tinymachines/nes-bench/docs/b0-report.md

# B0 report: the sniff, machine side closed, the part's side waiting on the build

Written 2026-09-06. Plan: `docs/bench-plan.md`, first. Nothing here has
touched the part yet: the bridge is not built. What closed is
everything B0 could close on the machine, and one thing B0 was going
to measure on the part turned out to be measurable on the die first,
which changed the model.

## What exists

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

## Added 2026-09-07: the head, and the script on both sides

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

## Added 2026-09-07: the B1 tool, green on the synthesis before any capture

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

Its own green run (`SYNTH_TRIGGER=1`): six frames synthesised through
the card model, the fourth scored, the synthesis sliced from inside the
third as a trigger placed there would be, 13 of 13 regions on the bars
cartridge at every frame count tried across its luma-row step.
`MUTATE_TRIGGER=1` slices one frame late and is 1 of 13 at the step
(frames 122), which is what shows the frame selection is checked and
not only the colours; the public site's boarding runs both and refuses
to board if the mutation is not red. `nes` @ 59d42c8.

## Added 2026-09-07: the B2 classifier, green on its own synthesis

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

Its gate (`selftest`): the three channels synthesised for 72
alignments at the head's three-channel rate with the measured pin
offsets, every one read back as its class; the synthesised ALE shifted
one half-step (MUTATE) moves the class on all 24. Then the whole path
through the head: `tools/fake-scope.py` answers the head's SCPI with
those synthesised records, a B2 script (power off, arm three channels
on ALE's first rise, power on, capture) played three times by `sweep`,
each run fetched and classified as the alignment the fake was given.
The head's ARM took a channel list, a trigger source, a timebase and a
depth for it (the DS1054Z holds 6 M points at most with three channels,
so B2's window is 6 ms at 1.2 M; B1's stays 60 ms at 12 M on one).

What only the bench can say: whether the part's histogram over a
hundred power-ons is flat over its classes or prefers some, which is
B2's first gate, and whether the model's (4, 3) is among them.

## Added 2026-09-07: the B3 tools, a planted divergence found

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

## What the die said before the part could

The gate asked for clocks per latch on the part, expecting nine where
a DMC fetch lands on a poll's read. That is a question the switch-level
2A03 can answer, so it was asked first (`2a03`'s
`joy-clock-probe`, `docs/n3-report.md` there):

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

Three changes followed, each with a test that fails without it:

- Rung 3 of the 6502 (`tinymachines/6502` @ 89ae24f) re-asks its bus
  at every phi2 of a read held by RDY and keeps the last byte, which is
  what DL does; `MUTATE_HELD=1` keeps the first and is red.
- The 2A03's rung (`tinymachines/2a03` @ dbf116b) answers those re-asks
  from a memo while the core is held and lets one through on the
  re-run, unless the alias rule holds; `tests/joypad.rs` holds the
  rung's asks per instruction to the die's /OE1 pulses over two
  cadences, {1: 2820, 2: 6} and {1: 2245, 2: 4}, instruction for
  instruction; `MUTATE_QUIET=1` (five asks per collision) is red.
- The console (`tinymachines/nes` @ 2ec0fc3) logs polls; on the
  polling cartridge with the DMC loop the model predicts nine-read
  polls at 21 of 596 latches over 600 frames, recorded in
  `tests/pad_log.rs`.

So the B0 gate's third bullet, the model's DMC fetch schedule beside
the part's nine-clock polls, now has a prediction with an exception the
documentation does not mention. The part decides.

## What B0 still needs from the bench

In the plan's order, once the bridge is built per `docs/wiring.md` and
its "measure first" list is done:

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

None of it can be faked here, and the report says so.
