tinymachines/nes-bench/docs/IMG_5660.jpeg

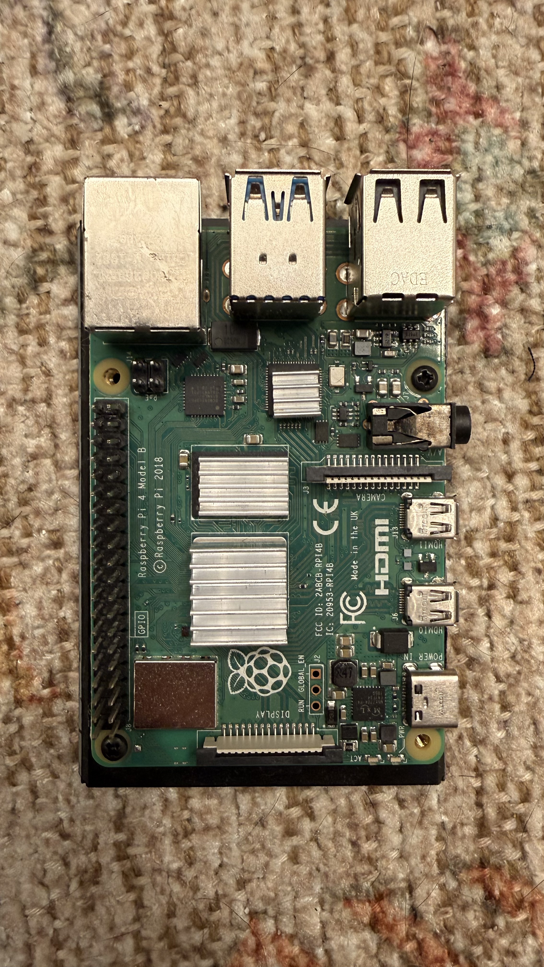
docs/IMG_5660.jpeg
