tinymachines/nes-bench/docs/IMG_5661.jpeg

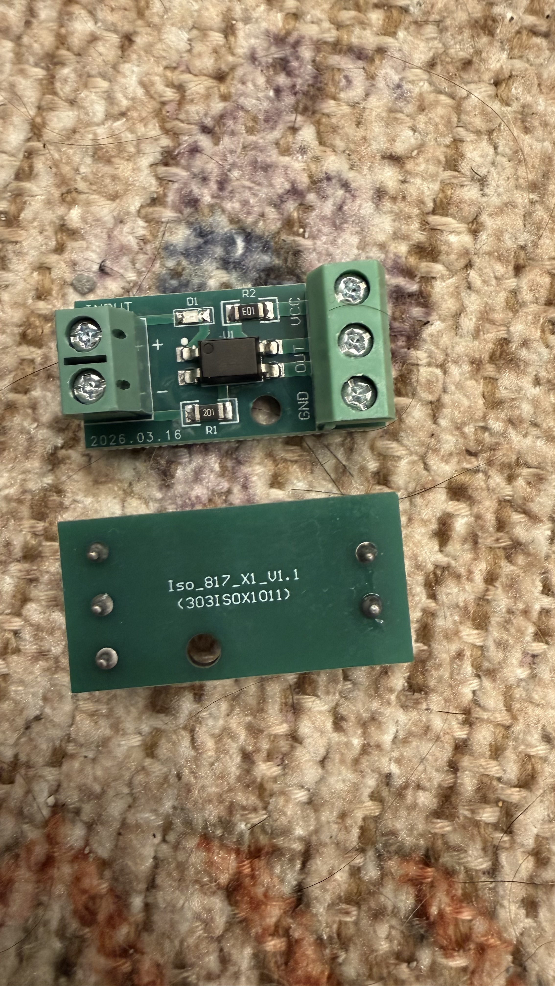
docs/IMG_5661.jpeg
