tinymachines/nes-bench/docs/IMG_5662.jpeg

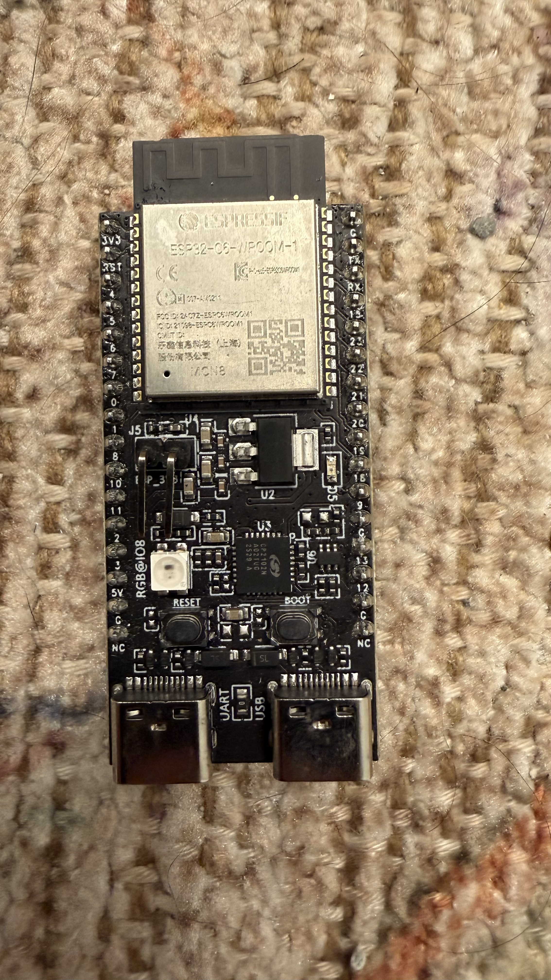
docs/IMG_5662.jpeg
