tinymachines/nes-bench/docs/IMG_5664.jpeg

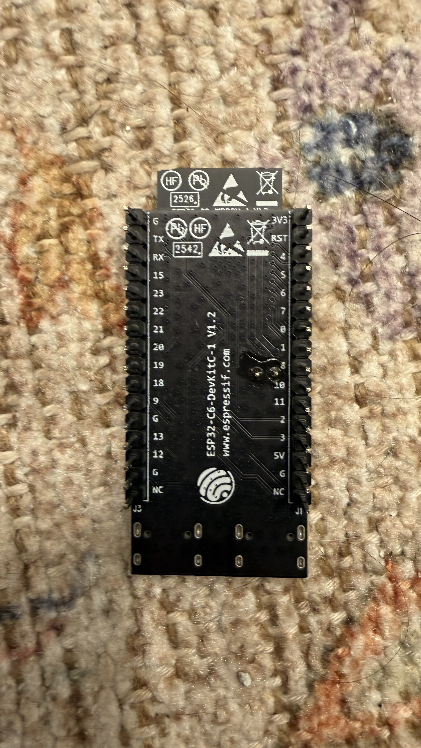
docs/IMG_5664.jpeg
