tinymachines/nes-bench/docs/IMG_5665.jpeg

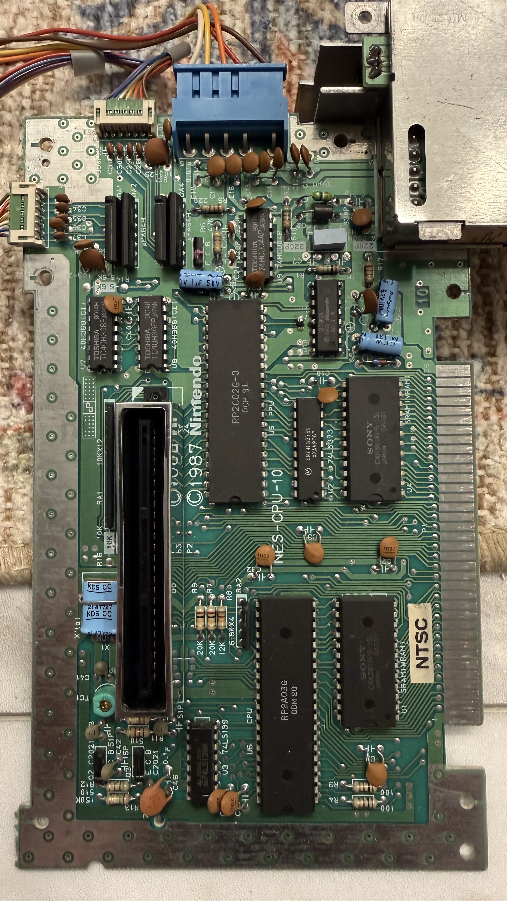
docs/IMG_5665.jpeg
