tinymachines/nes-bench/docs/IMG_5666.jpeg

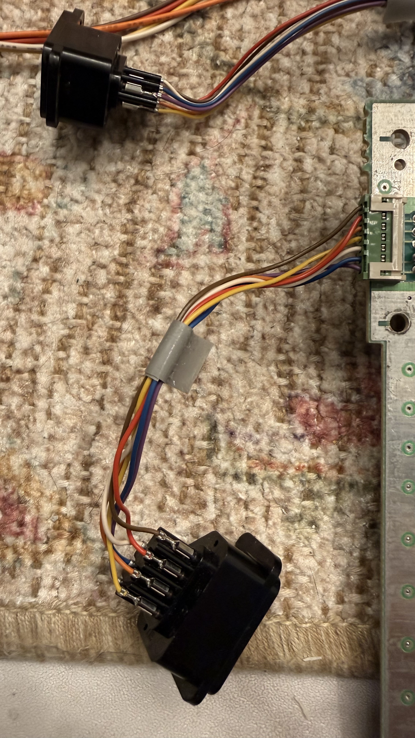
docs/IMG_5666.jpeg
