tinymachines/nes-bench/docs/IMG_5667.jpeg

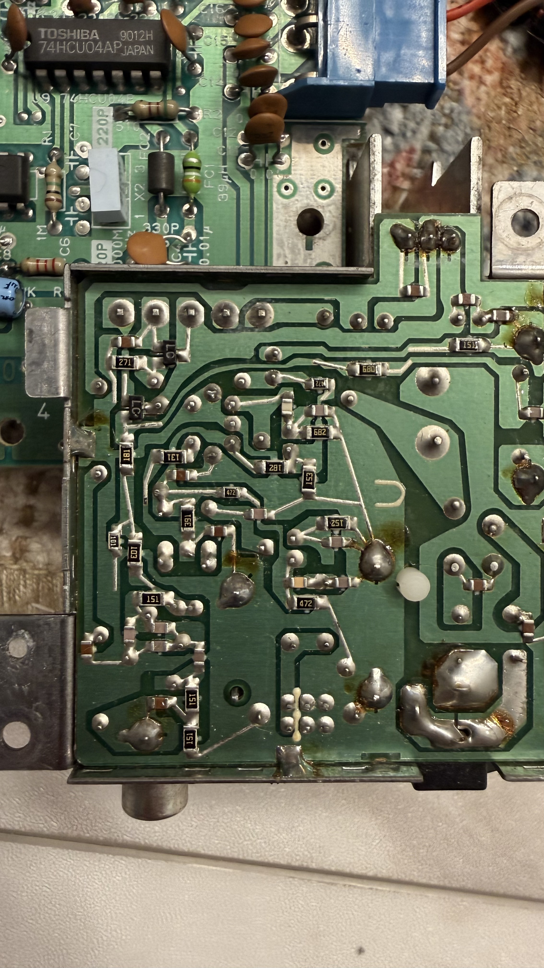
docs/IMG_5667.jpeg
