tinymachines/nes-bench/docs/IMG_5668.jpeg

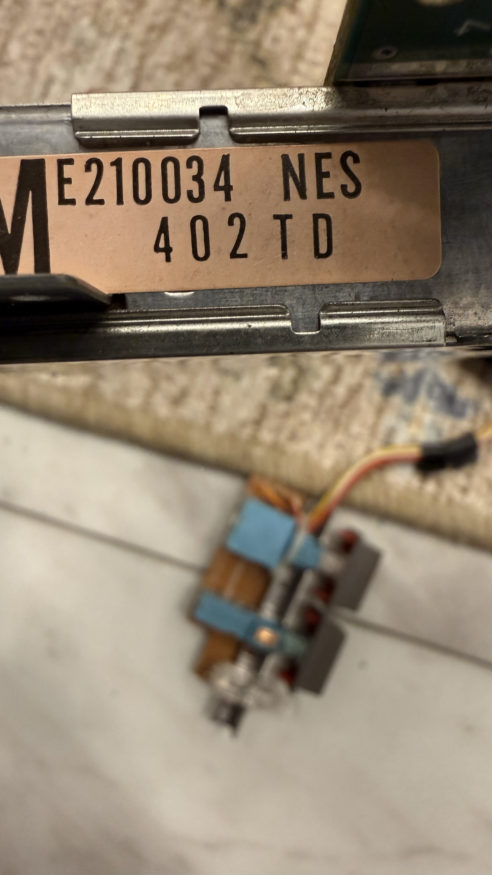
docs/IMG_5668.jpeg
