tinymachines/nes-bench/docs/IMG_5669.jpeg

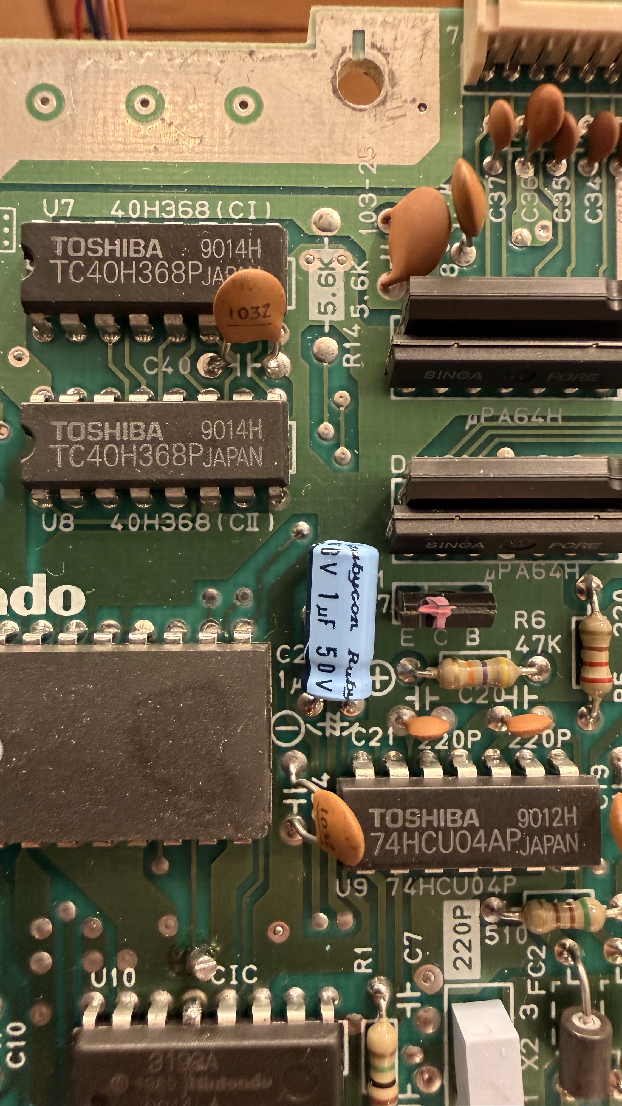
docs/IMG_5669.jpeg
