tinymachines/nes-bench/docs/IMG_5670.jpeg

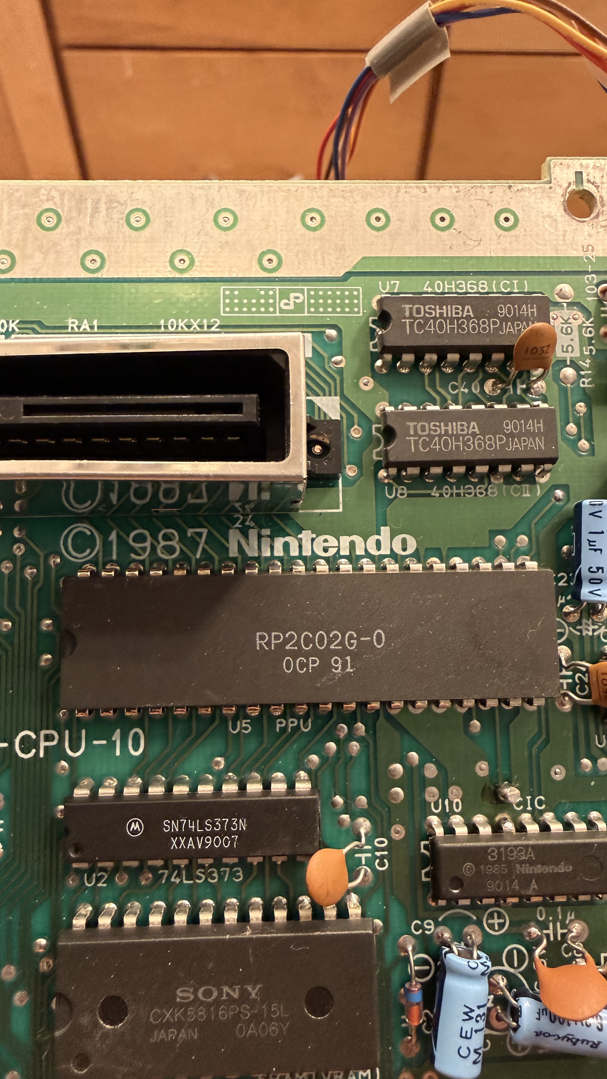
docs/IMG_5670.jpeg
