tinymachines/nes-bench/docs/IMG_5671.jpeg

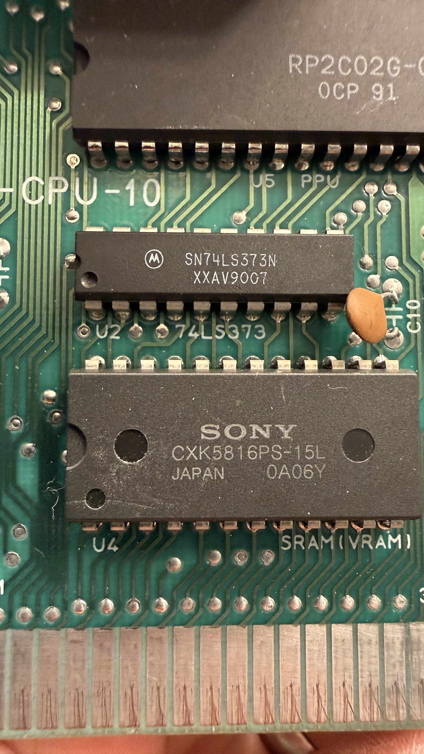
docs/IMG_5671.jpeg
