tinymachines/nes-bench/docs/IMG_5672.jpeg

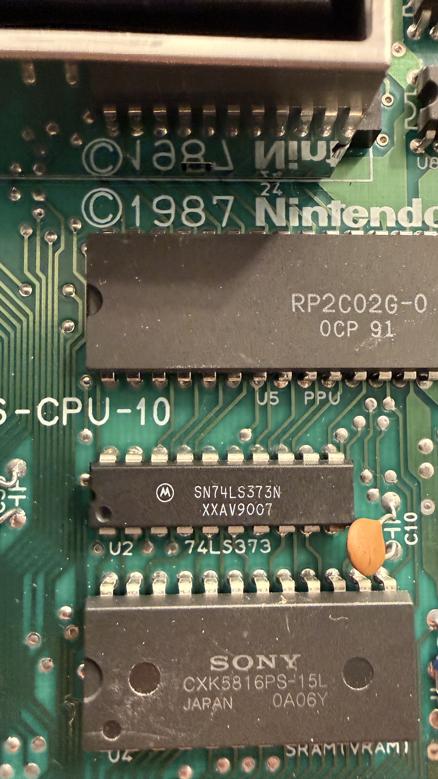
docs/IMG_5672.jpeg
