tinymachines/nes-bench/docs/IMG_5673.jpeg

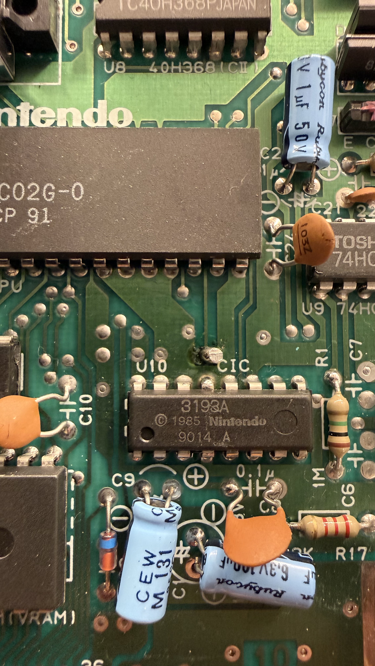
docs/IMG_5673.jpeg
