tinymachines/nes-bench/docs/IMG_5674.jpeg

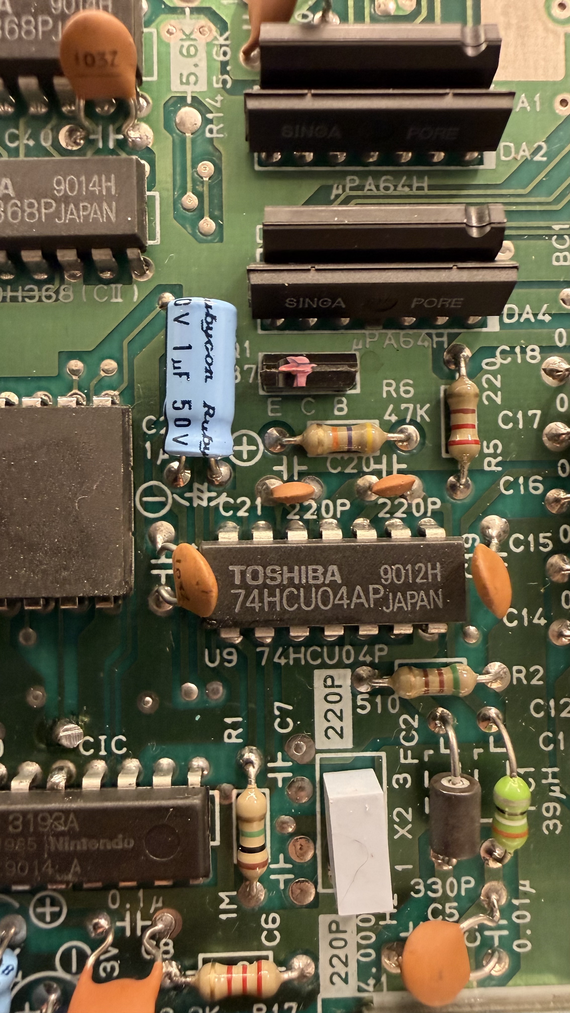
docs/IMG_5674.jpeg
