tinymachines/nes-bench/docs/IMG_5675.jpeg

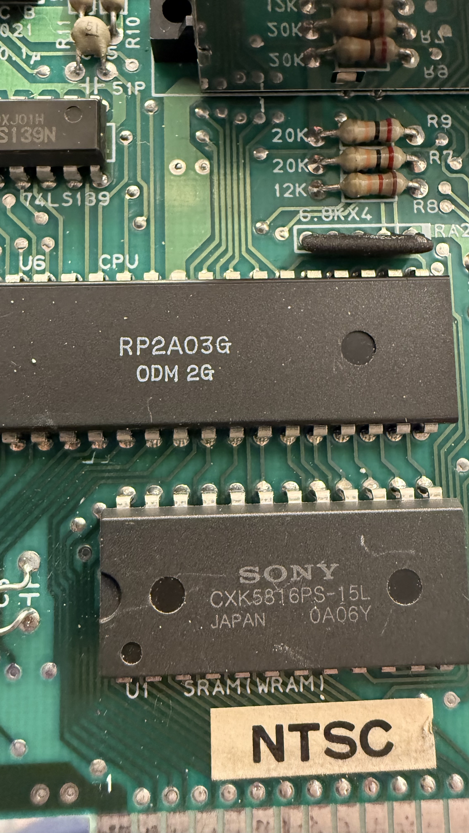
docs/IMG_5675.jpeg
