tinymachines/nes-bench/docs/lab/06-modules-laid-out.jpg

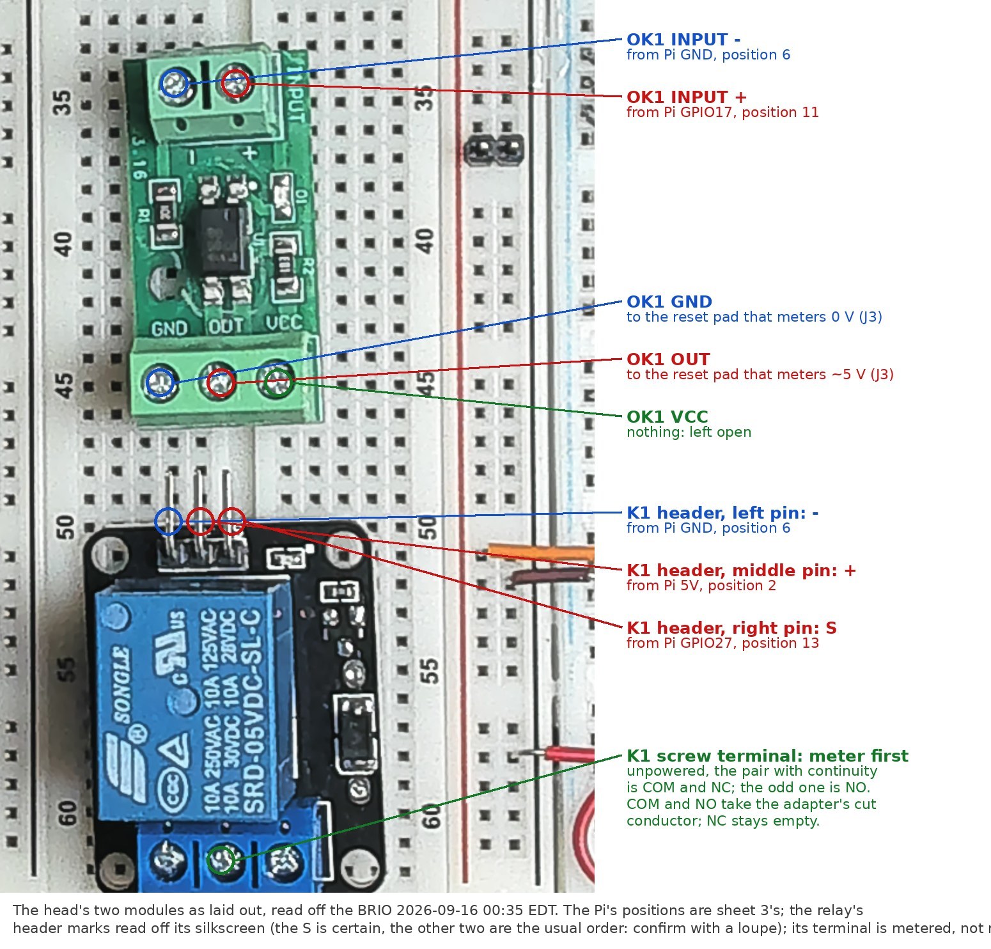
docs/lab/06-modules-laid-out.jpg
