tinymachines/nes-bench/docs/lab/rig-side-eye-9000.jpg

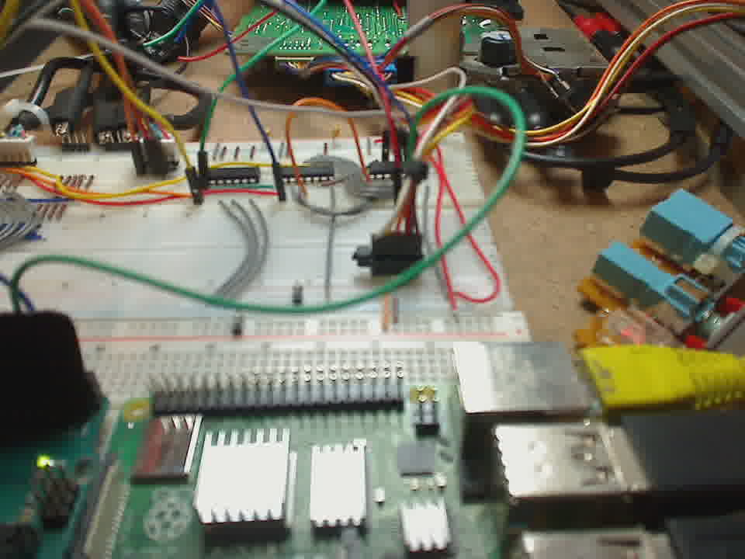
docs/lab/rig-side-eye-9000.jpg
