tinymachines/nes-bench/docs/lab/rig-side-eye-communicate.jpg

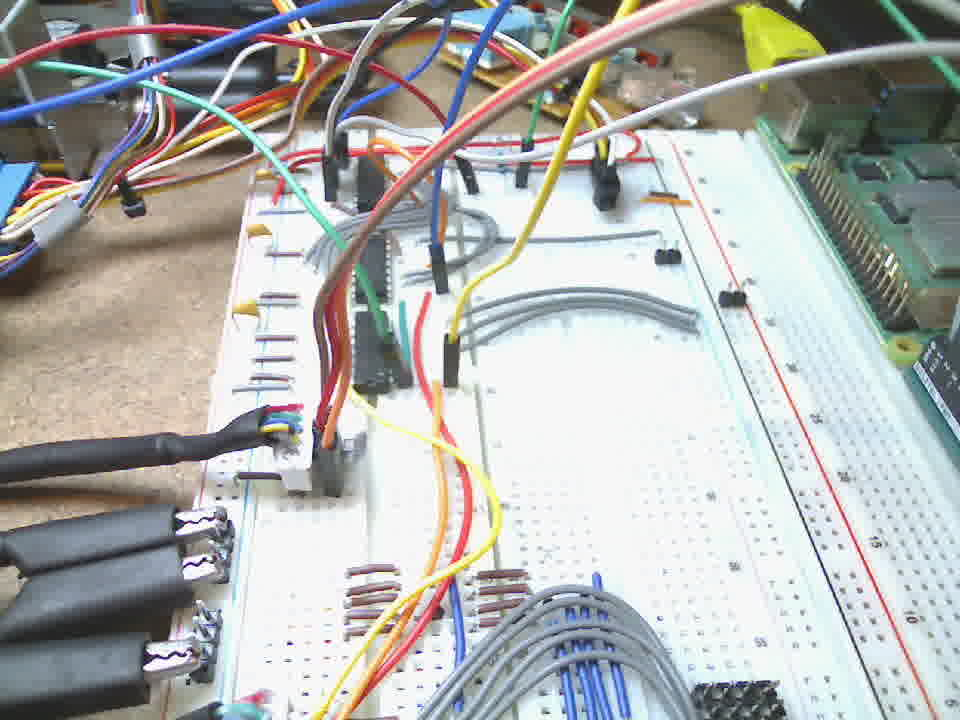
docs/lab/rig-side-eye-communicate.jpg
