tinymachines/nes-bench/firmware/bridge-uno/bridge-uno.ino

// The bridge, v1b: an Arduino UNO between the console's controller port
// and an original pad (docs/bench-v1b-uno.md, docs/bench-v1b.svg). The
// ATmega328P is a 5 V part, so the console, the register and the pad
// all sit in one voltage domain and no level shifter exists on the
// board. That is the whole reason this version is built before the
// ESP32-C6 one in firmware/bridge/: the 74HC parts that arrived need a
// 3.5 V high at 5 V, which a 3.3 V GPIO does not give.
//
// The line protocol is byte-for-byte the C6's (docs/script.md), so
// head/headd.py and every tool need nothing but the serial speed:
//
//   L <latch index> <byte the register held> <clocks the poll took>
//
//   MODE PASS        the original pad's state goes to the register (default)
//   MODE INJECT      the register holds SET's byte, or the AT schedule's
//   SET hh           the byte to hold now (bit 0 = A, set = pressed)
//   AT n hh          from latch n on, hold hh (in increasing n; see below).
//                    The schedule is a ring: an applied entry frees its
//                    slot, so the head can stream a run longer than it
//                    (schedule.h). An AT for a latch already gone is
//                    refused with "# late AT n at latch L"
//   TRIG n           raise the trigger pin at latch n for a millisecond
//   RESET            zero the latch index, clear the schedule and the trigger
//   STATUS           one line: mode, latch index, byte, pad byte, schedule size
//   MUTATE ON|OFF    the clock counter is fed the LATCH line: the
//                    clocks-per-latch check must go red (B0's mutation)
//
// Nothing here is measured yet: B0 of docs/bench-plan.md is where this
// meets the part. Build:
//
//   arduino-cli compile --fqbn arduino:avr:uno firmware/bridge-uno
//   arduino-cli upload  --fqbn arduino:avr:uno -p /dev/ttyACM0 firmware/bridge-uno
//
// THREE THINGS THE ATmega328P FORCES THAT THE C6 DID NOT, each of which
// would have been a silent wrong answer rather than a build error:
//
//  1. There is no Serial.printf on the AVR core, and avr-libc's printf
//     carries no 64-bit conversion. The C6 sketch's uint64_t counters
//     and %llu would compile to nothing useful. Everything here is
//     uint32_t and %lu: the latch index wraps after 2.2 years at 60
//     polls a second, the clock count after 103 days at 480 a second.
//  2. The C6's 2048-entry schedule is 32 KB. This part has 2 KB of SRAM
//     in total. With five-byte entries (a uint32_t latch and a byte)
//     SCHEDULE_MAX was 128: at 256 the compiler reported 2161 bytes of
//     globals, 105 percent, and refused to link; at 128, 1521 bytes and
//     527 for the stack. A hand's minute of Super Mario Bros. is 289
//     changes of byte (run 20260919-012524), so since 2026-09-19 the
//     schedule is packed (schedule.h): each entry is the gap from the
//     previous one in a byte and the byte to hold, two bytes, with a
//     filler entry per 255 latches of a longer gap, and every string
//     literal lives in flash (on the AVR a plain literal is copied into
//     RAM at boot): 600 entries, with the stack's room what it was at
//     128, and the protocol still carries absolute latches. A record that still does
//     not fit gets "# schedule full" and is refused by tools/b3.py before
//     the run rather than replayed with its tail missing. STATUS reports
//     the stack bytes the run has never touched (painted at boot), so the
//     margin is a measurement, not the compiler's estimate.
//  3. Timer1's external clock input is the T1 pin and nothing else, so
//     the latch line has to be D5. That is not a preference.

#include <SPI.h>
#include "schedule.h"

// ------------------------------------------------------------- pins
// Per docs/bench-v1b-uno.md's table and the A1 chip on the v1b sheet,
// which tools/check-sheets.py holds equal to each other.
static const uint8_t PIN_RCLK      = 10;  // 74HC595 RCLK: one rise moves the byte
static const uint8_t PIN_CON_LATCH = 5;   // console OUT0. Timer1's T1 input; also readable as a level
static const uint8_t PIN_CON_CLOCK = 2;   // console CLK (/OE1). INT0
static const uint8_t PIN_TRIG      = 3;   // to the scope's EXT TRIG through R1
static const uint8_t PIN_PAD_LATCH = 6;
static const uint8_t PIN_PAD_CLOCK = 7;
static const uint8_t PIN_PAD_DATA  = 8;
// D11 MOSI and D13 SCK belong to the SPI peripheral; D0 and D1 to the
// serial port. The console's D0 line is the 165's output and is not
// monitored on this build, as on the C6.
static const int CON_DATA = -1;

// 600 * 2 bytes = 1200 of the 2048. What paid for it: the entries went
// from five bytes to two (320 in the 640 bytes 128 had), and every
// string literal moved to flash, which took the globals from 1615 bytes
// to 967 with 320 entries. 600 leaves the stack what the 128-entry
// build ran on for months (about 515 bytes by the compiler); STATUS's
// untouched stack is the measurement. tools/b3.py reads this number.
static const int SCHEDULE_MAX = 600;

static Schedule<SCHEDULE_MAX> schedule;   // a cursor, not a scan: AT arrives in order

enum Mode { PASS, INJECT };
static Mode mode = PASS;
static bool mutated = false;
static uint8_t held = 0;          // what the register's inputs show now
static uint8_t set_byte = 0;      // SET's byte for INJECT
static uint8_t pad_byte = 0;      // the original pad's last poll
static uint32_t latches = 0;      // the latch index (rises seen since RESET)
static uint32_t clocks = 0;       // clocks seen since RESET
static uint32_t clocks_at_latch = 0;
static uint8_t byte_at_latch = 0;
static bool have_latch = false;
static uint16_t last_tcnt = 0;
static uint32_t last_rises = 0;
static long trig_at = -1;
static unsigned long trig_until = 0;
static uint16_t deferred_writes = 0;
static uint16_t torn_writes = 0;  // the load window opened across the RCLK edge
static bool torn_pending = false;

// The clock counter. INT0 feeds it normally; under MUTATE the LATCH
// line's pin-change interrupt feeds it instead, which is B0's stated
// sabotage ("the bridge's clock counter fed the latch line") done in
// software, with no jumper to forget to move back.
static volatile uint32_t clock_edges = 0;

static void clock_isr() { if (!mutated) clock_edges++; }

// D5 is PD5, which is PCINT21. Rises only, so a mutated run reports one
// "clock" per latch instead of eight and the 8-per-latch gate is red.
//
// The same rise is where the clock count has to be read. MEASURED
// 2026-09-15 on the bench: the loop used to read Timer1 (the latch) and
// clock_edges (the clocks) a few instructions apart, and with the
// console's clocks 13 us apart and the loop busy printing, the count it
// booked to a poll included clocks of the next one. The L lines came
// out scattered from 0 to 16 in neighbours that summed to 16 while the
// running totals were exactly eight a latch. So the clock count is
// captured here, at the latch's own edge, and the loop reads the
// snapshot: clocks_at_rise is the clock count when the latest latch
// rose, rises the number of rises the interrupt has seen.
//
// A rise is told from a fall by Timer1, not by reading the pin: the
// pulse is 3.6 us wide (MEASURED 2026-09-15) and a pin-change interrupt
// held off by the serial port's own can arrive after it has ended,
// when the pin reads low again. The first build of this read the pin
// and missed 7 latches in 1,202 that way (a 0 followed by a 16).
// Timer1 counts the rises in hardware whatever the latency, so the
// interrupt asks it whether the count moved.
static volatile uint32_t clocks_at_rise = 0;
static volatile uint32_t rises = 0;
static volatile uint16_t tcnt_in_isr = 0;
ISR(PCINT2_vect) {
  uint16_t c = TCNT1;
  if (c == tcnt_in_isr) return;          // a fall, or a rise already booked
  if (mutated) clock_edges += (uint16_t)(c - tcnt_in_isr);
  tcnt_in_isr = c;
  clocks_at_rise = clock_edges;
  rises++;
}

// --------------------------------------------------------- register
// The 74HC595's QA..QH feed the 74HC165's H..A, and the 165 shifts H
// out first, so QA is the A button. SPI is MSB first: the first bit
// sent travels furthest and lands on QH, the last bit sent stays on QA.
// So sending bit 7 first puts our bit 0 on QA, which is what we want.
// The register is active low (pressed = LOW), hence the complement.
// Get either of those backwards and the pad is silently mirrored.
static inline uint8_t reg_byte_for(uint8_t b) { return (uint8_t)~b; }

// The 165 loads while OUT0 is HIGH, so its inputs must not move inside
// that window. Shifting into the 595 is free (its outputs do not move
// until RCLK), so the only thing that must land outside the window is
// the RCLK edge itself, which is one instruction, 62.5 ns. Check the
// line before and after it; if the window opened across that edge, say
// so on the next L line rather than pretending the byte was clean.
static bool write_register(uint8_t b) {
  if (digitalRead(PIN_CON_LATCH) == HIGH) { deferred_writes++; return false; }
  SPI.transfer(reg_byte_for(b));
  if (digitalRead(PIN_CON_LATCH) == HIGH) { deferred_writes++; return false; }
  PORTB |= _BV(PB2);   // D10 high
  PORTB &= ~_BV(PB2);  // and low again
  held = b;
  if (digitalRead(PIN_CON_LATCH) == HIGH) { torn_writes++; torn_pending = true; }
  return true;
}

// -------------------------------------------------------------- pad
// The original pad on the bridge's own lines, at the 5 V it was built
// for, polled the way the console polls it but at leisure.
static uint8_t poll_pad() {
  digitalWrite(PIN_PAD_LATCH, HIGH);
  delayMicroseconds(12);
  digitalWrite(PIN_PAD_LATCH, LOW);
  delayMicroseconds(6);
  uint8_t b = 0;
  for (uint8_t i = 0; i < 8; i++) {
    if (digitalRead(PIN_PAD_DATA) == LOW) b |= (uint8_t)(1 << i);
    digitalWrite(PIN_PAD_CLOCK, HIGH);
    delayMicroseconds(6);
    digitalWrite(PIN_PAD_CLOCK, LOW);
    delayMicroseconds(6);
  }
  return b;
}

static uint8_t scheduled_byte() {
  schedule.due(latches, set_byte);
  return set_byte;
}

// ------------------------------------------------------------ stack
// Every byte between the end of the globals and the stack is painted at
// boot; STATUS counts the painted bytes still intact from the bottom up,
// the stack's deepest reach since boot read as what it never touched.
extern uint8_t __bss_end;
static const uint8_t PAINT = 0x5A;
static void paint_stack() {
  uint8_t *p = &__bss_end;
  uint8_t *top = (uint8_t *)SP - 32;   // leave setup's own frame alone
  while (p < top) *p++ = PAINT;
}
static uint16_t stack_untouched() {
  uint8_t *p = &__bss_end;
  uint16_t n = 0;
  while (p < (uint8_t *)SP && *p == PAINT) { p++; n++; }
  return n;
}

// ---------------------------------------------------------- commands
static char line[64];
static uint8_t line_len = 0;

// Every literal lives in flash (F(), PSTR(), the _P functions): on the
// AVR a plain string literal is copied into RAM at boot, and the
// messages here cost more RAM than a third of the schedule.
static void say(const char *s) { Serial.println(s); }
static void sayF(const __FlashStringHelper *s) { Serial.println(s); }

static void handle(char *s) {
  while (*s == ' ') s++;
  for (char *e = s + strlen(s); e > s && (e[-1] == '\r' || e[-1] == ' '); e--) e[-1] = 0;
  char out[64];
  if (!strcmp_P(s, PSTR("MODE PASS"))) { mode = PASS; sayF(F("# mode pass")); }
  else if (!strcmp_P(s, PSTR("MODE INJECT"))) { mode = INJECT; sayF(F("# mode inject")); }
  else if (!strncmp_P(s, PSTR("SET "), 4)) {
    set_byte = (uint8_t)strtoul(s + 4, NULL, 16);
    snprintf_P(out, sizeof out, PSTR("# set %02x"), set_byte); say(out);
  }
  else if (!strncmp_P(s, PSTR("AT "), 3)) {
    char *end;
    unsigned long n = strtoul(s + 3, &end, 10);
    unsigned long b = strtoul(end, NULL, 16);
    // An entry for a latch already gone would play at once, at the wrong
    // latch, and the run would go on looking healthy: refused by name, so
    // a head that streams too slowly stops the run instead (2026-10-18).
    if (n < latches) {
      snprintf_P(out, sizeof out, PSTR("# late AT %lu at latch %lu"), n, latches); say(out);
      return;
    }
    int r = schedule.append((uint32_t)n, (uint8_t)b);
    if (r == 0) { snprintf_P(out, sizeof out, PSTR("# at %lu %02lx"), n, b); say(out); }
    else if (r == 1) sayF(F("# schedule full"));
    else { snprintf_P(out, sizeof out, PSTR("# ? AT %lu before the schedule's last latch"), n); say(out); }
  }
  else if (!strncmp_P(s, PSTR("TRIG "), 5)) {
    trig_at = strtol(s + 5, NULL, 10);
    snprintf_P(out, sizeof out, PSTR("# trig at %ld"), trig_at); say(out);
  }
  else if (!strcmp_P(s, PSTR("RESET"))) {
    uint8_t sreg = SREG; cli();
    latches = 0; clock_edges = 0; last_tcnt = TCNT1; tcnt_in_isr = last_tcnt; clocks_at_rise = 0; rises = 0; last_rises = 0;
    SREG = sreg;
    clocks = 0; clocks_at_latch = 0; have_latch = false;
    schedule.clear(); trig_at = -1;
    deferred_writes = 0; torn_writes = 0; torn_pending = false;
    sayF(F("# reset"));
  }
  else if (!strcmp_P(s, PSTR("STATUS"))) {
    snprintf_P(out, sizeof out, PSTR("# mode %S latch %lu clocks %lu held %02x"),
             mode == PASS ? PSTR("pass") : PSTR("inject"), latches, clocks, held); say(out);
    snprintf_P(out, sizeof out, PSTR("# pad %02x schedule %d/%d data %d deferred %u torn %u mutate %S"),
             pad_byte, schedule.len, SCHEDULE_MAX, CON_DATA, deferred_writes, torn_writes,
             mutated ? PSTR("on") : PSTR("off")); say(out);
    snprintf_P(out, sizeof out, PSTR("# stack %u bytes never touched"), stack_untouched()); say(out);
  }
  else if (!strcmp_P(s, PSTR("MUTATE ON")) || !strcmp_P(s, PSTR("MUTATE OFF"))) {
    mutated = !strcmp_P(s, PSTR("MUTATE ON"));
    if (mutated) sayF(F("# mutate on: the clock counter is fed the latch line"));
    else sayF(F("# mutate off: the counters on their own lines"));
  }
  else if (*s) { snprintf_P(out, sizeof out, PSTR("# ? %.58s"), s); say(out); }
}

// ------------------------------------------------------------- setup
void setup() {
  paint_stack();
  Serial.begin(115200);

  pinMode(PIN_RCLK, OUTPUT);
  digitalWrite(PIN_RCLK, LOW);
  SPI.begin();
  SPI.beginTransaction(SPISettings(4000000, MSBFIRST, SPI_MODE0));
  // Nothing pressed until told: all eight register inputs high.
  SPI.transfer(reg_byte_for(0));
  PORTB |= _BV(PB2); PORTB &= ~_BV(PB2);
  held = 0;

  // Pulled up, not bare. MEASURED on the bench 2026-09-08: with nothing
  // on D5 the Timer1 input floats and the counter, which is hardware and
  // asks no questions, took 3,647 "latches" in three seconds, about
  // 1.2 kHz of noise. A run begun before the console is powered would
  // carry a latch index that means nothing, and B0's gate counts
  // latches. The console drives both lines hard when it is on, so a
  // 30 kilohm internal pull-up costs it nothing and gives the pins a
  // defined level when it is off or unplugged. CLK idles high anyway.
  pinMode(PIN_CON_LATCH, INPUT_PULLUP);   // T1 needs it as an input
  pinMode(PIN_CON_CLOCK, INPUT_PULLUP);
  pinMode(PIN_PAD_LATCH, OUTPUT);
  pinMode(PIN_PAD_CLOCK, OUTPUT);
  pinMode(PIN_PAD_DATA, INPUT_PULLUP);
  pinMode(PIN_TRIG, OUTPUT);
  digitalWrite(PIN_TRIG, LOW);

  // Timer1 counting the latch line in hardware: external clock on T1,
  // rising edge, no prescaler in the path and no timer interrupt. The
  // edge is sampled against the 16 MHz clock, so a pulse shorter than
  // 62.5 ns would be missed; the console's latch is microseconds wide.
  TCCR1A = 0;
  TCCR1B = _BV(CS12) | _BV(CS11) | _BV(CS10);
  TIMSK1 = 0;
  TCNT1 = 0;
  last_tcnt = 0;

  attachInterrupt(digitalPinToInterrupt(PIN_CON_CLOCK), clock_isr, FALLING);
  // The mutation's path, armed but inert while mutated is false.
  PCMSK2 |= _BV(PCINT21);
  PCICR |= _BV(PCIE2);

  sayF(F("# nes-bench bridge v1b (UNO, all 5 V): B0 sniff; MODE PASS"));
}

// -------------------------------------------------------------- loop
void loop() {
  static unsigned long last_pad_poll = 0;
  char out[64];

  while (Serial.available()) {
    char c = (char)Serial.read();
    if (c == '\n') { line[line_len] = 0; handle(line); line_len = 0; }
    else if (line_len < sizeof(line) - 1) line[line_len++] = c;
  }

  unsigned long now = micros();
  if (now - last_pad_poll >= 1000) { last_pad_poll = now; pad_byte = poll_pad(); }

  // The console's pulses first, so a latch is logged with the byte the
  // register held at it, before any new byte is written.
  // The latch count and the clock snapshot are the interrupt's pair,
  // read in one breath: rises and clocks_at_rise were written together
  // at the latch's edge. Reading Timer1 here instead paired a poll with
  // the snapshot of the one before whenever the loop looked between the
  // counter's step and the interrupt that follows it (2 of 1,202 polls
  // came out as a 0 and a 16 that way, MEASURED 2026-09-15).
  uint32_t seen, edges, at_rise;
  uint8_t sreg = SREG; cli(); seen = rises; edges = clock_edges; at_rise = clocks_at_rise; SREG = sreg;
  uint16_t dl = (uint16_t)(seen - last_rises);
  last_rises = seen;
  clocks = edges;

  if (dl > 0) {
    // The poll that just ended took the clocks between the previous
    // latch's rise and this one's, both read at the edge by the
    // interrupt above, not whatever the loop sees now.
    if (have_latch) {
      snprintf_P(out, sizeof out, PSTR("L %lu %02x %lu"), latches - 1, byte_at_latch, at_rise - clocks_at_latch);
      say(out);
      if (torn_pending) { sayF(F("# the load window opened across an RCLK edge: the byte above may be torn")); torn_pending = false; }
    }
    if (dl > 1) { snprintf_P(out, sizeof out, PSTR("# %u latches in one look at %lu"), dl, latches); say(out); }
    latches += dl;
    clocks_at_latch = at_rise;
    byte_at_latch = held;
    have_latch = true;
    if (trig_at >= 0 && (uint32_t)trig_at < latches) {
      digitalWrite(PIN_TRIG, HIGH);
      trig_until = millis() + 1;
      trig_at = -1;
      snprintf_P(out, sizeof out, PSTR("# trigger at latch %lu"), latches - 1); say(out);
    }
  }
  if (trig_until && millis() >= trig_until) { digitalWrite(PIN_TRIG, LOW); trig_until = 0; }

  uint8_t want = (mode == PASS) ? pad_byte : scheduled_byte();
  if (want != held) write_register(want);
  delayMicroseconds(100);
}
