tinymachines/nes-bench/head/headd.py

#!/usr/bin/env python3
"""The head: the bench under one script, on the Raspberry Pi.

  python3 head/headd.py --bridge /dev/ttyUSB0 --scope <ip> [--port 6530] [--runs runs]
  python3 head/headd.py --bridge <pty from tools/fake-bridge.py> --no-gpio --no-scope

One process, three sides. The workstation side is UDP: a JSON request
per datagram, a JSON reply per datagram (`tools/bench.py` is the
client). The bridge side is the firmware's line protocol over serial,
every line it prints appended to the run's `bridge.log`. The bench
side is the Pi's own pins for the reset and power relays and SCPI over
the LAN to the scope, in the dialect ntsc-crt's `scope-capture.py`
proved on the same instrument.

A run is one script (docs/script.md), played line by line into a
directory `runs/<stamp>/`: `script.txt` as received, `bridge.log`,
`head.log` (each line as it was played, with the wall time), and any
captures as `<name>.u8` beside `<name>.toml` in the format ntsc-crt's
recovery ingests. The client fetches the directory over the head's own
HTTP listing on the port after the UDP one.

Requests: {"op": "status"}, {"op": "run", "script": "..."} (starts a
run; refused while one plays), {"op": "abort"}, {"op": "bridge",
"line": "STATUS"} (one line straight to the bridge, its replies within
half a second returned), {"op": "runs"} (the run directories), and
{"op": "pad", "action": "on"|"off"|"status"} (a gamepad on this Pi's
own Bluetooth driving the console's byte; it takes a run directory of
its own and is refused while a script plays, because both drive the
same byte).

Addresses come from the command line or bench.local.md, never from a
file that is committed. The scope belongs to another experiment when
this is not running: its setup is saved before the first command that
changes it and restored after every capture, exactly as scope-capture
does. Nothing here has met the part; the fake bridge and --no-gpio /
--no-scope are what it has run against.
"""
import argparse
import http.server
import json
import os
import select
import socket
import socketserver
import sys
import threading
import time
from collections import deque
from pathlib import Path

# The gamepad hand lives beside this file. Named explicitly rather than
# relying on the script directory, so headd can also be imported.
sys.path.insert(0, str(Path(__file__).resolve().parent))
import pad  # noqa: E402

try:
    import serial
except ImportError:  # the fake bridge's pty works through os as well
    serial = None

RESET_HOLD_S = 0.5   # MEASURED 2026-09-17: a 100 ms and a 250 ms hold left no
                     # mark the bench could see, a 500 ms one paused the console's
                     # polls 0.5 s. The instrument's floor is about half a second
                     # (the Pi's bridge hands poll lines over in ~100 ms batches),
                     # so a shorter pulse may well reset it; 0.5 s is the shortest
                     # hold this bench can confirm
PCNT_LIMIT = None  # the firmware's business; the head only reads its lines


# ----------------------------------------------------------------- bridge
class Bridge:
    """The firmware over its serial line: lines out, lines in, a log."""

    def __init__(self, path, baud=921600):
        self.path = path
        if serial is not None and not path.startswith("/dev/pts/"):
            self.ser = serial.Serial(path, baud, timeout=0.05)
            self.read = self.ser.read
            self.write = self.ser.write
        else:
            # A pty (the fake bridge): plain file descriptors.
            import tty
            self.fd = os.open(path, os.O_RDWR | os.O_NOCTTY | os.O_NONBLOCK)
            tty.setraw(self.fd)
            self.read = self._read_fd
            self.write = self._write_fd
        self.buf = b""
        self.lines = []          # every line, in order (the run drains it)
        self.latest_latch = -1   # the last L line's index
        self.lock = threading.Lock()
        self.stop = False
        self.thread = threading.Thread(target=self._pump, daemon=True)
        self.thread.start()

    def _write_fd(self, b):
        while b:
            try:
                n = os.write(self.fd, b)
                b = b[n:]
            except BlockingIOError:
                time.sleep(0.002)

    def _read_fd(self, n):
        try:
            return os.read(self.fd, n)
        except BlockingIOError:
            return b""

    def _pump(self):
        # Lines nobody drains (no run playing) are kept only up to a
        # bound, so an idle head does not grow without limit.
        while not self.stop:
            data = self.read(4096)
            if not data:
                time.sleep(0.005)
                continue
            self.buf += data
            while b"\n" in self.buf:
                raw, self.buf = self.buf.split(b"\n", 1)
                line = raw.decode(errors="replace").rstrip("\r")
                with self.lock:
                    self.lines.append(line)
                    if len(self.lines) > 100_000:
                        del self.lines[:50_000]
                    # The bridge's acknowledgement of RESET: its counters are
                    # zero from here, in the order it printed, so every L line
                    # before this one is the last session's. Without this a
                    # WAIT n after a RESET returned at once whenever the
                    # session before had passed latch n (found 2026-09-18:
                    # a cold-power script captured at latch ~190 of a
                    # WAIT 400, the head still holding 2773 from the morning).
                    if line == "# reset":
                        self.latest_latch = -1
                    if line.startswith("L "):
                        f = line.split()
                        if len(f) == 4:
                            self.latest_latch = int(f[1])

    def send(self, line):
        self.write((line + "\n").encode())

    def drain(self):
        with self.lock:
            out, self.lines = self.lines, []
        return out

    def ask(self, line, wait=0.5):
        """One line to the bridge and the comment lines it answers within
        the wait; the L stream goes on into whatever run is playing."""
        self.send(line)
        time.sleep(wait)
        with self.lock:
            answers = [l for l in self.lines if l.startswith("#")]
            self.lines = [l for l in self.lines if not l.startswith("#")]
        return answers[-20:]


# ------------------------------------------------------------------ relays
class Relays:
    """The reset optocoupler and the power relay on the Pi's pins, or a
    printed stand-in with --no-gpio. Pins per docs/wiring.md."""

    def __init__(self, reset_pin, power_pin, real):
        self.real = real
        self.reset_pin, self.power_pin = reset_pin, power_pin
        self.power_on = None
        if real:
            from gpiozero import DigitalOutputDevice  # Raspberry Pi OS ships it
            self.reset = DigitalOutputDevice(reset_pin, initial_value=False)
            # MEASURED 2026-09-17 at the console, not read off the module:
            # GPIO27 HIGH powers the console (video 0.88 Vpp, the port's
            # latch idling at 4.3 V) and LOW turns it off. Whether that is
            # the module's input sense or its contact wired COM to NC does
            # not matter here: on() drives the pin high, and the pin rests
            # low, which is the console off.
            self.power = DigitalOutputDevice(power_pin, initial_value=False)

    def hold_reset(self):
        if self.real:
            self.reset.on()

    def release_reset(self):
        if self.real:
            self.reset.off()

    def pulse_reset(self, hold=RESET_HOLD_S):
        if self.real:
            self.reset.on()
            time.sleep(hold)
            self.reset.off()
        else:
            time.sleep(hold)
        return f"reset held {hold * 1000:.0f} ms on GPIO{self.reset_pin}" + ("" if self.real else " (no gpio)")

    def set_power(self, on):
        self.power_on = on
        if self.real:
            (self.power.on if on else self.power.off)()
        return f"power {'on' if on else 'off'} on GPIO{self.power_pin}" + ("" if self.real else " (no gpio)")


# ------------------------------------------------------------------- scope
class Scope:
    """The DS1000Z over its raw socket, the dialect of scope-capture.py."""

    PORT = 5555
    CHUNK = 250_000

    def __init__(self, host, tries=30):
        self.host = host
        # The scope may come up after the Pi: try for half a minute.
        for i in range(tries):
            try:
                self.s = socket.create_connection((host, self.PORT), timeout=5)
                break
            except OSError as e:
                if i == tries - 1:
                    raise
                time.sleep(1.0)
        # A RAW read of a 250k chunk can take a while on the instrument
        # (and the fake scope synthesises its record on demand).
        self.s.settimeout(90)
        self.idn = self.ask("*IDN?")
        self.setup = None

    def cmd(self, c):
        self.s.sendall(c.encode() + b"\n")

    def ask(self, c):
        self.cmd(c)
        out = b""
        while not out.endswith(b"\n"):
            out += self.s.recv(4096)
        return out.decode().strip()

    def ask_block(self, c):
        self.cmd(c)
        buf = b""
        while len(buf) < 11:
            buf += self.s.recv(4096)
        assert buf[0:1] == b"#", f"not a TMC block: {buf[:16]!r}"
        ndig = int(buf[1:2])
        length = int(buf[2 : 2 + ndig])
        need = 2 + ndig + length + 1
        while len(buf) < need:
            buf += self.s.recv(65536)
        return buf[2 + ndig : 2 + ndig + length]

    def save_setup(self):
        if self.setup is None:
            self.setup = self.ask_block(":SYSTem:SETup?")
        return len(self.setup)

    def restore_setup(self):
        if self.setup is not None:
            self.s.sendall(b":SYSTem:SETup " + f"#9{len(self.setup):09d}".encode() + self.setup + b"\n")
            time.sleep(2.0)
            self.cmd(":RUN")

    def arm(self, chs, scale, offset, source="EXT", tb=0.005, depth=12_000_000):
        """Single-shot on the external trigger: the next rising edge on
        EXT TRIG stops the scope with the window around it. The
        horizontal offset is set to four divisions so the trigger sits
        early in the record and two full frames follow it, which the
        recovery needs. The record's preamble says where the trigger
        actually fell, and that is what is written beside the capture
        (`trigger_sample`), so nothing downstream depends on the sign.

        MEASURED 2026-09-07 on the DS1054Z, which is what settled the
        sign this docstring used to say was untrusted. Armed exactly as
        below (one channel, 5 ms/div, 12 Mpoint) and triggered with
        :TFORce, the scope reports xorigin -0.028 s at 8 ns per sample:
        the trigger lands at sample 3,500,000 of 12,000,000, 29.2
        percent into a 96 ms record, with 68 ms after it. A positive
        MAIN:OFFSet therefore puts the trigger EARLY, which is what is
        wanted, and the four divisions leave 4.09 NES frames of record
        behind the trigger against the two the recovery needs. Do not
        flip the sign."""
        self.save_setup()
        off = [f":CHANnel{c}:DISPlay OFF" for c in (1, 2, 3, 4) if c not in chs]
        on = []
        for ch in chs:
            on += [f":CHANnel{ch}:DISPlay ON", f":CHANnel{ch}:PROBe 1", f":CHANnel{ch}:COUPling DC",
                   f":CHANnel{ch}:BWLimit OFF", f":CHANnel{ch}:SCALe {scale}", f":CHANnel{ch}:OFFSet {offset}"]
        src = "EXT" if source.upper() == "EXT" else f"CHANnel{int(source.upper().lstrip('CHANEL'))}"
        if src == "EXT":
            # MEASURED 2026-09-15: the DS1054Z has no external trigger input;
            # the source command is refused and the old source stays, so an
            # arm on EXT waits forever on whatever channel was set before.
            raise ValueError("this scope has no EXT trigger input (DS1054Z): arm on a channel, the bridge's TRIG is on CH1")
        # A logic-level trigger on a channel sits at 2.5 V; EXT TRIG's is 1.5 V.
        level = 1.5 if src == "EXT" else 2.5
        for c in [":STOP", *off, *on,
                  ":ACQuire:TYPE NORMal", f":TIMebase:MAIN:SCALe {tb}", f":TIMebase:MAIN:OFFSet {tb * 4}", ":TRIGger:MODE EDGE",
                  f":TRIGger:EDGe:SOURce {src}", ":TRIGger:EDGe:SLOPe POSitive", f":TRIGger:EDGe:LEVel {level}",
                  ":TRIGger:SWEep SINGle"]:
            self.cmd(c)
            time.sleep(0.08)
        # Memory depth only takes while running (found on the first real capture).
        self.cmd(":RUN")
        time.sleep(0.5)
        self.cmd(f":ACQuire:MDEPth {depth}")
        time.sleep(0.5)
        got = self.ask(":ACQuire:MDEPth?")
        if got.strip() != str(depth):
            raise RuntimeError(f"memory depth did not take: {got!r}")
        self.cmd(":SINGle")
        time.sleep(0.3)
        return self.ask(":TRIGger:STATus?")

    def triggered(self):
        return self.ask(":TRIGger:STATus?").strip() == "STOP"

    def read_record(self, chs, out_dir, name, note):
        """Every armed channel's record after the stop, one file each
        (`name.u8` for a single channel, `name-chN.u8` for several), and
        one `.toml` naming them all, the rate and the trigger's sample."""
        srate = float(self.ask(":ACQuire:SRATe?"))
        mdepth = int(float(self.ask(":ACQuire:MDEPth?")))
        files = {}
        ranges = {}
        trigger_sample = None
        xorig = 0.0
        for ch in chs:
            self.cmd(f":WAVeform:SOURce CHANnel{ch}")
            self.cmd(":WAVeform:MODE RAW")
            self.cmd(":WAVeform:FORMat BYTE")
            data = bytearray()
            for start in range(1, mdepth + 1, self.CHUNK):
                stop = min(start + self.CHUNK - 1, mdepth)
                self.cmd(f":WAVeform:STARt {start}")
                self.cmd(f":WAVeform:STOP {stop}")
                data += self.ask_block(":WAVeform:DATA?")
            if len(data) != mdepth:
                raise RuntimeError(f"short read on CH{ch}: {len(data)} of {mdepth}")
            # The preamble's xorigin is the first sample's time relative
            # to the trigger (negative when the trigger is inside the
            # record), xincrement the sample period: the trigger's sample
            # index follows without any offset sign convention.
            pre = self.ask(":WAVeform:PREamble?").split(",")
            xinc, xorig = float(pre[4]), float(pre[5])
            trigger_sample = int(round(-xorig / xinc))
            fname = f"{name}.u8" if len(chs) == 1 else f"{name}-ch{ch}.u8"
            (out_dir / fname).write_bytes(bytes(data))
            files[ch] = fname
            ranges[ch] = (min(data), max(data))
        lines = [f'file = "{files[chs[0]]}"', 'format = "u8"', f"rate_hz = {srate:.1f}", f"trigger_sample = {trigger_sample}"]
        lines += [f'ch{ch} = "{f}"' for ch, f in files.items()]
        lines += [f'# captured {time.strftime("%Y-%m-%d %H:%M")} from {self.idn.split(",")[1] if "," in self.idn else self.idn}',
                  f"# by nes-bench head: CH{','.join(map(str, chs))}, single-shot, xorigin {xorig:g} s; {note}"]
        (out_dir / f"{name}.toml").write_text("\n".join(lines) + "\n")
        lo = min(r[0] for r in ranges.values())
        hi = max(r[1] for r in ranges.values())
        return dict(points=mdepth, rate=srate, lo=lo, hi=hi, trigger_sample=trigger_sample, files=files)


# -------------------------------------------------------------------- runs
class Run(threading.Thread):
    """One script, played line by line on its own thread."""

    kind = "a run"

    def __init__(self, head, script):
        super().__init__(daemon=True)
        self.head = head
        self.script = script
        self.stamp = time.strftime("%Y%m%d-%H%M%S")
        self.dir = head.runs / self.stamp
        self.dir.mkdir(parents=True)
        (self.dir / "script.txt").write_text(script)
        self.log = open(self.dir / "head.log", "w")
        self.blog = open(self.dir / "bridge.log", "w")
        self.abort = False
        self.state = "starting"
        self.line_no = 0
        self.error = None
        self.armed = None  # (name, chs, note) while a capture waits for its trigger
        self.captures = []  # the names read so far
        head.bridge.drain()  # the log is this run's lines, not the idle backlog
        self.held_since = None  # when RESET began holding the console
        # Streaming (2026-10-18): the AT lines the bridge's ring has no room
        # for yet, and the ones it holds, as (latch, packed cost).
        self.pending = deque()
        self.sent = deque()
        self.last_at = 0

    def say(self, s):
        self.log.write(f"{time.time():.3f} {s}\n")
        self.log.flush()
        self.state = s

    # A bridge reply that means the run's inputs are not what the script
    # said. "# schedule full" is the one that matters: the v1b UNO holds
    # 128 AT entries against the C6's 2048, and a truncated schedule
    # replays a DIFFERENT input history while every other line looks
    # healthy. Refusing the run is the only way that failure is visible.
    REFUSALS = ("# schedule full", "# late")

    # STREAMING (2026-10-18). The UNO's schedule is a ring of 600 packed
    # entries (firmware/bridge-uno/schedule.h): an applied entry frees its
    # slot. So a script's AT lines are sent while the bridge has room, the
    # rest held here and sent as the latches go by, and a run is no longer
    # bounded by the schedule (a planned Super Mario Bros. from power-on
    # was 258 changes by World 2-2, and 2-2's swimming costs two a stroke).
    # SCHEDULE_ROOM is the packed entries the head lets the bridge hold,
    # below the UNO's 600 so a gap's fillers always fit; the cost of an AT
    # is the firmware's own (Schedule::cost). A slot counts as free once
    # the bridge has logged its latch, which is late by a loop and so on
    # the safe side. Two ways this can fail, both loud: an AT not sent by
    # its latch is refused by the head before sending ("would be late")
    # and by the bridge if it gets there ("# late AT n at latch L"). A
    # scope CAPTURE read mid-run blocks the feed for about a minute, longer
    # than SCHEDULE_ROOM of a dense schedule lasts, so a long streamed run
    # takes its captures at its end or not at all.
    SCHEDULE_ROOM = 480

    def _cost(self, n):
        return (n - self.last_at) // 255 + 1

    def _held(self):
        done = self.head.bridge.latest_latch
        while self.sent and self.sent[0][0] <= done:
            self.sent.popleft()
        return sum(c for _, c in self.sent)

    def send_at(self, n, b):
        self.send_checked(f"AT {n} {b:02x}")
        self.sent.append((n, self._cost(n)))
        self.last_at = n

    def feed(self, most=40):
        """Send held AT lines while the bridge has room; at most `most` a
        call, so a WAIT loop stays responsive."""
        if self.error:      # a failed run feeds nothing more
            return
        sent = 0
        room = self.head.schedule_room
        while self.pending and sent < most:
            n, b = self.pending[0]
            if self._held() + self._cost(n) > room:
                return
            if self.held_since is None and n <= self.head.bridge.latest_latch + 1:
                raise RuntimeError(f"AT {n} would be late (the console is at latch {self.head.bridge.latest_latch}): "
                                   "the stream fell behind, so the run is stopped")
            self.pending.popleft()
            self.send_at(n, b)
            sent += 1

    def send_checked(self, line, timeout=2.0):
        """One line to the bridge, then its echo before the next.

        Sent back to back, 125 AT lines overran the UNO's 64-byte serial
        buffer (2026-09-18, the first hand's replay): some came back as
        `# ?` and were dropped, some were taken with digits missing
        (`AT 2219 00` as `# at 2210 00`, `AT 2254 50` as `# at 225 00`),
        and the console played a different history from latch 1015 on
        with every refusal check silent. So each line waits for its own
        echo, and an AT's echo must carry the latch and byte sent."""
        w = line.split()
        op = w[0].lower()
        self.head.bridge.send(line)
        deadline = time.time() + timeout
        while time.time() < deadline:
            # Every line of the batch is logged before any is judged: the
            # loop returns at the echo, and the lines after it in the same
            # batch were dropped. Harmless while every AT was sent with the
            # console held in reset; streaming sends them while it polls,
            # and the first streamed run lost an L line beside nearly every
            # echo (2026-10-18, fake bridge at 300 Hz: 261 gaps).
            batch = self.head.bridge.drain()
            for got in batch:
                self.blog.write(got + "\n")
            for got in batch:
                if got.startswith("# ?"):
                    raise RuntimeError(f"the bridge did not understand {line!r} ({got}): the input history would be wrong, so the run is stopped")
                if any(got.startswith(r) for r in self.REFUSALS):
                    raise RuntimeError(f"the bridge refused {line!r} ({got.lstrip('# ')}): the input history would be wrong, so the run is stopped")
                g = got.split()
                if op == "at" and len(g) == 4 and g[:2] == ["#", "at"]:
                    if (int(g[2]), int(g[3], 16)) != (int(w[1]), int(w[2], 16)):
                        raise RuntimeError(f"the bridge took {line!r} as {got!r}: the input history would be wrong, so the run is stopped")
                    return
                if op != "at" and len(g) >= 2 and g[0] == "#" and g[1] == op:
                    return
            time.sleep(0.002)
        raise RuntimeError(f"the bridge did not answer {line!r} within {timeout} s")

    def pump_bridge(self):
        bad = None
        for line in self.head.bridge.drain():
            self.blog.write(line + "\n")
            if any(line.startswith(r) for r in self.REFUSALS):
                bad = bad or line
        self.blog.flush()
        if bad:
            raise RuntimeError(f"the bridge refused part of the script ({bad.lstrip('# ')}): "
                               "the input history would be wrong, so the run is stopped")
        self.feed()

    def run(self):
        try:
            for raw in self.script.splitlines():
                self.line_no += 1
                line = raw.split("#", 1)[0].strip()
                if not line:
                    continue
                if self.abort:
                    self.say("aborted")
                    return
                self.play(line)
                self.pump_bridge()
            self.release()
            if self.pending:
                raise RuntimeError(f"the script ended with {len(self.pending)} AT lines never sent: "
                                   "its last WAIT must reach past its last AT when the schedule streams")
            if self.armed:
                self.wait_capture()
            self.say("done")
        except Exception as e:  # noqa: BLE001 - the run's own record is the point
            self.error = f"line {self.line_no}: {e}"
            self.say(f"failed: {self.error}")
        finally:
            if self.held_since is not None:   # a run that failed while holding
                self.head.relays.release_reset()
                self.held_since = None
            self.pump_bridge()
            self.log.close()
            self.blog.close()
            self.head.current = None

    def release(self):
        """Let the console out of the reset RESET began holding."""
        if self.held_since is None:
            return
        left = RESET_HOLD_S - (time.time() - self.held_since)
        if left > 0:
            time.sleep(left)
        self.head.relays.release_reset()
        self.say(f"reset released after {time.time() - self.held_since:.2f} s")
        self.held_since = None

    def play(self, line):
        h = self.head
        w = line.split()
        op = w[0].upper()
        if op not in ("MODE", "SET", "AT", "TRIG", "ARM"):
            self.release()
        if op == "AT":
            n, b = int(w[1]), int(w[2], 16)
            if self.pending or self._held() + self._cost(n) > h.schedule_room:
                self.pending.append((n, b))
                if len(self.pending) == 1:
                    self.say(f"the bridge's schedule is full to the head's room: AT {n} on is streamed during the run")
            else:
                self.send_at(n, b)
                self.say(f"bridge <- {line}")
        elif op in ("MODE", "SET", "TRIG"):
            self.send_checked(line.upper() if op == "MODE" else line)
            self.say(f"bridge <- {line}")
            # A trigger whose latch has passed fires at the next one, and
            # the capture is of some other frame with nothing to say so.
            if op == "TRIG" and h.bridge.latest_latch >= int(w[1]):
                raise RuntimeError(f"TRIG {w[1]} arrived at latch {h.bridge.latest_latch}: the capture would be late, so the run is stopped")
        elif op == "RESET":
            if self.pending:
                raise RuntimeError(f"RESET with {len(self.pending)} AT lines still to stream: they belong to the session before it")
            self.sent.clear()
            self.last_at = 0
            # The console is held in reset from here through the bridge
            # lines that follow (SET, AT, TRIG) and the scope's ARM, and
            # released at the first other word, after RESET_HOLD_S at least: latch 0 is still the
            # release, and nothing loads against a running console. A
            # hand's 290-line schedule took 15 s to load with every line
            # echoed, and the replay's TRIG 1000 arrived at latch 1060
            # (2026-09-19); the capture was of the game 60 frames on.
            h.relays.hold_reset()
            self.held_since = time.time()
            self.send_checked("RESET")
            self.say(f"bridge <- RESET; reset held on GPIO{h.relays.reset_pin} while the bridge lines load")
        elif op == "POWER":
            on = w[1].upper() == "ON"
            self.say(h.relays.set_power(on))
        elif op == "WAIT":
            # WAIT n: until the bridge has reported latch n; WAIT n S: seconds.
            if len(w) == 3 and w[2].upper() == "S":
                self.say(f"wait {w[1]} s")
                t = time.time() + float(w[1])
                while time.time() < t and not self.abort:
                    time.sleep(0.05)
                    self.pump_bridge()
            else:
                n = int(w[1])
                self.say(f"wait for latch {n}")
                while h.bridge.latest_latch < n and not self.abort:
                    time.sleep(0.02)
                    self.pump_bridge()
                    if self.armed and h.scope and h.scope.triggered():
                        self.finish_capture()
        elif op == "ARM":
            # ARM name [channels] [scale] [offset] [source]: channels as
            # 3 or 1,2,4; source EXT (the bridge's trigger) or CHn.
            # Then [timebase s/div] [depth]: the DS1054Z allows 12 M
            # points with one or two channels and 6 M with more, and
            # picks the rate as depth over window; B1's frame captures
            # want 5 ms/div at 12 M (200 MSa/s over 60 ms), B2's clock
            # captures 0.5 ms/div at 1.2 M (200 MSa/s over 6 ms).
            name = w[1]
            chs = [int(c) for c in (w[2] if len(w) > 2 else "3").split(",")]
            scale = float(w[3]) if len(w) > 3 else 0.5
            offset = float(w[4]) if len(w) > 4 else -1.3
            source = w[5] if len(w) > 5 else "EXT"
            tb = float(w[6]) if len(w) > 6 else 0.005
            depth = int(w[7]) if len(w) > 7 else (12_000_000 if len(chs) <= 2 else 1_200_000)
            if h.scope is None:
                self.say(f"arm {name}: no scope (--no-scope); recorded as not captured")
                return
            status = h.scope.arm(chs, scale, offset, source, tb, depth)
            self.armed = (name, chs, f"{scale * 1000:.0f} mV/div, {offset * 1000:.0f} mV offset, trigger {source}, {tb * 1000:g} ms/div, {depth} points")
            self.say(f"armed {name} on CH{','.join(map(str, chs))} from {source}, {tb * 1000:g} ms/div, {depth} points, trigger status {status}")
        elif op == "CAPTURE":
            # CAPTURE: wait for the armed trigger, read the record. A
            # WAIT that ran past the trigger has already read it, and
            # then this is satisfied.
            if not self.armed:
                if self.captures:
                    self.say(f"capture: {self.captures[-1]} was already read during the wait")
                    return
                raise ValueError("CAPTURE with nothing armed")
            self.wait_capture()
        else:
            raise ValueError(f"unknown word {op}")

    def wait_capture(self):
        h = self.head
        t0 = time.time()
        while not h.scope.triggered() and not self.abort:
            if time.time() - t0 > 60:
                raise TimeoutError("the scope did not trigger within a minute")
            time.sleep(0.1)
            self.pump_bridge()
        self.finish_capture()

    def finish_capture(self):
        h = self.head
        name, chs, note = self.armed
        self.armed = None
        self.say(f"reading {name}")
        info = h.scope.read_record(chs, self.dir, name, note)
        self.captures.append(name)
        self.say(f"captured {name}: {info['points']} points at {info['rate']:.0f} Sa/s, range {info['lo']}..{info['hi']}, trigger at sample {info['trigger_sample']}")
        h.scope.restore_setup()


# -------------------------------------------------------------------- hand
class _Waiting:
    """The event device, read without blocking.

    `pad.events` takes None as "nothing yet, ask again", which is what
    lets a hand resting on the table still be stopped. The select
    timeout is the abort's latency and nothing else: a button press
    wakes the read at once, so it costs the console nothing.
    """

    def __init__(self, f, timeout=0.05):
        self.f, self.timeout = f, timeout

    def read(self, n):
        r, _, _ = select.select([self.f], [], [], self.timeout)
        return self.f.read(n) if r else None


class Hand(threading.Thread):
    """A gamepad on the Pi's own Bluetooth, driving the console's byte.

    The signal path is the one the 2026-09-15 milestone proved and
    nothing here changes it: every change of the eight buttons becomes
    one `SET hh`, which the bridge puts on the 595 and the 165 hands to
    the console. What is new is only where the byte comes from.

    A hand is a run, deliberately. It takes a run directory, streams
    the bridge's lines into `bridge.log` the same way, and refuses to
    start while a script is playing, because both drive the same byte.
    The reason it is worth a directory: `tools/b3.py` already turns a
    bridge log into an AT schedule, so a minute of real play comes back
    as a script the bridge replays latch for latch under the scope.
    That is the only way this bench gets rich input a hand chose.
    """

    kind = "a hand"

    def __init__(self, head, device=None, deadzone=0.5):
        super().__init__(daemon=True)
        self.head = head
        found = pad.find_pads()
        if device:
            self.device = device
            self.name = next((n for n, p in found if p == device), "named by the client")
        elif found:
            self.name, self.device = found[0]
        else:
            raise RuntimeError("no gamepad on this head: pair one with bluetoothctl, then "
                               "check it appears in /proc/bus/input/devices with a js handler")
        self.deadzone = deadzone
        self.stamp = time.strftime("%Y%m%d-%H%M%S")
        self.dir = head.runs / self.stamp
        self.dir.mkdir(parents=True)
        (self.dir / "script.txt").write_text(
            f"# played by hand on {self.name} ({self.device})\n"
            "# Not a script: the bytes arrived from a gamepad. This records how the\n"
            "# session started; tools/b3.py builds the replay out of bridge.log.\n"
            "MODE INJECT\nSET 00\n")
        self.log = open(self.dir / "head.log", "w")
        self.blog = open(self.dir / "bridge.log", "w")
        self.abort = False
        self.state = "starting"
        self.error = None
        self.line_no = 0    # changes sent so far, so `status` shows it moving
        head.bridge.drain()

    def say(self, s):
        self.log.write(f"{time.time():.3f} {s}\n")
        self.log.flush()
        self.state = s

    def pump(self):
        for line in self.head.bridge.drain():
            self.blog.write(line + "\n")
        self.blog.flush()

    def run(self):
        b = self.head.bridge
        p = None
        try:
            b.send("MODE INJECT")
            b.send("SET 00")
            self.say(f"hand on {self.name} at {self.device}")
            with open(self.device, "rb", buffering=0) as f:
                os.set_blocking(f.fileno(), False)
                p = pad.Pad(deadzone=self.deadzone, ranges=pad.abs_ranges(f.fileno()))
                if not p.ranges:
                    self.say("no analog range from this pad: the hat and the buttons only")
                for byte in pad.stream(_Waiting(f), p, rest=0, stop=lambda: self.abort):
                    b.send(f"SET {byte:02x}")
                    self.line_no += 1
                    self.pump()
            self.say("aborted" if self.abort else "the pad went away")
        except Exception as e:  # noqa: BLE001 - the session's own record is the point
            self.error = str(e)
            self.say(f"failed: {self.error}")
        finally:
            # The console must not be left holding whatever was pressed
            # when the pad disconnected, which is how a lost connection
            # becomes a character running into a pit for ten minutes.
            b.send("SET 00")
            b.send("MODE PASS")
            if p is not None and p.impossible:
                self.say(f"{p.impossible} report(s) asked for a direction pair the pad's pivot "
                         "cannot make; neither was sent")
            if p is not None and p.unknown:
                self.say("codes seen and not mapped: "
                         + ", ".join(f"0x{c:x} x{n}" for c, n in sorted(p.unknown.items())))
            self.say(f"done: {self.line_no} change(s) of byte")
            self.pump()
            self.log.close()
            self.blog.close()
            self.head.current = None


# -------------------------------------------------------------------- head
class Head:
    def __init__(self, a):
        self.schedule_room = getattr(a, "schedule_room", Run.SCHEDULE_ROOM)
        self.runs = Path(a.runs)
        self.runs.mkdir(exist_ok=True)
        self.bridge = Bridge(a.bridge, a.baud)
        self.relays = Relays(a.reset_pin, a.power_pin, real=not a.no_gpio)
        self.scope = None if a.no_scope else Scope(a.scope)
        self.current = None
        self.started = time.time()

    def handle(self, req):
        op = req.get("op")
        if op == "status":
            cur = self.current
            return dict(ok=True, up=round(time.time() - self.started, 1), bridge=self.bridge.path, latest_latch=self.bridge.latest_latch,
                        scope=self.scope.idn if self.scope else None, gpio=self.relays.real, power=self.relays.power_on,
                        run=None if cur is None else dict(stamp=cur.stamp, kind=cur.kind, state=cur.state, line=cur.line_no, error=cur.error))
        if op == "run":
            if self.current is not None:
                return dict(ok=False, error=f"{self.current.kind} is playing", stamp=self.current.stamp)
            r = Run(self, req.get("script", ""))
            self.current = r
            r.start()
            return dict(ok=True, stamp=r.stamp)
        if op == "abort":
            if self.current is None:
                return dict(ok=False, error="nothing playing")
            self.current.abort = True
            return dict(ok=True, stamp=self.current.stamp)
        if op == "pad":
            action = req.get("action", "status")
            if action == "on":
                if self.current is not None:
                    return dict(ok=False, error=f"{self.current.kind} is playing", stamp=self.current.stamp)
                try:
                    h = Hand(self, req.get("device"), float(req.get("deadzone", 0.5)))
                except Exception as e:  # noqa: BLE001 - the reason is what the client needs
                    return dict(ok=False, error=str(e))
                self.current = h
                h.start()
                return dict(ok=True, stamp=h.stamp, device=h.device, pad=h.name)
            if action == "off":
                if not isinstance(self.current, Hand):
                    return dict(ok=False, error="no hand playing")
                self.current.abort = True
                return dict(ok=True, stamp=self.current.stamp)
            return dict(ok=True, pads=[dict(name=n, device=d) for n, d in pad.find_pads()],
                        playing=isinstance(self.current, Hand))
        if op == "bridge":
            return dict(ok=True, lines=self.bridge.ask(req.get("line", "STATUS")))
        if op == "runs":
            return dict(ok=True, runs=sorted(p.name for p in self.runs.iterdir() if p.is_dir()))
        return dict(ok=False, error=f"unknown op {op!r}")


def serve_udp(head, port):
    s = socket.socket(socket.AF_INET, socket.SOCK_DGRAM)
    s.bind(("0.0.0.0", port))
    while True:
        data, addr = s.recvfrom(65535)
        try:
            req = json.loads(data.decode())
            rep = head.handle(req)
        except Exception as e:  # noqa: BLE001
            rep = dict(ok=False, error=str(e))
        out = json.dumps(rep).encode()
        if len(out) > 60_000:
            out = json.dumps(dict(ok=False, error=f"reply of {len(out)} bytes does not fit a datagram")).encode()
        s.sendto(out, addr)


class _Http(socketserver.ThreadingTCPServer):
    allow_reuse_address = True  # a restart must not wait out the old socket


def serve_http(root, port):
    handler = lambda *a, **k: http.server.SimpleHTTPRequestHandler(*a, directory=str(root), **k)  # noqa: E731
    try:
        httpd = _Http(("0.0.0.0", port), handler)
    except OSError as e:
        # Half a head is worse than none: the client would run scripts
        # it cannot fetch.
        print(f"headd: cannot serve HTTP on {port}: {e}", flush=True)
        os._exit(2)
    with httpd:
        httpd.serve_forever()


def main():
    ap = argparse.ArgumentParser()
    ap.add_argument("--bridge", required=True, help="the ESP32's serial device, or a pty from tools/fake-bridge.py")
    ap.add_argument("--baud", type=int, default=921600)
    ap.add_argument("--scope", default=None, help="the DS1000Z's address on the LAN")
    ap.add_argument("--no-scope", action="store_true")
    ap.add_argument("--no-gpio", action="store_true", help="print the relay actions instead of driving pins")
    ap.add_argument("--reset-pin", type=int, default=17)
    ap.add_argument("--power-pin", type=int, default=27)
    ap.add_argument("--port", type=int, default=6530, help="UDP for requests; HTTP for the runs on port+1")
    ap.add_argument("--runs", default="runs")
    ap.add_argument("--schedule-room", type=int, default=Run.SCHEDULE_ROOM,
                    help="packed AT entries the head lets the bridge hold before streaming the rest (the UNO holds 600)")
    a = ap.parse_args()
    if not a.no_scope and not a.scope:
        ap.error("--scope <ip> or --no-scope")
    head = Head(a)
    threading.Thread(target=serve_http, args=(head.runs, a.port + 1), daemon=True).start()
    print(f"headd: bridge {a.bridge}, scope {head.scope.idn if head.scope else 'none'}, gpio {'on' if not a.no_gpio else 'off'}; UDP {a.port}, HTTP {a.port + 1}, runs in {head.runs}", flush=True)
    serve_udp(head, a.port)


if __name__ == "__main__":
    sys.exit(main())
