tinymachines/nes-bench/tools/plan.py

#!/usr/bin/env python3
"""PLAN: a schedule for Super Mario Bros. searched on the model, then
played on the part (docs/bench-language.md, "Learning to play").

  python3 tools/plan.py rom.nes --out plan.txt [--prefix script.txt] --first N
                        [--seg 30] [--look 60] [--jobs 6] [--until N] [--backtracks 60]

The bench answers a decision in about a second and a half, ninety
polls, so it cannot react to the game; it plays a schedule. This finds
one on the model and writes it as a bench script.

The model is nes-console's `branch` example: a console kept running in
a process, saved and loaded through `Console::save_state`. The search
commits the schedule a segment at a time. For each segment of SEG
latches it loads the segment's saved state, tries every move below,
each followed by LOOK latches of running right (so a move that only
dies a moment later ranks low), and keeps the one that ends furthest on
with Mario alive; the state after the chosen move is saved as the next
segment's start. When every move at a segment dies, it backs up to the
previous segment and takes that one's next best (depth first). A
candidate costs its own latches, about 0.6 s, where a replay from
power-on cost ten (the first version of this, 2026-10-17, which
cleared 1-1 in about seventy-five minutes).

--prefix is a bench script played before the search (the start recipe
and any schedule already planned, e.g. 1-1's for planning 1-2); its
WAIT n and POWER OFF lines are ignored. --first is the latch the search
starts at.

What it reads, each measured on the model on 2026-10-17: $0770 the mode
(1 playing), $006D and $0086 the position in the area (page and x),
$0760 the area within the level (1-2's intro is 1, its underground 2),
$000E the player's state, $00B5 the vertical screen, $075A the lives.
The states, measured: 08 under control; 0B hit (Mario's first goomba,
latch 628), then off the screen (vertical screen 2 to 4), then 06, then
the life is gone; 07 the game walking him in (1-2's intro); 04 the
flagpole's slide and 05 the walk to the castle (the planned 1-1). Dead
is 0B or 06, the vertical screen past 1, or a life lost; 04 or 05 is the
level done, and so is $075C or $075F (the level, the world) changing,
which is how a castle ends ($0770 turning 2 at the axe, measured on 1-4,
is the first sign of it); anything else is the game moving him and is
waited through.

Moves stay inside their segment, because the console's schedule and the
UNO's must both be in increasing latch order: a jump's release that
would fall past the segment's end is left to the next segment's first
byte. `hold` keeps A held across the boundary, so a jump can be longer
than a segment.

Two things the first save-state run taught (1-1, 2026-10-17): running
right alone is too narrow a lookahead (near a gap every move "dies" in
it), so the lookahead is the best of three continuations; and standing
still always lives, so a branch that gains under STALL_PX in STALL
segments of one area while he is under control (state 08: the walk
into 1-2's exit pipe, state 02, holds him still and is not a stall) is
a dead end and is backed out of. Rising out of 1-2's pipe, state 07,
holds him about 96 latches, and a segment that saw any such state is
not counted.

And from 1-2 the same day: a group of enemies is passed by timing, so a
jump can start every five latches, and a latch backed out of four times
gives up the segment before it too (depth first alone spent eleven
backtracks on one latch whose cause was earlier). The UNO holds 600 entries; this refuses to write more.
"""
import argparse
import json
import os
import queue
import shutil
import subprocess
import sys
import tempfile
from concurrent.futures import ThreadPoolExecutor
from pathlib import Path

ROOT = Path(__file__).resolve().parent.parent
WATCH = ["0770", "000e", "00b5", "006d", "0086", "075a", "0760", "001d", "075c", "075f", "00ce", "074f"]
START = """POWER ON
WAIT 5 S
MODE INJECT
SET 00
RESET
WAIT 5 S
RESET
AT 200 08
AT 202 00
AT 330 08
AT 332 00
"""
DEAD = (0x0B, 0x06)
NO_CEILING = False
STALL, STALL_PX = 8, 16   # 8 segments: room to wait for a lift (3-3)
ESCALATE = 4
EXTEND = 150
DONE = (0x04, 0x05)
UNCOND = set()   # worlds whose maze checks want a y Mario never has (8-4): their loop-backs are page shifts, not deaths
CHECKS = {}      # the maze checks by world, from the ROM: a loop-back is named by the check page it fired under


def loop_checks(rom):
    """The castle mazes' checks, read out of the game's own code: when
    the screen draws page P of world W, Mario must stand at y Y or be
    sent back (4-4, 7-4, 8-4). The code compares $075F, $0725 and $00CE
    against three tables indexed by Y from the count it loads, so the
    tables are found through those compares, not at an address typed
    here. Returns {world: [(page, y), ...]} in page order."""
    prg = rom[16:16 + 0x8000]
    i = prg.find(bytes([0xA5, 0xCE, 0xD9]))          # lda $ce / cmp tbl,y
    if i < 0:
        return {}
    j = prg.rfind(bytes([0xA0]), 0, i)               # ldy #count
    n = prg[j + 1]

    def table(at):
        a = prg[at + 1] | prg[at + 2] << 8
        return prg[a - 0x8000:a - 0x8000 + n]
    worlds = table(prg.rfind(bytes([0xAD, 0x5F, 0x07, 0xD9]), 0, i) + 3)
    pages = table(prg.rfind(bytes([0xAD, 0x25, 0x07, 0xD9]), 0, i) + 3)
    ys = table(i + 2)
    out = {}
    for w, p, y in zip(worlds, pages, ys):
        out.setdefault(w, []).append((p, y))
    return {w: sorted(c) for w, c in out.items()}


def loop_target(checks, last):
    """The y the next maze check wants, or None outside a castle maze."""
    if last[8] != 3:
        return None
    for p, y in checks.get(last[9], []):
        # the screen draws page p about a page ahead of Mario: 4-4 sent
        # him back at x $0400 for its page 5 check (measured 2026-10-19)
        if last[3] + 1 < p:
            return y
    return None


def taps(seg, every, held, press):
    """A pressed every `every` latches for two, `held` between: a swim."""
    e = []
    for o in range(0, seg, every):
        e += [(o, press), (o + 2, held)] if o + 2 < seg else [(o, press)]
    return e


def moves(seg, swim=False):
    """The moves for one segment: name -> [(offset, byte)], every offset
    inside the segment. With swim, the water's moves too (2-2, measured
    2026-10-18: steady taps hold Mario near the surface, every 6 latches
    level and every 16 sinking slowly, Right moving him about 45 dots in
    30 latches at any rate, no taps sinking him to the floor). Each tap is
    two schedule entries, so the rates are the economical ones."""
    m = {"run": [(0, 0x82)], "walk": [(0, 0x80)], "stop": [(0, 0x00)], "back": [(0, 0x42)], "hold": [(0, 0x83)]}
    for at in range(0, seg, 5):
        for j in (4, 10, 18):
            e = [(0, 0x82), (at + 2, 0x83)]
            if at + 2 + j < seg:
                e.append((at + 2 + j, 0x82))
            name = f"jump{j}@{at}" if at + 2 + j < seg else f"jump@{at}"
            m.setdefault(name, e)
    # 8-4's pipes: the castle is passed through pipes, not along the
    # floor (the loop-back checks there want y $F0, which standing Mario
    # never has). Down held on a pipe's top takes him in; run first so the
    # top can be reached inside the segment
    for at in range(0, seg, 5):
        m[f"down@{at}"] = [(0, 0x82), (at, 0x20)] if at else [(0, 0x20)]
    if swim:
        m.update({
            "swim10": taps(seg, 10, 0x80, 0x81),
            "swim16": taps(seg, 16, 0x80, 0x81),
            "float10": taps(seg, 10, 0x00, 0x01),
            "swimback": taps(seg, 16, 0x40, 0x41),
            "drift": [(0, 0x80)],
        })
    return m


class Worker:
    def __init__(self, exe, rom):
        env = dict(os.environ, WATCH=",".join(WATCH))
        self.p = subprocess.Popen([str(exe), rom], stdin=subprocess.PIPE, stdout=subprocess.PIPE, text=True, env=env, bufsize=1)

    def ask(self, *lines):
        rows = {}
        for line in lines:
            self.p.stdin.write(line + "\n")
            self.p.stdin.flush()
            while True:
                r = self.p.stdout.readline()
                if not r:
                    raise RuntimeError(f"the model stopped on {line!r}")
                if r.startswith("W "):
                    f = r.split()
                    rows[int(f[1])] = [int(x, 16) for x in f[2:]]
                elif r.startswith("OK"):
                    break
                elif r.startswith("ERR"):
                    raise RuntimeError(f"{line!r}: {r.strip()}")
        return rows

    def close(self):
        self.p.stdin.write("QUIT\n")
        self.p.stdin.flush()
        self.p.wait(timeout=10)


def check_page(world, x):
    """the maze check a loop-back at raw x fired under: the first check page
    past Mario's (the check fires at a screen column, so Mario's own page
    at that moment is one of two: pages 14 and 15 under 8-4's page-16
    check, measured 2026-10-20)"""
    page = x // 256
    return min((p for p, _ in CHECKS.get(world, ()) if p > page), default=page)


def judge(rows, lives0, looped=()):
    """(alive, done, area, x, latch of death or None, held): held is the
    first state that was not 08 while the game ran, or 08 if Mario was
    his own throughout (the stall rule counts only those)."""
    x = area = 0
    held = 0x08
    prev = None
    pipe_at = None   # (x, area pointer) where a pipe was entered: a pipe that
                     # sets Mario back more than a page in the same area ($074F, the loaded area's offset: $0750 is already the destination at the entry,
                     # not the level's area number, which the water section of
                     # 8-4 shares) is a trap (8-4's wrong pipes all lead to page
                     # 1), a death; 7-2's exit pipe set him back 138 dots, which
                     # is not (measured 2026-10-20)
    xoff = 0   # 8-4's loop-backs: the game sends the page numbers back four
               # pages but the world (the block buffer, the picture) stays
               # under Mario, so he walks on in it and the pipe past the
               # check's column still takes him (measured 2026-10-20);
               # x is kept monotonic by adding the four pages back
    piped = 0   # a pipe taken counts above x: past 2-2's exit pipe Mario
                # lands at a smaller x in the same area (measured 2026-10-18)
    level0 = tuple(rows[min(rows)][8:10]) if rows else None
    for k in sorted(rows):
        mode, state, vscreen, page, px, lives, ar, _air, level, world = rows[k][:10]
        if (level, world) != level0:
            # the level or the world moved on: a castle ends with no
            # flagpole (the axe, then the next world), so this is done too.
            # Anywhere but the next level is a warp, which skips levels the
            # schedule is meant to play: a death
            lv, wd = level0
            if (level, world) != ((lv + 1, wd) if lv < 3 else (0, wd + 1)):
                return False, False, area, x, k, state
            return True, True, area, x, None, state
        # a castle's maze: on the wrong path the game sends Mario back
        # to the start of the loop, x jumping from page 4 to $FF and then
        # 0 under his own control (4-4, measured 2026-10-19). Ranked by x,
        # the beam took $FF as the furthest yet. The wrong path is a death
        if state == 0x08 and prev == 0x08 and abs(page * 256 + px + xoff - x) > 256:
            if world in UNCOND and page * 256 + px + xoff - x < -256 and check_page(world, x - xoff) not in looped:
                # once per check: the same check firing again means the
                # section's exit (a pipe before its column) was missed,
                # and the beam would circle it for ever (8-4's page 11,
                # four loops, measured 2026-10-20)
                looped = tuple(looped) + (check_page(world, x - xoff),)
                xoff += 1024
            else:
                return False, False, area, x, k, state
        prev = state if mode == 1 else None
        x, area = page * 256 + px + xoff, ar
        if mode == 2:
            # MEASURED 2026-10-18 on 1-4: the axe turns $0770 to 2 (the
            # bridge falls, Toad), and back to 1 at the next world
            return True, True, area, x, None, state
        if mode != 1:
            continue
        if state in DEAD or vscreen > 1 or lives < lives0:
            return False, False, area, x, k, state
        # --no-ceiling: standing on the top row is the way to a warp
        # zone over an underground level's ceiling; on 4-2's Mario stood
        # at y 00 with $001D 0, where its floor is b0 (measured)
        if NO_CEILING and state == 0x08 and not _air and rows[k][10] < 0x10:
            return False, False, area, x, k, state
        if state in DONE:
            return True, True, area, x, None, state
        if state != 0x08 and held == 0x08:
            held = state
        if state in (0x02, 0x03):
            piped = 0.5
            if pipe_at is None:
                pipe_at = (x, rows[k][11])
        if state == 0x08 and pipe_at is not None and rows[k][11] == pipe_at[1] and x < pipe_at[0] - 256:
            return False, False, area, x, k, state
    return True, False, area + piped, x, None, held


def main():
    ap = argparse.ArgumentParser()
    ap.add_argument("rom")
    ap.add_argument("--out", required=True)
    ap.add_argument("--prefix", help="a bench script played first (WAIT n and POWER OFF ignored)")
    ap.add_argument("--first", type=int, help="the latch the search starts at")
    ap.add_argument("--resume", help="a beam state to go on from (its .json beside it holds the latch and the schedule that reached it)")
    ap.add_argument("--no-ceiling", action="store_true", help="standing on the top row counts as a death (4-2's warp zone route)")
    ap.add_argument("--nes", default=str(ROOT.parent / "nes"))
    ap.add_argument("--seg", type=int, default=30)
    ap.add_argument("--look", type=int, default=60)
    ap.add_argument("--jobs", type=int, default=6)
    ap.add_argument("--until", type=int, default=99999)
    ap.add_argument("--backtracks", type=int, default=60)
    ap.add_argument("--swim", action="store_true", help="add the water's moves (2-2)")
    ap.add_argument("--beam-high", type=int, default=0, help="of the beam, this many slots kept for the highest positions (4-2)")
    ap.add_argument("--beam", type=int, default=0, help="keep this many distinct positions a segment instead of searching depth first (3-3)")
    a = ap.parse_args()
    if a.first is None and not a.resume:
        ap.error("--first or --resume")
    global NO_CEILING
    NO_CEILING = a.no_ceiling
    checks = loop_checks(Path(a.rom).read_bytes())
    UNCOND.update(w for w, c in checks.items() if all(y == 0xF0 for _, y in c))
    CHECKS.update(checks)
    exe = Path(a.nes) / "target" / "release" / "examples" / "branch"
    if not exe.exists():
        sys.exit(f"build it first: cargo build --release -p nes-console --example branch (in {a.nes})")

    tmp = Path(tempfile.mkdtemp(prefix="plan-"))
    prefix_lines = []
    if a.prefix:
        for line in Path(a.prefix).read_text().splitlines():
            w = line.split("#")[0].split()
            if w and not (w[0] == "WAIT" and len(w) == 2) and w[:2] != ["POWER", "OFF"]:
                prefix_lines.append(line)
    else:
        prefix_lines = START.splitlines()
    pre_ats = [(int(l.split()[1]), int(l.split()[2], 16)) for l in prefix_lines if l.startswith("AT ")]
    (tmp / "prefix.txt").write_text("\n".join(prefix_lines) + "\n")

    workers = [Worker(exe, a.rom) for _ in range(a.jobs)]
    pool = queue.Queue()
    for w in workers:
        pool.put(w)

    def on_worker(fn):
        w = pool.get()
        try:
            return fn(w)
        finally:
            pool.put(w)

    resumed, pipes0, loops0, looped0 = [], 0, 0, []
    if a.resume:
        # a beam state and the schedule that reached it (the .json beside
        # it): the search goes on from there, with no replay from power-on
        side = json.loads(Path(a.resume + ".json").read_text())
        a.first, lives0, resumed = side["t"], side["lives0"], [tuple(e) for e in side["chosen"]]
        pipes0 = side.get("pipes", 0)
        loops0 = side.get("loops", 0)
        looped0 = side.get("looped", [])
        s0 = tmp / f"s{a.first}.state"
        shutil.copy(a.resume, s0)
    else:
        s0 = tmp / f"s{a.first}.state"
        on_worker(lambda w: w.ask(f"SCRIPT {tmp / 'prefix.txt'} {a.first - 1}", f"SAVE {s0}"))
        lives0 = on_worker(lambda w: w.ask(f"LOAD {s0}", f"RUN {a.first}"))[a.first][5]
    mv = moves(a.seg, a.swim)

    # The lookahead: after a move, the best of five ways on (running, a
    # jump at once, a jump a little later, waiting then jumping, and A
    # kept held), so a move is called deadly only when none of them lives.
    def continuations(t0):
        return [[(t0, 0x82)], [(t0, 0x82), (t0 + 2, 0x83), (t0 + 26, 0x82)], [(t0, 0x82), (t0 + 20, 0x83), (t0 + 44, 0x82)],
                # wait, then go: a lift has to come before the jump to it
                # lives (3-3's mushroom lifts, 2026-10-18)
                [(t0, 0x00), (t0 + 40, 0x82), (t0 + 42, 0x83), (t0 + 66, 0x82)],
                # keep holding A: a jump begun late in a segment carried on
                # to full height. Every other way on lets go of A at the
                # boundary, so 4-2's jump from the stair top onto the last
                # tall pipe (run 12 latches, A for 30) was always judged a
                # short hop against its side (measured 2026-10-18)
                [(t0, 0x83), (t0 + 20, 0x82)]]

    def better(r):
        return (r[1], r[2], r[0], r[3] if r[0] else r[4] or 0, r[3])

    def evaluate(state, t, entries, looped=()):
        end = t + a.seg + a.look
        outs, hit = [], -1
        for cont in continuations(t + a.seg):
            cmds = [f"LOAD {state}"] + [f"AT {n} {b:02x}" for n, b in entries + cont] + [f"RUN {end}"]
            # a lookahead that ends with the game holding Mario (a pipe,
            # a cut scene) is run on until he is his own again, so what
            # lies past it counts: 1-2's exit pipe holds him about 75
            # latches, longer than LOOK (measured 2026-10-17)
            cmds += [f"RUN {end + k}" for k in range(30, EXTEND + 1, 30)]
            def run(w):
                rows = w.ask(*cmds[:-(EXTEND // 30)])
                for c in cmds[-(EXTEND // 30):]:
                    last = rows[max(rows)]
                    if last[1] in (0x08,) + DEAD or last[1] in DONE:
                        break
                    rows.update(w.ask(c))
                return rows
            rows = on_worker(run)
            # in a castle maze: the furthest x the lookahead stood at the
            # y the game's next check wants (a jump onto 4-4's upper band
            # is still in the air when its segment ends)
            want = loop_target(checks, rows[min(rows)])
            for r in rows.values():
                if want is not None and r[1] == 0x08 and r[7] == 0 and r[10] == want and r[8:10] == rows[min(rows)][8:10]:
                    hit = max(hit, r[3] * 256 + r[4])
            outs.append(judge(rows, lives0, looped) + (cont,))
        return max(outs, key=better) + (hit,)

    def ranked(state, t):
        cands = {n: [(t + o, b) for o, b in m] for n, m in mv.items()}
        with ThreadPoolExecutor(a.jobs) as ex:
            res = dict(zip(cands, ex.map(lambda e: evaluate(state, t, e), cands.values())))
        # a stall is a dead end: standing still always lives, so a branch
        # that has not gained STALL_PX in STALL segments is given up
        # (only while Mario is his own: in a pipe or a cut scene the game
        # holds him still, and that is not a stall)
        recent = path_x[-STALL:]
        if len(recent) == STALL and recent[-1][0] == recent[0][0] and recent[-1][1] - recent[0][1] < STALL_PX and all(p[2] == 0x08 for p in recent):
            return [], res
        # kept: a move one of whose continuations lives. (Before the
        # lookahead had three continuations, a move that died only in it
        # was kept too; on 1-3 that committed Mario to a gap he was
        # already falling into, 2026-10-17.)
        keep = [n for n, r in res.items() if r[0]]
        # ties go to the move with the fewest schedule entries (the UNO
        # holds 600), then to running
        keep.sort(key=lambda n: (res[n][1], res[n][2], res[n][0], res[n][3], -len(mv[n]), n == "run"), reverse=True)
        return keep, res

    if a.beam > 1:
        # BEAM (3-3, 2026-10-18). Depth first commits to one route a
        # segment at a time, and on 3-3 the low mushroom is a dead end
        # whose way out (up to the middle platform, then the tall column)
        # gains no x, so it never ranked first and was gone by the time
        # every forward move died. Here the BEAM best positions, distinct
        # by area, x and height, are all kept and all expanded.
        # pipes: how many pipes the position's own committed path went
        # through. A pipe counts above x only while it is in a lookahead
        # (judge's half area); 7-2's exit pipe keeps the area number and
        # sets Mario back 138 dots, so a position already through it
        # ranked below any position still in front of it whose lookahead
        # went in, and the beam stood at the pipe's mouth for twenty
        # segments (2026-10-19). Counted on the path, a pipe passed stays
        # passed.
        beam = [dict(state=s0, chosen=resumed, pipes=pipes0, loops=loops0, looped=looped0, st=0x08)]
        t, backs, done, chosen = a.first, 0, False, []
        while t < a.until and not done:
            jobs = [(i, n) for i in range(len(beam)) for n in mv]
            with ThreadPoolExecutor(a.jobs) as ex:
                results = list(ex.map(lambda j: evaluate(beam[j[0]]["state"], t, [(t + o, b) for o, b in mv[j[1]]], beam[j[0]]["looped"]), jobs))
            scored = [(j, r) for j, r in zip(jobs, results) if r[0]]
            if not scored:
                sys.exit(f"latch {t}: the beam of {len(beam)} has no move that lives")
            won = [(j, r) for j, r in scored if r[1]]
            if won:
                (i, n), r = max(won, key=lambda jr: -len(mv[jr[0][1]]))
                chosen = beam[i]["chosen"] + [(t + o, b) for o, b in mv[n]] + r[6]
                print(f"latch {t}: {n} (beam {i}) -> area {r[2]} x {r[3]} DONE", flush=True)
                done = True
                break
            scored.sort(key=lambda jr: (jr[1][2] + beam[jr[0][0]]["pipes"] + beam[jr[0][0]]["loops"], jr[1][3], -len(mv[jr[0][1]])), reverse=True)
            new, seen = [], set()

            def settle(c, name):
                (i, n), r = c
                entries = [(t + o, b) for o, b in mv[n]]
                nxt = tmp / f"b{t + a.seg}-{name}.state"
                rows = on_worker(lambda w: w.ask(f"LOAD {beam[i]['state']}", *[f"AT {k} {b:02x}" for k, b in entries], f"RUN {t + a.seg - 1}", f"SAVE {nxt}"))
                # entries into a pipe: Mario his own one latch, in a pipe
                # the next (the last state carried over, so an entry on a
                # segment's first latch counts too)
                prev, entered, looped, px = beam[i]["st"], 0, list(beam[i]["looped"]), None
                for k in sorted(rows):
                    entered += prev == 0x08 and rows[k][1] in (0x02, 0x03)
                    # an unconditional loop-back on the played segment (8-4): a
                    # page shift under Mario, counted as progress like a pipe,
                    # and the page it fired at kept: once per check
                    xk = rows[k][3] * 256 + rows[k][4]
                    if prev == 0x08 and rows[k][1] == 0x08 and px is not None and xk - px < -256 and rows[k][9] in UNCOND:
                        looped.append(check_page(rows[k][9], px))
                    prev, px = rows[k][1], xk
                return nxt, rows[max(rows)], beam[i]["chosen"] + entries, beam[i]["pipes"] + entered, looped

            def take(nxt, last, chosen, pipes, looped):
                loops = len(looped)
                key = (pipes, loops, last[6], (last[3] * 256 + last[4]) // 8, last[10] // 16)
                if key in seen or len(set(looped)) < loops:
                    return False
                seen.add(key)
                new.append(dict(state=nxt, chosen=chosen, pipes=pipes, loops=loops, looped=looped, st=last[1]))
                Path(str(nxt) + ".json").write_text(json.dumps(dict(t=t + a.seg, lives0=lives0, chosen=chosen, pipes=pipes, loops=loops, looped=looped)))
                return True

            for c in scored[:a.beam * 6]:
                if len(new) == a.beam - a.beam_high:
                    break
                take(*settle(c, len(new)))
            if a.beam_high:
                # the slots kept for height: the highest positions any
                # move reached standing ($001D 0), then the furthest
                # right. Ranked by x alone, 4-2's beam filled with Mario
                # pressed against a tall pipe on the ground and dropped
                # the stair tops, the only place a jump onto it starts;
                # ranked by height in the air, it kept Mario jumping at
                # the pipe's side instead (2026-10-18)
                with ThreadPoolExecutor(a.jobs) as ex:
                    rest = list(ex.map(lambda ic: settle(ic[1], f"h{ic[0]}") + (ic[1][1][7],), enumerate(scored)))
                # in a castle maze the slots go instead to the move whose
                # lookahead stood furthest on at the y the game's next
                # check wants: 4-4's beam ran the lower corridor to the
                # page 5 check and stalled, the height slot sitting on the
                # opening ledge (2026-10-19)
                def high(s):
                    if loop_target(checks, s[1]) is not None:
                        return (-s[3] - len(s[4]) - s[1][6], s[5] < 0, -s[5], -(s[1][3] * 256 + s[1][4]))
                    return (-s[3] - len(s[4]) - s[1][6], s[1][7] != 0, s[1][10], -(s[1][3] * 256 + s[1][4]))
                rest.sort(key=high)
                for nxt, last, chosen, pipes, looped, _ in rest:
                    if len(new) == a.beam:
                        break
                    take(nxt, last, chosen, pipes, looped)
                keep_files = {str(b["state"]) for b in new}
                for nxt, *_ in rest:
                    if str(nxt) not in keep_files:
                        nxt.unlink(missing_ok=True)
            (i0, n0), r0 = scored[0]
            print(f"latch {t}: beam {len(new)} kept of {len(scored)} alive; best {n0} -> area {r0[2]} x {r0[3]}, pipes {beam[i0]['pipes']}, loops {beam[i0]['loops']}", flush=True)
            beam = new
            t += a.seg
    else:
        stack = []
        chosen = []
        path_x = []   # (area, x) after each committed segment, on the current branch
        fails = {}    # latch -> backtracks out of it
        t, state, backs, done = a.first, s0, 0, False
        while t < a.until and not done:
            keep, res = ranked(state, t)
            top = ", ".join(f"{n} {r[3]}" + ("" if r[0] else f" dead@{r[4]}") for n, r in sorted(res.items(), key=lambda kv: -kv[1][3])[:5])
            while not keep:
                if not stack or backs >= a.backtracks:
                    sys.exit(f"latch {t}: no move lives and nothing left to back up to ({backs} backtracks)")
                backs += 1
                fails[t] = fails.get(t, 0) + 1
                t, state, keep, res, chosen, path_x = stack.pop()
                # four failures at one latch: the cause is further back, so
                # give up the segment before as well
                if fails.get(t + a.seg, 0) >= ESCALATE and stack:
                    fails[t + a.seg] = 0
                    t, state, keep, res, chosen, path_x = stack.pop()
                print(f"  back to latch {t} (backtrack {backs}), next {keep[0] if keep else 'nothing'}", flush=True)
            best = keep[0]
            stack.append((t, state, keep[1:], res, chosen, path_x))
            r = res[best]
            entries = [(t + o, b) for o, b in mv[best]]
            chosen = chosen + entries
            path_x = path_x + [(r[2], r[3], r[5])]
            print(f"latch {t}: {best} -> area {r[2]} x {r[3]}" + (" DONE" if r[1] else "") + ("" if r[0] else f" (dies at {r[4]} in the lookahead)") + f"   [{top}]", flush=True)
            if r[1]:
                # the flagpole was reached in the lookahead, so the way there
                # is the continuation that found it: without it the schedule
                # stops short (1-3, 2026-10-17: Mario stood at the end alive)
                chosen = chosen + r[6]
                done = True
                break
            nxt = tmp / f"s{t + a.seg}-{backs}.state"
            on_worker(lambda w: w.ask(f"LOAD {state}", *[f"AT {n} {b:02x}" for n, b in entries], f"RUN {t + a.seg - 1}", f"SAVE {nxt}"))
            state = nxt
            t += a.seg

    for w in workers:
        w.close()
    sched, held = [], None
    release = t + a.seg + a.look + (EXTEND if done else 40)
    for n, b in sorted(pre_ats + chosen + [(release, 0x00)]):
        if b != held:
            sched.append((n, b))
            held = b
    if len(sched) > 600:
        # the UNO holds 600 at once; the head streams the rest (2026-10-18)
        print(f"note: {len(sched)} entries, more than the UNO's 600: the head streams the rest during the run")
    last = max(n for n, _ in sched)
    body = START + "".join(f"AT {n} {b:02x}\n" for n, b in sched if n > 332) + f"WAIT {last + 60}\nPOWER OFF\n"
    Path(a.out).write_text(f"# planned on the model by tools/plan.py, segments of {a.seg}, lookahead {a.look}, {backs} backtracks\n" + body)
    print(f"wrote {a.out}: {len(sched)} entries, to latch {last}" + ("" if done else " (NOT done)"))


if __name__ == "__main__":
    main()
