tinymachines/nes-bench/tools/draw-schematics.py

#!/usr/bin/env python3
"""Draws the nes-bench schematics as SVG: v1 (docs/wiring.md as built),
v2 (the extended bridge), the logical/timing diagram, and the pad
adapter. Net-label schematic convention: every pin carries the name of
its net; same name, same wire. Power pins are rails. Nothing here is
built or measured; every timing number on the logical sheet is marked
authored until B0 replaces it.
"""
import sys
from pathlib import Path

PITCH = 26
STYLE = """
  <style>
    text { font-family: ui-monospace, "SF Mono", Menlo, Consolas, monospace; fill: #1f2328; }
    .title { font-size: 15px; font-weight: 700; font-family: ui-sans-serif, system-ui, sans-serif; }
    .sub { font-size: 11px; fill: #57606a; font-family: ui-sans-serif, system-ui, sans-serif; }
    .ref { font-size: 12px; font-weight: 700; }
    .part { font-size: 10px; fill: #57606a; }
    .pin { font-size: 9.5px; }
    .pinno { font-size: 9px; fill: #57606a; }
    .linkflag { fill: #fdf3e3; stroke: #a35c00; stroke-width: 1.1; }
    .linkno { font-size: 9px; fill: #a35c00; font-weight: 700; }
    .net { font-size: 9.5px; fill: #0a5b9c; font-weight: 600; }
    .rail5 { font-size: 9px; fill: #b3261e; font-weight: 700; }
    .rail3 { font-size: 9px; fill: #b35c00; font-weight: 700; }
    .gnd { font-size: 9px; fill: #1f2328; font-weight: 700; }
    .note { font-size: 10px; fill: #57606a; font-family: ui-sans-serif, system-ui, sans-serif; }
    .box { fill: #ffffff; stroke: #1f2328; stroke-width: 1.3; }
    .offsheet { fill: #eaf3fb; stroke: #0a5b9c; stroke-width: 1.1; }
    .conn { fill: #f3f5f7; stroke: #1f2328; stroke-width: 1.3; }
    .zone { fill: none; stroke: #57606a; stroke-dasharray: 5 4; stroke-width: 1; }
    .lead { stroke: #1f2328; stroke-width: 1; }
    .wire { stroke: #0a5b9c; stroke-width: 1.2; fill: none; }
    .w5 { stroke: #b3261e; stroke-width: 1.2; fill: none; }
    .w3 { stroke: #b35c00; stroke-width: 1.2; fill: none; }
    .wg { stroke: #1f2328; stroke-width: 1.2; fill: none; }
    .lane { stroke: #1f2328; stroke-width: 1.4; fill: none; }
    .lanelbl { font-size: 11px; font-weight: 700; }
    .win { fill: #b3261e; fill-opacity: 0.10; stroke: none; }
    .safe { fill: #1a7f37; fill-opacity: 0.12; stroke: none; }
    .mark { stroke: #0a5b9c; stroke-width: 1.2; stroke-dasharray: 3 3; }
    .auth { font-size: 9px; fill: #b3261e; font-family: ui-sans-serif, system-ui, sans-serif; font-style: italic; }
  </style>
"""

RAIL_CLASS = {"+5V": "rail5", "3V3": "rail3", "GND": "gnd", "VBAT": "rail3"}

# Nets that leave the drawing: a cable, a radio link, a mains lead, an
# instrument input. They have one end on the sheet on purpose, and the
# rule check reads this same set so it can tell them from a wire that
# stops in mid air. Drawn with an off-sheet flag rather than a plain
# label, so the sheet says it too.
OFFSHEET = {
    "PI_USB": "USB to the Pi", "serial": "115200 to the Pi", "LAN": "SCPI over the LAN",
    "EXT_TRIG": "scope EXT TRIG", "VIDEO": "console composite video", "radio": "BLE",
    "USB_HID": "USB to a host", "AC_LEAD_A": "AC adapter lead", "AC_LEAD_B": "AC adapter lead",
    # VBUS arrives from whatever is at the other end of the USB cable, so
    # it leaves every sheet it appears on. On pad-adapter it also has an
    # on-sheet end at the charger, so naming it here only changes how it
    # is FLAGGED there; on pad-ble, where there is no charger, it is the
    # difference between a declared inlet and a wire to nowhere.
    "VBUS": "USB power in",
    "PWR_DRIVE": "from the Pi's GPIO27", "RESET_PAD": "console reset pads",
    "RESET_GND": "console reset pads",
}



# ------------------------------------------------------------------ layout
# Authored arrangement, derived coordinates: the same split as the PCB
# placer and the breadboard sheet. A sheet says which band, column and
# row each part sits in; nothing below types an x or a y. The body is
# drawn twice, once to measure every part where it stands and once to
# draw it where the measurements say it goes, so adding a pin to a chip
# moves its neighbours instead of quietly overlapping them.
#
# The reason this exists: a sheet whose coordinates are authored has an
# authored SIZE, and a page has a fixed one. bench-v1b was 1900 by 1000
# and landed on a letter page at 63%, which puts a 9.5 px pin name at
# 4.5 pt. `plan()` derives the size from the parts and `fits()` refuses
# an arrangement that will not print.

CHARW = 6.2        # advance of the pin/net monospace at its own size
NOTE_CHARW = 5.4   # advance of the note sans at 10 px
PART_CHARW = 6.0   # advance of the part-name sans at 10 px
NOTE_LH = 13
LEAD = 26          # pin lead length: the gap a net flag hangs in
GAP = 30           # between columns of a band
BAND_GAP = 24      # between bands
PAD = 22           # band box to sheet edge
BAND_TOP = 26      # band label to the first part
HEADING_H = 60     # the sheet's own title and subtitle, above the first band


def flagw(name, links=()):
    """How far a net flag reaches out past the end of a pin lead. The
    drawing code below is what these numbers describe; if a flag is
    drawn wider than this says, parts overlap on a derived sheet."""
    if name in RAIL_CLASS:
        return max(16.0, CHARW * len(name) / 2 + 6)
    if name in links:
        return 20 + CHARW * len(name) + 6.6 * len(links[name])
    if name in OFFSHEET:
        return 10 + CHARW * len(name)
    if name in ("NC", "", None):
        return 8.0
    return CHARW * len(name) + 18


def plan(measured, target=None):
    """Coordinates for every slot, and the sheet size they imply.

    `measured` is slot -> (x0, y0, x1, y1) about that slot's anchor.
    Columns are as wide as their widest part, rows as tall as their
    tallest, and a band is as wide as its widest row. Returns
    (plan, w, h, bands) where bands maps a band index to its box."""
    keys = list(measured)
    out, bandbox = {}, {}
    y = HEADING_H + 6      # clear of the sheet's own heading
    for b in sorted({k[0] for k in keys}):
        ks = [k for k in keys if k[0] == b]
        cols, rows = sorted({k[1] for k in ks}), sorted({k[2] for k in ks})
        colw, colpad = {}, {}
        # A column is as wide as its widest overhang to the left plus
        # its longest reach to the right, measured about the anchor
        # separately: a part with left flags over a part with a long
        # caption and none used to be measured as the wider of the two
        # spans, and the caption ran off the sheet (found on the head
        # sheet, 2026-09-15). Rows the same way.
        for c in cols:
            bx = [measured[k] for k in ks if k[1] == c]
            colpad[c] = max(-v[0] for v in bx)
            colw[c] = colpad[c] + max(v[2] for v in bx)
        rowh, rowpad = {}, {}
        for r in rows:
            bx = [measured[k] for k in ks if k[2] == r]
            rowpad[r] = max(-v[1] for v in bx)
            rowh[r] = rowpad[r] + max(v[3] for v in bx)
        cx, colx = 0.0, {}
        for c in cols:
            colx[c] = cx
            cx += colw[c] + GAP
        ry, rowy = 0.0, {}
        for r in rows:
            rowy[r] = ry
            ry += rowh[r] + BAND_GAP
        bw = cx - GAP
        bh = ry - BAND_GAP
        bandbox[b] = (PAD, y, bw + 2 * BAND_TOP, bh + BAND_TOP + 16)
        for k in ks:
            out[k] = (PAD + BAND_TOP + colx[k[1]] + colpad[k[1]],
                      y + BAND_TOP + rowy[k[2]] + rowpad[k[2]])
        y += bh + BAND_TOP + 16 + BAND_GAP
    wide = max(v[2] for v in bandbox.values())
    bandbox = {b: (v[0], v[1], wide, v[3]) for b, v in bandbox.items()}
    return out, PAD + wide + PAD, y - BAND_GAP + PAD, bandbox


def fits(name, w, h, box, floor_pt=5.0, smallest_px=9.0):
    """Refuse an arrangement that will not print.

    `box` is the drawing area of the page it is going on, in the same
    96 dpi units. The sheet is placed at min(bw/w, bh/h), so the
    smallest text on it prints at that fraction of `smallest_px`, times
    0.75 pt per unit. Below about 5 pt a pin name on a printed sheet is
    a smudge, and the whole point of the package is that somebody can
    build from it at the bench."""
    scale = min(box[0] / w, box[1] / h)
    pt = smallest_px * scale * 0.75
    assert pt >= floor_pt, (
        f"{name} is {w:.0f} by {h:.0f} and would place at {scale*100:.0f}% "
        f"in a {box[0]:.0f} by {box[1]:.0f} box, printing its smallest text at "
        f"{pt:.1f} pt. The floor is {floor_pt} pt. Give the band fewer columns, "
        f"move a band onto a second sheet, or give the sheet a bigger page.")
    return scale


def laid(path, title, sub, body, box, links=None):
    """Draw `body` twice: measure, then place."""
    m = Sheet(0, 0, title, sub, measure=True, links=links)
    body(m)
    p, w, h, bands = plan(m.boxes)
    fits(Path(path).name, w, h, box)
    sh = Sheet(w, h, title, sub, plan=p, bands=bands, links=links)
    for b, (bx, by, bw, bh) in sorted(bands.items()):
        sh.zone(bx, by, bw, bh, m.bands.get(b, ""))
    body(sh)
    sh.done(path)

class Sheet:
    def __init__(self, w, h, title, sub, measure=False, plan=None, bands=None, links=None):
        self.w, self.h = w, h
        self.measuring, self.plan, self.bandbox = measure, plan, bands or {}
        self.links = links or {}
        self.boxes, self.bands, self.cur = {}, {}, None
        if measure:
            self.o = []
            return
        # The heading is its own group, and says how tall it is. A sheet
        # read on its own needs to name itself; the same sheet placed in
        # a frame does not, because the title block already does, and
        # two bold titles a hand's width apart is how a package starts
        # looking like a slide deck.
        self.o = [f'<svg xmlns="http://www.w3.org/2000/svg" viewBox="0 0 {w} {h}" width="{w}" height="{h}" role="img" aria-label="{title}">',
                  STYLE, f'<rect x="0" y="0" width="{w}" height="{h}" fill="#ffffff"/>',
                  f'<g class="sheet-heading" data-height="{HEADING_H}">',
                  f'<text class="title" x="24" y="30">{title}</text>',
                  f'<text class="sub" x="24" y="46">{sub}</text>', '</g>']

    def add(self, s):
        self.o.append(s)

    # ------------------------------------------------------ derived layout
    def slot(self, band, col, row=0, label=None):
        """Name the place the next part goes. Returns the (x, y) to draw
        it at, which is (0, 0) while measuring and the derived
        coordinate afterwards, so a part-drawing helper needs no idea
        which pass it is in."""
        self.cur = (band, col, row)
        if label:
            self.bands[band] = label
        if self.measuring:
            self.boxes.setdefault(self.cur, (0.0, 0.0, 0.0, 0.0))
            return 0, 0
        return self.plan[self.cur]

    def grow(self, x0, y0, x1, y1):
        """Record how much room the part just drawn wanted. Only the
        measuring pass keeps it."""
        if not self.measuring or self.cur is None:
            return
        b = self.boxes[self.cur]
        self.boxes[self.cur] = (min(b[0], x0), min(b[1], y0), max(b[2], x1), max(b[3], y1))

    def text(self, x, y, s, cls, anchor="start"):
        if self.measuring:
            return
        s = s.replace("&", "&amp;").replace("<", "&lt;")
        self.add(f'<text class="{cls}" x="{x}" y="{y}" text-anchor="{anchor}">{s}</text>')

    def note(self, x, y, lines):
        self.grow(x, y - 11, x + NOTE_CHARW * max(len(l) for l in lines),
                  y + NOTE_LH * (len(lines) - 1) + 5)
        if self.measuring:
            return
        for i, l in enumerate(lines):
            self.text(x, y + i * NOTE_LH, l, "note")

    def zone(self, x, y, w, h, label):
        if self.measuring:
            return
        self.add(f'<rect class="zone" x="{x}" y="{y}" width="{w}" height="{h}" rx="6"/>')
        self.text(x + 8, y + 14, label, "sub")

    def netlabel(self, x, y, name, side):
        """A net flag at the end of a pin lead. Rails get their symbol."""
        if self.measuring:
            return
        if name in self.links:
            dest = self.links[name]
            w = flagw(name, self.links)
            if side == "R":
                self.add(f'<path class="linkflag" d="M{x+w} {y} L{x+w-10} {y-9} L{x} {y-9} '
                         f'L{x} {y+9} L{x+w-10} {y+9} Z"/>')
                self.text(x + 6, y + 3.5, name, "net")
                self.text(x + w - 13, y + 3.5, dest, "linkno", "end")
            else:
                self.add(f'<path class="linkflag" d="M{x-w} {y} L{x-w+10} {y-9} L{x} {y-9} '
                         f'L{x} {y+9} L{x-w+10} {y+9} Z"/>')
                self.text(x - w + 14, y + 3.5, name, "net")
                self.text(x - 6, y + 3.5, dest, "linkno", "end")
            return
        if name in RAIL_CLASS:
            cls = RAIL_CLASS[name]
            if name == "GND":
                self.add(f'<line class="wg" x1="{x}" y1="{y}" x2="{x}" y2="{y+8}"/>'
                         f'<line class="wg" x1="{x-6}" y1="{y+8}" x2="{x+6}" y2="{y+8}"/>'
                         f'<line class="wg" x1="{x-3}" y1="{y+11}" x2="{x+3}" y2="{y+11}"/>')
            else:
                self.add(f'<line class="{"w5" if name == "+5V" else "w3"}" x1="{x}" y1="{y}" x2="{x}" y2="{y-9}"/>'
                         f'<line class="{"w5" if name == "+5V" else "w3"}" x1="{x-5}" y1="{y-9}" x2="{x+5}" y2="{y-9}"/>')
                self.text(x, y - 11, name, cls, "middle")
            return
        if name in OFFSHEET:
            w = 8 + 6.2 * len(name)
            x0 = x if side == "R" else x - w
            self.add(f'<path class="offsheet" d="M{x0} {y-8} L{x0+w-8} {y-8} L{x0+w} {y} '
                     f'L{x0+w-8} {y+8} L{x0} {y+8} Z"/>')
            self.text(x0 + 5, y + 3.5, name, "net")
            return
        if name in ("NC", ""):
            self.add(f'<line class="lead" x1="{x-3}" y1="{y-3}" x2="{x+3}" y2="{y+3}"/><line class="lead" x1="{x-3}" y1="{y+3}" x2="{x+3}" y2="{y-3}"/>')
            return
        tw = 6.2 * len(name) + 10
        if side == "L":
            self.add(f'<path class="wire" d="M{x},{y} l-6,-6 h-{tw} v12 h{tw} z"/>')
            self.text(x - 9, y + 3.5, name, "net", "end")
        else:
            self.add(f'<path class="wire" d="M{x},{y} l6,-6 h{tw} v12 h-{tw} z"/>')
            self.text(x + 9, y + 3.5, name, "net", "start")

    def chip(self, x, y, w, ref, part, left, right, conn=False, extra=None):
        """left/right: list of (pin number, pin name, net). Returns height."""
        n = max(len(left), len(right))
        h = n * PITCH + 50
        # The part number goes inside the box, so the box is at least as
        # wide as the part number. The extra line goes under it, where a
        # note on a symbol belongs, and is measured: it used to be drawn
        # inside and ran out through the right-hand wall of every
        # connector on the sheet.
        w = max(w, 14 + PART_CHARW * len(part))
        lw = max([flagw(net, self.links) for _, _, net in left], default=0)
        rw = max([flagw(net, self.links) for _, _, net in right], default=0)
        self.grow(x - (LEAD + lw if left else 0), y,
                  max(x + w + (LEAD + rw if right else 0),
                      x + (PART_CHARW * len(extra) if extra else 0)),
                  y + h + (17 if extra else 0))
        if self.measuring:
            return h
        self.add(f'<rect class="{"conn" if conn else "box"}" x="{x}" y="{y}" width="{w}" height="{h}" rx="3"/>')
        self.text(x + 6, y + 14, ref, "ref")
        self.text(x + 6, y + 26, part, "part")
        if extra:
            self.text(x + 1, y + h + 13, extra, "part")
        for i, (no, nm, net) in enumerate(left):
            py = y + 50 + i * PITCH + 6
            self.add(f'<line class="lead" x1="{x-26}" y1="{py}" x2="{x}" y2="{py}"/>')
            self.text(x + 5, py + 3.5, nm, "pin")
            if no is not None: self.text(x - 4, py - 2, str(no), "pinno", "end")
            self.netlabel(x - 26, py, net, "L")
        for i, (no, nm, net) in enumerate(right):
            py = y + 50 + i * PITCH + 6
            self.add(f'<line class="lead" x1="{x+w}" y1="{py}" x2="{x+w+26}" y2="{py}"/>')
            self.text(x + w - 5, py + 3.5, nm, "pin", "end")
            if no is not None: self.text(x + w + 4, py - 2, str(no), "pinno", "start")
            self.netlabel(x + w + 26, py, net, "R")
        return h

    def twopin(self, x, y, ref, part, net_a, net_b, horizontal=True):
        """A resistor or capacitor drawn as a labelled box between two nets."""
        self.grow(x - flagw(net_a, self.links), y - 16,
                  x + 80 + flagw(net_b, self.links), y + 16)
        if self.measuring:
            return
        if horizontal:
            self.netlabel(x, y, net_a, "L")
            self.add(f'<line class="lead" x1="{x}" y1="{y}" x2="{x+18}" y2="{y}"/>'
                     f'<rect class="box" x="{x+18}" y="{y-7}" width="44" height="14"/>'
                     f'<line class="lead" x1="{x+62}" y1="{y}" x2="{x+80}" y2="{y}"/>')
            self.text(x + 40, y - 10, ref, "pinno", "middle")
            self.text(x + 40, y + 4, part, "pin", "middle")
            self.netlabel(x + 80, y, net_b, "R")

    def bank(self, x, y, refs, part, net_a, net_b):
        """N identical parts between the same two nets, drawn once and
        labelled as a range. Every reference in `refs` is a separate
        part: the drawing is compact, the netlist is complete, and
        tools/netlist.py records all of them."""
        label = refs[0] if len(refs) == 1 else f"{refs[0]}..{refs[-1]}"
        self.grow(x - flagw(net_a, self.links), y - 16,
                  x + 80 + flagw(net_b, self.links), y + 16)
        if self.measuring:
            return len(refs)
        self.netlabel(x, y, net_a, "L")
        self.add(f'<line class="lead" x1="{x}" y1="{y}" x2="{x+18}" y2="{y}"/>'
                 f'<rect class="box" x="{x+18}" y="{y-7}" width="44" height="14"/>'
                 f'<line class="lead" x1="{x+62}" y1="{y}" x2="{x+80}" y2="{y}"/>')
        self.text(x + 40, y - 10, label, "pinno", "middle")
        self.text(x + 40, y + 4, part, "pin", "middle")
        self.netlabel(x + 80, y, net_b, "R")
        return len(refs)

    def done(self, path):
        self.add("</svg>")
        Path(path).write_text("\n".join(self.o))
        print(path)


# --------------------------------------------------------------- shared parts
def console_port(sh, x, y, ref, nets, supply="+5V", part="console controller port"):
    """The NES-001 controller port, numbered as the pin numbers moulded
    into THIS console's housing.

    MEASURED 2026-09-09, bring-up steps 1.1 and 1.2. This used to carry
    the published pinout: D3 on 5, D4 on 6, the supply on 7. On this
    console the supply is on **pin 5**, and pins 6 and 7 are not carried
    by the controller cable at all. A continuity run out of circuit
    found five conductors on pins 1 to 5, and the scope then read 5.000
    V flat on the pin 5 lead while pin 3 idled low and pin 2 idled high.
    The published table is a published table; this is the board.

    What sits on pins 6 and 7 on the console side is unknown, because
    nothing reaches them through the cable to measure with.

    `supply` is the net the console's 5 V lands on. The C6 sheets run
    their register from it. v1b passes "NC": that bridge runs from the
    UNO's own 5 V and shares only ground with the console, so the RED
    lead stays off the board (bench-v1b-uno.md, build step 3.1). The
    sheet used to draw it on +5V regardless, which put two regulators
    in parallel on the wiring list; check-sheets.py now refuses that.

    `part` names the connector the cable lands on, which is what
    export-netlist.py picks a footprint by. It defaults to the bare
    header every sheet before v1c drew; v1c's is a keyed housing."""
    used = supply != "NC"
    return sh.chip(x, y, 130, ref, part, [], [
        (1, "GND", "GND"), (2, "CLK", nets["clk"]), (3, "OUT0", nets["out0"]),
        (4, "D0", nets["d0"]), (5, "+5V", supply), (6, "n/c", "NC"), (7, "n/c", "NC")], conn=True,
        extra="MEASURED 2026-09-09: supply on 5, 6 and 7 not carried"
              + ("" if used else "; pin 5 not used here"))


def pad_socket(sh, x, y, ref, latch, clk, d0, vcc="3V3",
               part="original pad, on the bridge", extra="the pad half of the cut cable"):
    """The pad end of a cut controller cable, numbered as `console_port`
    is: the supply on pin 5, nothing carried on 6 and 7. It is the same
    cable, so it has the same conductors. `part` and `extra` default to
    what every existing sheet has always said, so only a sheet that
    names a different pad draws one."""
    return sh.chip(x, y, 130, ref, part, [
        (1, "GND", "GND"), (2, "CLK", clk), (3, "OUT0", latch), (4, "D0", d0),
        (5, "+5V", vcc), (6, "n/c", "NC"), (7, "n/c", "NC")], [], conn=True,
        extra=extra)


def hct165(sh, x, y, ref, pl, cp, qh, inputs, part="74HCT165  at +5V"):
    """inputs: nets for H..A (A button first out)."""
    left = [(1, "/PL", pl), (2, "CP", cp), (15, "/CE", "GND"), (10, "DS", "GND"), (16, "VCC", "+5V"), (8, "GND", "GND")]
    names = ["H", "G", "F", "E", "D", "C", "B", "A"]
    nos = [6, 5, 4, 3, 14, 13, 12, 11]
    right = [(9, "QH", qh), (7, "/QH", "NC")] + [(nos[i], names[i], inputs[i]) for i in range(8)]
    return sh.chip(x, y, 140, ref, part, left, right, extra="H shifts out first")


def esp32c6(sh, x, y, left, right):
    return sh.chip(x, y, 190, "U4", "ESP32-C6-DevKitC-1 v1.2", left, right, extra="RISC-V, BLE 5, Wi-Fi 6")


# ------------------------------------------------------------------- sheet v1
def sheet_v1():
    sh = Sheet(2000, 1180, "nes-bench bridge v1: the pad the console clocks, one port",
               "as wired in docs/wiring.md, 2026-09-07. Net labels: same name, same wire. Three supplies, one ground. Not yet built.")
    sh.zone(20, 60, 1040, 660, "CONSOLE SIDE, +5V logic")
    console_port(sh, 60, 90, "J1", {"clk": "CON_CLK", "out0": "CON_OUT0", "d0": "CON_D0"})
    sh.chip(400, 90, 130, "U1", "74HCT04  at +5V", [(1, "1A", "CON_OUT0"), (14, "VCC", "+5V"), (7, "GND", "GND")],
            [(2, "1Y", "/PL")], extra="5 spare inputs to GND")
    hct165(sh, 720, 90, "U2", "/PL", "CON_CLK", "CON_D0",
           ["REG_A", "REG_B", "REG_SEL", "REG_START", "REG_UP", "REG_DOWN", "REG_LEFT", "REG_RIGHT"])
    sh.note(60, 380, ["OUT0 high: U1 drives /PL low, the 165 loads its eight inputs", "(transparent while low: do not write REG_* now).",
                      "OUT0 falls: /PL high, the byte is held; QH shows H (A button).", "Each CLK rising edge shifts: G, F, E, D, C, B, A, then DS = GND.",
                      "Pressed = LOW on the input, as the pad's 4021 drives D0."])
    sh.twopin(160, 520, "C1", "100nF", "+5V", "GND")
    sh.twopin(160, 570, "C2", "100nF", "+5V", "GND")
    sh.note(300, 524, ["across U1 pins 14-7"])
    sh.note(300, 574, ["across U2 pins 16-8"])

    sh.zone(1080, 60, 900, 660, "BRIDGE SIDE, 3V3 logic")
    sh.chip(1220, 90, 150, "U3", "74LVC245  at 3V3", [
        (1, "DIR", "3V3"), (19, "/OE", "GND"), (2, "A1", "CON_OUT0"), (3, "A2", "CON_CLK"), (4, "A3..A8", "GND"),
        (20, "VCC", "3V3"), (10, "GND", "GND")],
        [(18, "B1", "LATCH_IN"), (17, "B2", "CLK_IN")], extra="5V tolerant inputs, A to B")
    sh.twopin(1220, 360, "C3", "100nF", "3V3", "GND")
    sh.note(1330, 364, ["across U3 pins 20-10"])
    esp32c6(sh, 1600, 90, [
        (None, "GPIO0", "LATCH_IN"), (None, "GPIO1", "CLK_IN"), (None, "GPIO2", "PAD_LATCH"), (None, "GPIO3", "PAD_CLK"),
        (None, "GPIO6", "PAD_D0"), (None, "GPIO7", "TRIG"), (None, "3V3", "3V3"), (None, "GND", "GND"), (None, "USB-UART", "PI_USB")],
        [(None, "GPIO18", "REG_A"), (None, "GPIO19", "REG_B"), (None, "GPIO20", "REG_SEL"), (None, "GPIO21", "REG_START"),
         (None, "GPIO22", "REG_UP"), (None, "GPIO23", "REG_DOWN"), (None, "GPIO10", "REG_LEFT"), (None, "GPIO11", "REG_RIGHT")])
    sh.note(1500, 400, ["GPIO0: PCNT unit 0, rising edges = latch index", "GPIO1: PCNT unit 1, falling edges = clocks per poll",
                        "50 ns glitch filter on both; no ISR in the path", "8, 9, 15 strapping; 12, 13 USB; 16, 17 UART: untouched"])
    sh.twopin(1500, 500, "R1", "100R", "TRIG", "EXT_TRIG")
    sh.note(1500, 530, ["to DS1054Z rear EXT TRIG, 1.5 V rising edge"])
    pad_socket(sh, 1220, 420, "J2", "PAD_LATCH", "PAD_CLK", "PAD_D0")
    sh.note(1100, 680, ["J2: the pad powered at 3V3 so its 4021 speaks 3V3; measure-first item 4"])

    sh.zone(20, 740, 1960, 420, "HEAD AND RELAYS")
    sh.chip(60, 770, 170, "PI", "Raspberry Pi 4 Model B", [], [
        (None, "USB-A", "PI_USB"), (None, "GPIO17", "RST_DRIVE"), (None, "GPIO27", "PWR_DRIVE"),
        (None, "5V", "PI_5V"), (None, "GND", "GND"), (None, "ETH", "LAN")],
        conn=True, extra="the head: headd.py")
    sh.chip(480, 770, 150, "OK1", "PC817 module", [(None, "IN+", "RST_DRIVE"), (None, "IN-", "GND")],
            [(None, "OUT", "RST_PAD"), (None, "GND", "RST_GND"), (None, "VCC", "NC")], extra="open collector across reset")
    sh.chip(880, 770, 160, "K1", "relay module, 5 V coil", [(None, "IN", "PWR_DRIVE"), (None, "GND", "GND"), (None, "VCC", "PI_5V")],
            [(None, "NO", "AC_LEAD_A"), (None, "COM", "AC_LEAD_B")], extra="opto in, active low")
    sh.chip(1300, 770, 160, "SCOPE", "Rigol DS1054Z", [(None, "EXT TRIG", "EXT_TRIG"), (None, "CH3", "VIDEO"), (None, "LAN", "LAN")], [],
            conn=True, extra="SCPI over the LAN")
    sh.chip(1700, 770, 200, "CON", "NES-001 (NES-CPU-10)", [(None, "reset pad", "RST_PAD"), (None, "reset gnd", "RST_GND"),
                                                             (None, "video", "VIDEO"), (None, "DC jack", "AC_LEAD_A"), (None, "adapter", "AC_LEAD_B")], [], conn=True)
    sh.note(60, 1000, ["Grounds: J1 pin 1, the bridge plane, U4 GND and the Pi GND (through USB) are one net. The console's +5V and the C6's 3V3 share only that net.",
                      "Reset: GPIO17 high lights the module's LED; its transistor pulls the console's pulled-up reset pad to the reset ground pad for 100 ms.",
                      "Power: GPIO27 low turns K1 on (opto input, VCC from the Pi's 5 V pin: the modules on hand are 5 V coil parts). Its normally-open",
                      "contact goes in series with one lead of the AC adapter cable, never the mains side, never both leads.",
                      "Authored pulse widths for B0 to replace: latch high a few us, clock low a few hundred ns, ~7 us between clocks, 60 polls/s."])
    sh.done(OUT / "bench-v1.svg")



# --------------------------------------------------------------- sheet v1b
# Two sheets of paper, one schematic. The netlist tools collect both
# bodies under the name bench-v1b, so the rule check still sees a whole
# design; what is split is the paper. Nets that continue on the other
# sheet carry a link flag with the sheet number in it, which is what the
# flag is for: a reader who wants the other end of Q_START is told where
# it is instead of being left to search.
LETTER = None   # set at import: the drawing area of a landscape letter page

V1B_TITLE = "nes-bench bridge v1b: the UNO version, one supply, one port"
V1B_SUB = ("the ATmega328 is a 5 V part, so the register, the pad and the console share one domain. "
           "2026-09-08. Not built; pulse widths authored until B0.")
Q_NETS = ["Q_A", "Q_B", "Q_SEL", "Q_START", "Q_UP", "Q_DOWN", "Q_LEFT", "Q_RIGHT"]


def _v1b_body_1(sh):
    band = "THE CONSOLE PORT, THE INVERTER AND THE REGISTER, ALL AT +5V"
    console_port(sh, *sh.slot(0, 0, label=band), "J1",
                 {"clk": "CON_CLK", "out0": "CON_OUT0", "d0": "CON_D0"}, supply="NC")
    x, y = sh.slot(0, 1)
    # The five spare inputs are on the sheet as pins, not as a note:
    # a CMOS input left floating oscillates, and a wiring list derived
    # from a note does not tell a builder to tie anything.
    sh.chip(x, y, 130, "U1", "74HCT04  at +5V",
            [(1, "1A", "CON_OUT0"), (3, "2A", "GND"), (5, "3A", "GND"), (9, "4A", "GND"),
             (11, "5A", "GND"), (13, "6A", "GND"), (14, "VCC", "+5V"), (7, "GND", "GND")],
            [(2, "1Y", "/PL"), (4, "2Y", "NC"), (6, "3Y", "NC"), (8, "4Y", "NC"), (10, "5Y", "NC"),
             (12, "6Y", "NC")], extra="2.0 V threshold: safe on NMOS OUT0")
    hct165(sh, *sh.slot(0, 2), "U2", "/PL", "CP", "CON_D0",
           part="74HC165  at +5V (the TI bag)", inputs=Q_NETS)
    band2 = "DECOUPLING, AND WHAT THE CONSOLE ACTUALLY DOES"
    sh.bank(*sh.slot(1, 0, label=band2), ["C1", "C2", "C3"], "100nF", "+5V", "GND")
    sh.note(*sh.slot(1, 1), ["one 100nF across each of U1, U2 and U3,", "at the chip's own supply pins"])
    sh.note(*sh.slot(1, 2), [
        "OUT0 high: U1 drives /PL low and the 165 loads its eight inputs. It is transparent while low,",
        "so the byte must already be in U3 (sheet 2). OUT0 falls, /PL goes high, the byte is held, and",
        "QH shows A. Each CLK rising edge shifts the next bit out: B, Select, Start, Up, Down, Left,",
        "Right, then DS = GND, so the ninth read and later return 1 as an original pad does.",
        "Pressed is LOW, which is what the pad's own 4021 drives."])
    band3 = "THE CLOCK PIN, FILTERED (added 2026-09-15)"
    sh.twopin(*sh.slot(2, 0, label=band3), "R2", "1k", "CON_CLK", "CP")
    sh.twopin(*sh.slot(2, 1), "C4", "100pF", "CP", "GND")
    sh.note(*sh.slot(2, 2), [
        "MEASURED 2026-09-15: a lone pressed bit from B to Left showed on D0 for 50 ns and the",
        "register read as if shifted once too often; D0's own falling edge was re-clocking the 165.",
        "R2 and C4 (100 ns) sit at pin 2 against a spike that short; the console's clock is",
        "microseconds wide and passes. The UNO's D2 still counts CON_CLK ahead of R2."])


def _v1b_body_2(sh):
    band = "THE UNO, THE OUTPUT REGISTER AND THE BRIDGE'S OWN PAD, ALL AT +5V"
    pad_socket(sh, *sh.slot(0, 0, label=band), "J2", "PAD_LATCH", "PAD_CLK", "PAD_D0", vcc="+5V")
    x, y = sh.slot(0, 1)
    sh.chip(x, y, 190, "A1", "Arduino UNO R3 (ATmega328P)", [
        (None, "D13 SCK", "SCK"), (None, "D11 MOSI", "MOSI"), (None, "D10", "RCLK"),
        (None, "D5 (T1)", "CON_OUT0"), (None, "D2 (INT0)", "CON_CLK"), (None, "D3", "TRIG"),
        (None, "5V", "+5V"), (None, "GND", "GND"), (None, "USB-B", "PI_USB")],
        [(None, "D6", "PAD_LATCH"), (None, "D7", "PAD_CLK"), (None, "D8", "PAD_D0"),
         (None, "D0, D1", "serial")], extra="5 V logic, 16 MHz")
    x, y = sh.slot(0, 2)
    sh.chip(x, y, 140, "U3", "74HC595  at +5V", [
        (14, "SER", "MOSI"), (11, "SRCLK", "SCK"), (12, "RCLK", "RCLK"), (13, "/OE", "GND"),
        (10, "/SRCLR", "+5V"), (16, "VCC", "+5V"), (8, "GND", "GND")],
        [(15, "QA", "Q_A"), (1, "QB", "Q_B"), (2, "QC", "Q_SEL"), (3, "QD", "Q_START"),
         (4, "QE", "Q_UP"), (5, "QF", "Q_DOWN"), (6, "QG", "Q_LEFT"), (7, "QH", "Q_RIGHT"),
         (9, "QH'", "NC")], extra="one RCLK edge = one byte")
    band2 = "THE TRIGGER, AND WHY THESE PINS"
    sh.twopin(*sh.slot(1, 0, label=band2), "R1", "100R", "TRIG", "EXT_TRIG")
    sh.note(*sh.slot(1, 1), ["to the DS1054Z's CH1 (MEASURED 2026-09-15: this",
                             "scope has no external trigger input; its rear BNC",
                             "is Trig Out). Trigger on CH1, 2.5 V rising."])
    sh.note(*sh.slot(1, 2), [
        "D5 is Timer1's external clock input (T1): a 16-bit hardware counter of",
        "OUT0 rising edges, which is the latch index. D2 (INT0) takes a falling-edge",
        "ISR counting clocks per poll, 480/s, nothing for a 16 MHz part. D3 rises at",
        "latch T, one loop late (~100 us); a 74LS74 makes it edge-exact later.",
        "SPI clocks 8 bits into U3 in 2 us at 4 MHz and one RCLK edge moves them to",
        "its outputs in ~10 ns, so the console never sees half a byte. The firmware",
        "still only pulses RCLK while D5 reads low. Serial 115200 to the Pi over USB."])
    band3 = "THE HEAD, THE RELAYS AND THE SCOPE (unchanged from v1 except the relay supply)"
    sh.note(*sh.slot(2, 0, label=band3), [
        "Pi GPIO17 to a PC817 or one TLP281 channel, to the console's reset pads, 100 ms.",
        "Pi GPIO27 to the relay module's IN (active low); relay VCC from the Pi's 5 V pin,",
        "because the Songle SRD-05VDC and the Tongling board are 5 V coil parts."])
    sh.note(*sh.slot(2, 1), [
        "One normally-open contact in series with one lead of the AC adapter cable, never",
        "the mains side and never both. Grounds: J1 pin 1, the bridge, the UNO GND and the",
        "Pi GND through USB are one net. Scope: video on CH3, the trigger from R1 on CH1, SCPI by LAN."])


def _v1b_body_3(sh):
    """The head's hands: bring-up 6.2 and 6.3. Nothing on this sheet
    touches the breadboard: the Pi's four jumpers go to two modules,
    and the modules go to the console. The Pi's pin numbers are its
    header positions, the same ones the cheat sheet's jumper table
    carries, and check-sheets holds the two together."""
    band = "THE PI'S FOUR JUMPERS, THE OPTOCOUPLER ACROSS THE RESET BUTTON, THE RELAY ACROSS THE POWER SWITCH"
    x, y = sh.slot(0, 0, label=band)
    sh.chip(x, y, 170, "PI", "Raspberry Pi 4 Model B", [], [
        (11, "GPIO17", "RST_DRIVE"), (13, "GPIO27", "PWR_DRIVE"), (2, "5V", "PI_5V"), (6, "GND", "GND"),
        (None, "USB-A", "PI_USB"), (None, "ETH", "LAN")],
        conn=True, extra="the head: headd.py. Pin numbers are header positions")
    x, y = sh.slot(0, 1, 0)
    sh.chip(x, y, 150, "OK1", "PC817 module", [(None, "INPUT +", "RST_DRIVE"), (None, "INPUT -", "GND")],
            [(None, "OUT", "RST_HI"), (None, "GND", "RST_LO"), (None, "VCC", "NC")],
            extra="open collector across the reset button")
    x, y = sh.slot(0, 1, 1)
    sh.chip(x, y, 150, "K1", "relay module, 5 V coil", [(None, "IN", "PWR_DRIVE"), (None, "GND", "GND"), (None, "VCC", "PI_5V")],
            [(None, "COM", "PWR_BROWN"), (None, "NO", "PWR_RED"), (None, "NC", "NC")], extra="MEASURED: GPIO27 high powers the console")
    x, y = sh.slot(0, 2, 0)
    sh.chip(x, y, 210, "J3", "front panel harness (breakout)", [
        (1, "1 brown, power", "PWR_BROWN"), (2, "2 red, power", "PWR_RED"),
        (3, "3 orange, reset +", "RST_HI"), (4, "4 yellow, reset -", "RST_LO"),
        (5, "5 white, LED", "NC")], [],
        conn=True, extra="in parallel with the front panel's own wiring")
    band2 = "WHAT THE HARNESS IS, MEASURED 2026-09-17, AND WHAT IS STILL TO METER"
    sh.note(*sh.slot(1, 0, label=band2), [
        "J3 is five ways straight through, colour for colour with the front panel's harness, pin 1 at",
        "the back (lab/06-breakout-map-power-reset.jpg), tapped in parallel with the front panel.",
        "Metered unpowered by the user: 1 brown and 2 red are the power switch; 3 orange and 4 yellow",
        "the reset button; 4 yellow and 5 white the LED. No pin is ground: the front panel is grounded",
        "by its pad and the metal housing. OK1's output is a transistor and has a polarity. MEASURED",
        "2026-09-17, console on and the button released: orange sits 4.40 V above yellow, so OUT goes",
        "on orange and GND on yellow. Held, the button reads about 200 ohms between them, which a",
        "saturated transistor beats. GPIO17 high closes OK1: the reset button, pressed by the head."])
    sh.note(*sh.slot(1, 1), [
        "K1's contact is in parallel with the front panel's power switch: COM on brown, NO on red",
        "(a contact has no polarity). Either closes the console's supply, so the front switch stays",
        "OFF while the head runs the power, and does the power by hand while the relay rests open.",
        "MEASURED 2026-09-17 at the console, not read off the module: GPIO27 HIGH powers it (video",
        "0.88 Vpp, the port's latch idling at 4.3 V) and LOW turns it off, so the boot config holds",
        "GPIO27 LOW and the console rests off. Coil from the Pi's 5 V pin (position 2); GND is 6.",
        "The pair carries the adapter's low voltage and the console's current, well inside the",
        "contact's 10 A. MAINS SAFETY: nothing on this sheet is ever on the mains side."])

def sheet_v1b():
    """One schematic on two landscape letter sheets, and a third for
    the head's hands, which share no net with the first two."""
    cross = {"CON_OUT0": "2", "CON_CLK": "2"}
    laid(OUT / "bench-v1b-1.svg", V1B_TITLE + "  (sheet 1 of 3: the console side)", V1B_SUB,
         _v1b_body_1, LETTER, links={**cross, **{q: "2" for q in Q_NETS}})
    back = {"CON_OUT0": "1", "CON_CLK": "1"}
    laid(OUT / "bench-v1b-2.svg", V1B_TITLE + "  (sheet 2 of 3: the bridge side)", V1B_SUB,
         _v1b_body_2, LETTER, links={**back, **{q: "1" for q in Q_NETS}})


def sheet_v1b_head():
    """Sheet 3: its own netlist, because nothing on it is on the
    breadboard and the wiring and breadboard drawings lay out every
    part of the netlist they are handed."""
    laid(OUT / "bench-v1b-3.svg", V1B_TITLE + "  (sheet 3 of 3: the head's hands, bring-up 6.2 and 6.3)",
         "reset and power from the Pi's header through two modules; the Pi's ground reaches the console through the UNO's USB lead only. Added 2026-09-15.",
         _v1b_body_3, LETTER)



# ------------------------------------------------------------------ sheet v1c
# v1c is v1b made into a printed board: the same bridge, net for net, as
# an UNO shield, with the head's two hands on it as bare parts and every
# cable on a keyed housing. Nothing in the bridge's circuit changes; what
# changes is that nothing can be one row off. check-sheets.py holds every
# node v1b draws to the same net here, so the two cannot drift.
V1C_TITLE = "nes-bench bridge v1c: v1b as a printed shield, the hands on board"
V1C_SUB = ("the circuit that passed bench-check on 2026-10-17, net for net, on an UNO shield; keyed cables, "
           "the reset opto and the power relay as bare parts. 2026-10-17. Not built.")
KEYED = "keyed KK-254"


def _v1c_body_1(sh):
    band = "THE CONSOLE PORT, THE INVERTER AND THE REGISTER, ALL AT +5V (AS v1b)"
    console_port(sh, *sh.slot(0, 0, label=band), "J1",
                 {"clk": "CON_CLK", "out0": "CON_OUT0", "d0": "CON_D0"}, supply="NC",
                 part=f"console controller port, {KEYED}")
    x, y = sh.slot(0, 1)
    sh.chip(x, y, 130, "U1", "74HCT04  at +5V",
            [(1, "1A", "CON_OUT0"), (3, "2A", "GND"), (5, "3A", "GND"), (9, "4A", "GND"),
             (11, "5A", "GND"), (13, "6A", "GND"), (14, "VCC", "+5V"), (7, "GND", "GND")],
            [(2, "1Y", "/PL"), (4, "2Y", "NC"), (6, "3Y", "NC"), (8, "4Y", "NC"), (10, "5Y", "NC"),
             (12, "6Y", "NC")], extra="five spare inputs tied to GND")
    hct165(sh, *sh.slot(0, 2), "U2", "/PL", "CP", "CON_D0",
           part="74HC165  at +5V", inputs=Q_NETS)
    band2 = "DECOUPLING"
    sh.bank(*sh.slot(1, 0, label=band2), ["C1", "C2", "C3"], "100nF", "+5V", "GND")
    sh.note(*sh.slot(1, 1), ["one 100nF across each of U1, U2 and U3,", "at the chip's own supply pins"])
    band3 = "THE CLOCK PIN'S FILTER, ON THE BOARD"
    sh.twopin(*sh.slot(2, 0, label=band3), "R2", "1k", "CON_CLK", "CP")
    sh.twopin(*sh.slot(2, 1), "C4", "100pF", "CP", "GND")
    sh.note(*sh.slot(2, 2), [
        "v1b's filter (MEASURED 2026-09-15: D0's own edge re-clocked the 165). The UNO's",
        "D2 still counts CON_CLK ahead of R2, exactly as on the breadboard. On 2026-10-16",
        "R2 sat one breadboard row off the clock lead, the walk read bit 0 in all eight",
        "slots, and only a probe on U2 pin 2 could have shown it: TP4 (sheet 3) is that probe."])


def _v1c_body_2(sh):
    band = "THE UNO AS A SHIELD, THE OUTPUT REGISTER AND THE BRIDGE'S OWN PAD (AS v1b)"
    pad_socket(sh, *sh.slot(0, 0, label=band), "J2", "PAD_LATCH", "PAD_CLK", "PAD_D0", vcc="+5V",
               part=f"original pad, {KEYED}")
    x, y = sh.slot(0, 1)
    sh.chip(x, y, 190, "A1", "Arduino UNO R3, as a shield", [
        (None, "D13 SCK", "SCK"), (None, "D11 MOSI", "MOSI"), (None, "D10", "RCLK"),
        (None, "D5 (T1)", "CON_OUT0"), (None, "D2 (INT0)", "CON_CLK"), (None, "D3", "TRIG"),
        (None, "5V", "+5V"), (None, "GND", "GND"), (None, "USB-B", "PI_USB")],
        [(None, "D6", "PAD_LATCH"), (None, "D7", "PAD_CLK"), (None, "D8", "PAD_D0"),
         (None, "D0, D1", "serial")], extra="the shield plugs into its headers")
    x, y = sh.slot(0, 2)
    sh.chip(x, y, 140, "U3", "74HC595  at +5V", [
        (14, "SER", "MOSI"), (11, "SRCLK", "SCK"), (12, "RCLK", "RCLK"), (13, "/OE", "GND"),
        (10, "/SRCLR", "+5V"), (16, "VCC", "+5V"), (8, "GND", "GND")],
        [(15, "QA", "Q_A"), (1, "QB", "Q_B"), (2, "QC", "Q_SEL"), (3, "QD", "Q_START"),
         (4, "QE", "Q_UP"), (5, "QF", "Q_DOWN"), (6, "QG", "Q_LEFT"), (7, "QH", "Q_RIGHT"),
         (9, "QH'", "NC")], extra="one RCLK edge = one byte")
    band2 = "THE TRIGGER, AND WHY THESE PINS"
    sh.twopin(*sh.slot(1, 0, label=band2), "R1", "100R", "TRIG", "EXT_TRIG")
    sh.note(*sh.slot(1, 1), [
        "The pins are v1b's (bench-v1b-uno.md, UNO pins): D5 is Timer1's T1,",
        "D2 is INT0, D3 the trigger, D10 RCLK, D11 and D13 the SPI to U3, D6 to",
        "D8 the bridge's own pad. The serial to the Pi stays on the UNO's USB;",
        "the shield touches no D0 or D1. R1's far end goes to TP1 (sheet 3)."])


def _v1c_probes(sh):
    band = "A TEST POINT FOR EVERY SCOPE PROBE"
    tp = [("TP1", "5000 (red)", "TRIG", "EXT_TRIG", "after R1: CH1"),
          ("TP2", "5000 (red)", "OUT0", "CON_OUT0", "the latch: CH2"),
          ("TP3", "5000 (red)", "D0", "CON_D0", "U2 pin 9: CH4"),
          ("TP4", "5000 (red)", "CP", "CP", "U2 pin 2, after R2"),
          ("TP5", "5001 (black)", "GND", "GND", "probe ground"),
          ("TP6", "5001 (black)", "GND", "GND", "probe ground")]
    for k, (ref, kind, pin, net, what) in enumerate(tp):
        sh.chip(*sh.slot(0, k % 3, k // 3, label=band if k == 0 else None), 150, ref,
                f"test point, Keystone {kind}", [(1, pin, net)], [], conn=True, extra=what)
    band2 = "WHERE EACH PROBE SITS TODAY, AND THE ONE THAT WAS MISSING"
    sh.note(*sh.slot(1, 0, label=band2), [
        "TP1 is where the red lead to CH1 lands on the breadboard (R1's far end), and TP2 and TP3",
        "where CH2 and CH4 sit (U1 pin 1 and U2 pin 9, cheat-sheet.md). TP4 is new: the clock as",
        "the 165 sees it, after the filter. A Keystone 5000 takes a probe's hook; the two blacks",
        "are the probes' grounds, on the console's ground like the breadboard's GND rail."])


def _v1c_body_3(sh):
    """The head's reset hand, as a bare part on the shield. The hands
    keep their own ground: PI_GND is the Pi's, and nothing on the board
    joins it to GND, so the Pi still reaches the console's ground only
    through the UNO's USB lead, as on v1b's sheet 3."""
    band = "THE PI'S CABLE, THE FRONT PANEL'S, AND THE OPTOCOUPLER ACROSS THE RESET BUTTON"
    x, y = sh.slot(0, 0, label=band)
    sh.chip(x, y, 190, "J4", f"Pi header cable, {KEYED}", [], [
        (1, "GND (Pi position 6)", "PI_GND"), (2, "5V (Pi position 2)", "PI_5V"),
        (3, "GPIO17 (Pi position 11)", "RST_DRIVE"), (4, "GPIO27 (Pi position 13)", "PWR_DRIVE")],
        conn=True, extra="Dupont at the Pi, KK here")
    sh.twopin(*sh.slot(0, 1, 0), "R3", "470R", "RST_DRIVE", "OK1_A")
    x, y = sh.slot(0, 1, 1)
    sh.chip(x, y, 150, "OK1", "PC817 (DIP-4)", [(1, "A", "OK1_A"), (2, "K", "PI_GND")],
            [(4, "C", "RST_HI"), (3, "E", "RST_LO")], extra="open collector, no pull-up")
    x, y = sh.slot(0, 2)
    sh.chip(x, y, 190, "J3", f"front panel harness, {KEYED}", [
        (1, "1 brown, power", "PWR_BROWN"), (2, "2 red, power", "PWR_RED"),
        (3, "3 orange, reset +", "RST_HI"), (4, "4 yellow, reset -", "RST_LO"),
        (5, "5 white, LED", "NC")], [],
        conn=True, extra="in parallel with the front panel")
    band2 = "WHAT OK1 IS SIZED FOR, AND WHAT THE BOARD DOES NOT JOIN"
    sh.note(*sh.slot(1, 0, label=band2), [
        "GPIO17 at 3.3 V through R3 lights OK1's LED at about 4.5 mA ((3.3 - 1.2) / 470).",
        "Its transistor sits across the reset button with no pull-up of its own, as v1b's",
        "module did with VCC open: C on orange (4.40 V above yellow, MEASURED 2026-09-17),",
        "E on yellow. GPIO17 high closes it: the reset button, pressed by the head."])
    sh.note(*sh.slot(1, 1), [
        "PI_GND is the Pi's ground and is joined to GND nowhere on this board: the Pi",
        "reaches the console's ground through the UNO's USB lead only, as on v1b. The",
        "opto's two sides share nothing but light. PWR_DRIVE and PI_5V go to sheet 5."])


def _v1c_body_4(sh):
    """The power hand: a bare relay where v1b had a module."""
    band = "THE RELAY ACROSS THE POWER SWITCH, AND ITS DRIVER"
    sh.twopin(*sh.slot(0, 0, 0, label=band), "R4", "470R", "PWR_DRIVE", "Q1_B")
    sh.twopin(*sh.slot(0, 0, 1), "R5", "10k", "Q1_B", "PI_GND")
    x, y = sh.slot(0, 1)
    sh.chip(x, y, 130, "Q1", "2N3904 (TO-92)", [(2, "B", "Q1_B"), (1, "E", "PI_GND")],
            [(3, "C", "COIL_LO")], extra="the coil's low side")
    sh.twopin(*sh.slot(0, 2, 0), "D1", "1N4007", "PI_5V", "COIL_LO")
    x, y = sh.slot(0, 2, 1)
    sh.chip(x, y, 150, "K1", "SRD-05VDC-SL-C (form C)", [(2, "coil", "PI_5V"), (5, "coil", "COIL_LO")],
            [(1, "COM", "PWR_BROWN"), (3, "NO", "PWR_RED"), (4, "NC", "NC")],
            extra="GPIO27 high: COM to NO")
    band2 = "WHAT EACH PART IS SIZED FOR"
    sh.note(*sh.slot(1, 0, label=band2), [
        "K1 is the 5 V coil part the module carried (SRD-05VDC, about 70 ohms, 71 mA), on the",
        "Pi's 5 V pin as before. Q1 switches its low side; R4 gives it about 5.5 mA of base, R5",
        "holds it off while the Pi boots and GPIO27 floats, and D1 (cathode on PI_5V) takes the",
        "coil's kick. GPIO27 high closes COM to NO: the module's measured sense, kept."])
    sh.note(*sh.slot(1, 1), [
        "K1's contact is in parallel with the front panel's power switch: COM on brown, NO on",
        "red (sheet 4). The adapter's low voltage and the console's current, never mains; the",
        "front switch stays OFF while the head runs the power. K1 shares nothing with its coil.",
        "MAINS SAFETY: nothing on this sheet is ever on the mains side."])


def sheet_v1c():
    """One schematic, one board, on five landscape letter sheets."""
    laid(OUT / "bench-v1c-1.svg", V1C_TITLE + "  (sheet 1 of 5: the console side)", V1C_SUB,
         _v1c_body_1, LETTER, links={"CON_OUT0": "2,3", "CON_CLK": "2", "CON_D0": "3", "CP": "3", **{q: "2" for q in Q_NETS}})
    laid(OUT / "bench-v1c-2.svg", V1C_TITLE + "  (sheet 2 of 5: the bridge side)", V1C_SUB,
         _v1c_body_2, LETTER, links={"CON_OUT0": "1,3", "CON_CLK": "1", "EXT_TRIG": "3", **{q: "1" for q in Q_NETS}})
    laid(OUT / "bench-v1c-3.svg", V1C_TITLE + "  (sheet 3 of 5: the probes)", V1C_SUB,
         _v1c_probes, LETTER, links={"EXT_TRIG": "2", "CON_OUT0": "1,2", "CON_D0": "1", "CP": "1"})
    laid(OUT / "bench-v1c-4.svg", V1C_TITLE + "  (sheet 4 of 5: the reset hand and the cables)", V1C_SUB,
         _v1c_body_3, LETTER, links={"PWR_DRIVE": "5", "PI_5V": "5", "PI_GND": "5", "PWR_BROWN": "5", "PWR_RED": "5"})
    laid(OUT / "bench-v1c-5.svg", V1C_TITLE + "  (sheet 5 of 5: the power hand)", V1C_SUB,
         _v1c_body_4, LETTER, links={"PWR_DRIVE": "4", "PI_5V": "4", "PI_GND": "4", "PWR_BROWN": "4", "PWR_RED": "4"})

# ------------------------------------------------------------------- sheet v2
def sheet_v2():
    sh = Sheet(2400, 1290, "nes-bench bridge v2: two ports, atomic bytes, the frame counted in hardware",
               "extends v1 with 74HC595s on SPI (one RCLK edge updates both registers), an LM1881 sync separator, and a second pad. Nothing built; every number authored until B0.")
    sh.zone(20, 60, 1440, 780, "CONSOLE SIDE, +5V logic")
    console_port(sh, 60, 90, "J1", {"clk": "CON1_CLK", "out0": "CON1_OUT0", "d0": "CON1_D0"})
    console_port(sh, 60, 360, "J3", {"clk": "CON2_CLK", "out0": "CON2_OUT0", "d0": "CON2_D0"})
    sh.chip(400, 90, 130, "U1", "74HCT04  at +5V", [(1, "1A", "CON1_OUT0"), (3, "2A", "CON2_OUT0"), (14, "VCC", "+5V"), (7, "GND", "GND")],
            [(2, "1Y", "/PL1"), (4, "2Y", "/PL2")], extra="4 spare inputs to GND")
    hct165(sh, 720, 90, "U2", "/PL1", "CON1_CLK", "CON1_D0", ["Q1A", "Q1B", "Q1SEL", "Q1START", "Q1UP", "Q1DOWN", "Q1LEFT", "Q1RIGHT"])
    hct165(sh, 720, 440, "U6", "/PL2", "CON2_CLK", "CON2_D0", ["Q2A", "Q2B", "Q2SEL", "Q2START", "Q2UP", "Q2DOWN", "Q2LEFT", "Q2RIGHT"])
    sh.chip(1140, 90, 140, "U5", "74HC595  at 3V3", [
        (14, "SER", "MOSI"), (11, "SRCLK", "SCK"), (12, "RCLK", "RCLK"), (13, "/OE", "GND"), (10, "/SRCLR", "3V3"), (16, "VCC", "3V3"), (8, "GND", "GND")],
        [(15, "QA", "Q1A"), (1, "QB", "Q1B"), (2, "QC", "Q1SEL"), (3, "QD", "Q1START"), (4, "QE", "Q1UP"), (5, "QF", "Q1DOWN"),
         (6, "QG", "Q1LEFT"), (7, "QH", "Q1RIGHT"), (9, "QH'", "CHAIN")], extra="port 1 byte")
    sh.chip(1140, 440, 140, "U7", "74HC595  at 3V3", [
        (14, "SER", "CHAIN"), (11, "SRCLK", "SCK"), (12, "RCLK", "RCLK"), (13, "/OE", "GND"), (10, "/SRCLR", "3V3"), (16, "VCC", "3V3"), (8, "GND", "GND")],
        [(15, "QA", "Q2A"), (1, "QB", "Q2B"), (2, "QC", "Q2SEL"), (3, "QD", "Q2START"), (4, "QE", "Q2UP"), (5, "QF", "Q2DOWN"),
         (6, "QG", "Q2LEFT"), (7, "QH", "Q2RIGHT"), (9, "QH'", "NC")], extra="port 2 byte, chained")
    sh.note(60, 640, ["Why the 595s: sixteen bits shift in over SPI at any time; nothing changes at the 165s until one RCLK",
                      "rising edge moves both bytes to the outputs in one ~10 ns step. A tear during a load becomes impossible,",
                      "and the firmware still only pulses RCLK while both OUT0 lines read low. 3V3 outputs into HCT inputs",
                      "(Vih 2.0 V) is in spec. 3 GPIOs replace 8; port 2 costs none. DS on both 165s to GND: bit 9+ reads 1."])
    sh.bank(160, 760, ["C1", "C2"], "100nF", "+5V", "GND")
    sh.note(300, 764, ["U1, U2, U6 supply pins; C5 for U8"])
    sh.bank(560, 760, ["C3", "C4"], "100nF", "3V3", "GND")
    sh.note(700, 764, ["U5, U7 (and U3) supply pins"])

    sh.zone(1480, 60, 900, 780, "SYNC SEPARATOR, +5V")
    sh.chip(1640, 90, 150, "U8", "LM1881N  at +5V", [
        (2, "VIDEO IN", "VID_AC"), (6, "RSET", "RSET"), (8, "VCC", "+5V"), (4, "GND", "GND")],
        [(1, "CSYNC", "CSYNC_5"), (3, "VSYNC", "VSYNC_5"), (5, "BURST", "NC"), (7, "ODD/EVEN", "NC")], extra="composite sync out")
    sh.twopin(1640, 330, "C6", "100nF", "VIDEO", "VID_AC")
    sh.note(1780, 334, ["AC couple from the console's video (75R load present)"])
    sh.twopin(1640, 380, "R2", "680k", "RSET", "GND")
    sh.twopin(1640, 430, "C7", "100nF", "RSET", "GND")
    sh.note(1520, 500, ["Tap VIDEO after Q1 (the AUX/RF input), the point the", "scope already probes; a 1k series R protects the tap.",
                        "VSYNC: one falling edge per field, 60.0988/s.", "CSYNC: one falling edge per line plus the vsync block;",
                        "the NES has no serrations, so count = lines - 2 (measure).",
                        "Both are 5V outputs: through the 245 like the port lines."])

    sh.zone(20, 860, 2360, 410, "BRIDGE SIDE, 3V3 logic")
    sh.chip(200, 890, 150, "U3", "74LVC245  at 3V3", [
        (1, "DIR", "3V3"), (19, "/OE", "GND"), (2, "A1", "CON1_OUT0"), (3, "A2", "CON1_CLK"), (4, "A3", "CON2_OUT0"), (5, "A4", "CON2_CLK"),
        (6, "A5", "VSYNC_5"), (7, "A6", "CSYNC_5"), (8, "A7,A8", "GND"), (20, "VCC", "3V3"), (10, "GND", "GND")],
        [(18, "B1", "LATCH1"), (17, "B2", "CLK1"), (16, "B3", "LATCH2"), (15, "B4", "CLK2"), (14, "B5", "VSYNC"), (13, "B6", "CSYNC")],
        extra="six lines down to 3V3")
    esp32c6(sh, 620, 890, [
        (None, "GPIO0", "LATCH1"), (None, "GPIO1", "CLK1"), (None, "GPIO10", "CLK2"), (None, "GPIO11", "CSYNC"),
        (None, "GPIO21", "LATCH2"), (None, "GPIO22", "VSYNC"), (None, "3V3", "3V3"), (None, "GND", "GND"), (None, "USB-UART", "PI_USB")],
        [(None, "GPIO18", "SCK"), (None, "GPIO19", "MOSI"), (None, "GPIO20", "RCLK"), (None, "GPIO2", "PAD_LATCH"), (None, "GPIO3", "PAD_CLK"),
         (None, "GPIO6", "PAD1_D0"), (None, "GPIO23", "PAD2_D0"), (None, "GPIO7", "TRIG")])
    sh.note(520, 1200, ["PCNT unit 0: LATCH1 rises (latch index, port 1)", "PCNT unit 1: CLK1 falls (clocks per poll, port 1)",
                        "PCNT unit 2: CLK2 falls (clocks per poll, port 2)", "PCNT unit 3: CSYNC falls (line counter)",
                        "GPIO21, GPIO22: ISR, 60/s each, timestamp + PCNT3 snapshot", "(a 3 us ISR latency is 5% of a 63.5 us line)",
                        "All 14 free pins used; 4, 5, 8, 9, 12, 13, 15, 16, 17 untouched"])
    pad_socket(sh, 1200, 890, "J2", "PAD_LATCH", "PAD_CLK", "PAD1_D0")
    pad_socket(sh, 1560, 890, "J4", "PAD_LATCH", "PAD_CLK", "PAD2_D0")
    sh.note(1200, 1160, ["Both pads share the bridge's own latch and clock; each has its own D0. Polled together at 1 kHz."])
    sh.twopin(1900, 920, "R1", "100R", "TRIG", "EXT_TRIG")
    sh.note(1900, 950, ["EXT TRIG; fires at a latch index,", "or at (field, line)"])
    sh.note(1200, 1220, ["L line, v2:  L <latch> <byte> <clocks> <t_us> <field> <line>", "L2 line for port 2. F line per field: F <field> <t_us> <lines>.",
                        "MUTATE ON swaps PCNT 0 and 1 pins at runtime (B0's red run).",
                        "Head and relays: unchanged from v1 (Pi GPIO17 reset, GPIO27 power)."])
    sh.note(60, 600, ["C6 -> 595 level: the C6's 3.3 V SCK, MOSI, RCLK each pass through two gates of a second 74HCT04 (U9, +5V):",
                      "HCT accepts a 3.3 V high, and two inversions give a full 5 V non-inverted copy. No LS245, no pullups."])
    sh.done(OUT / "bench-v2.svg")


# ------------------------------------------------------------- logical sheet
# --------------------------------------------------------------- sheet v2b
V2B_TITLE = "nes-bench bridge v2b: the UNO version, two ports, sync counted, one supply"
V2B_SUB = ("v1b plus a second 165/595 pair on the same SPI chain and an LM1881 whose 5 V outputs go "
           "straight into the UNO. 2026-09-09. Not built.")
Q1_NETS = ["Q1A", "Q1B", "Q1SEL", "Q1START", "Q1UP", "Q1DOWN", "Q1LEFT", "Q1RIGHT"]
Q2_NETS = ["Q2A", "Q2B", "Q2SEL", "Q2START", "Q2UP", "Q2DOWN", "Q2LEFT", "Q2RIGHT"]


def _v2b_body_1(sh):
    band = "PORT 1: THE CONSOLE PORT, THE INVERTER AND ITS REGISTER, ALL AT +5V"
    console_port(sh, *sh.slot(0, 0, label=band), "J1",
                 {"clk": "CON1_CLK", "out0": "CON1_OUT0", "d0": "CON1_D0"}, supply="NC")
    x, y = sh.slot(0, 1)
    sh.chip(x, y, 130, "U1", "74HCT04  at +5V",
            [(1, "1A", "CON1_OUT0"), (3, "2A", "CON2_OUT0"), (14, "VCC", "+5V"), (7, "GND", "GND")],
            [(2, "1Y", "/PL1"), (4, "2Y", "/PL2")],
            extra="4 spare inputs to GND")
    hct165(sh, *sh.slot(0, 2), "U2", "/PL1", "CON1_CLK", "CON1_D0",
           part="74HC165  at +5V", inputs=Q1_NETS)
    band2 = "WHAT THE CONSOLE DOES, AND WHAT MAY NOT MOVE WHILE IT DOES IT"
    sh.note(*sh.slot(1, 0, label=band2), [
        "OUT0 high: U1 drives /PL1 low and U2 loads its eight inputs. It is transparent while low, so the",
        "byte must already be on U5's outputs (sheet 3). OUT0 falls, /PL1 goes high, the byte is held, and",
        "QH shows A. Each CLK rising edge shifts the next bit out. DS to GND means the ninth read and",
        "later return 1 to the console, which is what an original pad does. Pressed is LOW.",
        "Port 2 is the same circuit on sheet 2. It shares this inverter, U1's second channel, and",
        "the SPI chain; it has its own register, its own pad and its own D0."])


def _v2b_body_2(sh):
    band = "PORT 2: THE SECOND CONSOLE PORT AND ITS REGISTER, ALL AT +5V"
    console_port(sh, *sh.slot(0, 0, label=band), "J3",
                 {"clk": "CON2_CLK", "out0": "CON2_OUT0", "d0": "CON2_D0"}, supply="NC")
    hct165(sh, *sh.slot(0, 1), "U6", "/PL2", "CON2_CLK", "CON2_D0",
           part="74HC165  at +5V", inputs=Q2_NETS)
    band2 = "DECOUPLING, AND WHY THE REGISTERS ARE WRITTEN THE WAY THEY ARE"
    sh.bank(*sh.slot(1, 0, label=band2), ["C1", "C2", "C3", "C4", "C5", "C6"], "100nF", "+5V", "GND")
    sh.note(*sh.slot(1, 1), ["one across each of U1, U2, U5,", "U6, U7 and U8, at its own",
                             "supply pins"])
    sh.note(*sh.slot(1, 2), [
        "Two SPI.transfer() calls, port 2's byte first and then port 1's, and one RCLK",
        "edge updates both registers together. A tear during a load is impossible, and the",
        "firmware still only pulses RCLK while both OUT0 lines read low.",
        "The UNO's outputs are 5 V, so HC parts at 5 V see real highs everywhere. There is",
        "not one level shifter on any sheet of this drawing."])


def _v2b_body_3(sh):
    band = "THE UNO AND THE TWO OUTPUT REGISTERS ON ONE SPI CHAIN, ALL AT +5V"
    x, y = sh.slot(0, 0, label=band)
    sh.chip(x, y, 200, "A1", "Arduino UNO R3 (ATmega328P)", [
        (None, "D13 SCK", "SCK"), (None, "D11 MOSI", "MOSI"), (None, "D10", "RCLK"),
        (None, "D5 (T1)", "CON1_OUT0"), (None, "D2 (INT0)", "CON1_CLK"),
        (None, "D3 (INT1)", "CSYNC"), (None, "D4 (PCINT)", "CON2_OUT0"),
        (None, "D9 (PCINT)", "CON2_CLK"), (None, "A0 (PCINT)", "VSYNC")],
        [(None, "A1", "TRIG"), (None, "D6", "PAD_LATCH"), (None, "D7", "PAD_CLK"),
         (None, "D8", "PAD1_D0"), (None, "A2", "PAD2_D0"), (None, "5V", "+5V"),
         (None, "GND", "GND"), (None, "USB-B", "PI_USB")], extra="serial 115200 to the Pi")
    x, y = sh.slot(0, 1)
    sh.chip(x, y, 140, "U5", "74HC595  at +5V", [
        (14, "SER", "MOSI"), (11, "SRCLK", "SCK"), (12, "RCLK", "RCLK"), (13, "/OE", "GND"),
        (10, "/SRCLR", "+5V"), (16, "VCC", "+5V"), (8, "GND", "GND")],
        [(15, "QA", "Q1A"), (1, "QB", "Q1B"), (2, "QC", "Q1SEL"), (3, "QD", "Q1START"),
         (4, "QE", "Q1UP"), (5, "QF", "Q1DOWN"), (6, "QG", "Q1LEFT"), (7, "QH", "Q1RIGHT"),
         (9, "QH'", "CHAIN")], extra="port 1's byte, shifted in second")
    x, y = sh.slot(0, 2)
    sh.chip(x, y, 140, "U7", "74HC595  at +5V", [
        (14, "SER", "CHAIN"), (11, "SRCLK", "SCK"), (12, "RCLK", "RCLK"), (13, "/OE", "GND"),
        (10, "/SRCLR", "+5V"), (16, "VCC", "+5V"), (8, "GND", "GND")],
        [(15, "QA", "Q2A"), (1, "QB", "Q2B"), (2, "QC", "Q2SEL"), (3, "QD", "Q2START"),
         (4, "QE", "Q2UP"), (5, "QF", "Q2DOWN"), (6, "QG", "Q2LEFT"), (7, "QH", "Q2RIGHT"),
         (9, "QH'", "NC")], extra="port 2's byte, chained from U5")
    band2 = "WHAT COUNTS WHAT, AND THE HEAD"
    sh.note(*sh.slot(1, 0, label=band2), [
        "LATCH1 on Timer1's external clock: hardware, and the",
        "reference every software count is checked against.",
        "CLK1 on INT0, CSYNC on INT1. LATCH2, CLK2 and VSYNC",
        "on pin-change ISRs. The 8-per-latch and polls-per-field",
        "gates cross-check them; a count that stays green under",
        "MUTATE (the D2/D5 jumper swap, D4 the config pin) is a",
        "broken count. A1 rises at latch T or at (field, line).",
        "L <latch> <byte> <clocks> <t_us> <field> <line>;",
        "L2 for port 2; F <field> <t_us> <lines>."])
    sh.note(*sh.slot(1, 1), [
        "Head and relays, unchanged from v1b. Pi GPIO17 to a",
        "PC817 or one TLP281 channel, to the console's reset",
        "pads, 100 ms. Pi GPIO27 to the relay module's IN",
        "(active low); relay VCC from the Pi's 5 V pin, because",
        "the modules on hand are 5 V coil parts. One",
        "normally-open contact in series with one lead of the AC",
        "adapter cable, never the mains side and never both.",
        "Scope: video on CH3, EXT TRIG from R1 (sheet 4),",
        "SCPI over the LAN."])


def _v2b_body_4(sh):
    band = "THE SYNC SEPARATOR, THE BRIDGE'S OWN PADS AND THE TRIGGER, ALL AT +5V"
    x, y = sh.slot(0, 0, label=band)
    sh.chip(x, y, 150, "U8", "LM1881N  at +5V", [
        (2, "VIDEO IN", "VID_AC"), (6, "RSET", "RSET"), (8, "VCC", "+5V"), (4, "GND", "GND")],
        [(1, "CSYNC", "CSYNC"), (3, "VSYNC", "VSYNC"), (5, "BURST", "NC"), (7, "ODD/EVEN", "NC")],
        extra="5 V outputs: no 245 needed")
    pad_socket(sh, *sh.slot(0, 1), "J2", "PAD_LATCH", "PAD_CLK", "PAD1_D0", vcc="+5V")
    pad_socket(sh, *sh.slot(0, 2), "J4", "PAD_LATCH", "PAD_CLK", "PAD2_D0", vcc="+5V")
    band2 = "THE PASSIVES ON THIS SHEET"
    sh.twopin(*sh.slot(1, 0, label=band2), "C7", "100nF", "VIDEO", "VID_AC")
    sh.twopin(*sh.slot(1, 1), "R2", "680k", "RSET", "GND")
    sh.twopin(*sh.slot(1, 2), "C8", "100nF", "RSET", "GND")
    sh.twopin(*sh.slot(1, 3), "R1", "100R", "TRIG", "EXT_TRIG")
    band3 = "WHERE THESE SIGNALS COME FROM AND WHAT THEY ARE WORTH"
    sh.note(*sh.slot(2, 0, label=band3), [
        "C7 AC couples the console's video, tapped after Q1 at the AUX/RF",
        "input with a 1k series resistor: the point the scope already probes.",
        "VSYNC: one falling edge per field, 60.0988/s.",
        "CSYNC: one per line plus the vsync block. The NES emits no",
        "serrations, so the count per field is lines minus k, and k is",
        "measured rather than assumed."])
    sh.note(*sh.slot(2, 1), [
        "R1 goes to the DS1054Z's rear EXT TRIG. Check the input's rating",
        "first; if 5 V exceeds it, a 2:1 divider (two 1k) after R1.",
        "Both pads are polled by the same PAD_LATCH and PAD_CLK and answer",
        "on their own D0, so one poll reads both. They are the pad halves",
        "of two cut controller cables, and they run at the 5 V they were",
        "built for."])


def sheet_v2b():
    """One schematic on four landscape letter sheets."""
    q1 = {q: "3" for q in Q1_NETS}
    q2 = {q: "3" for q in Q2_NETS}
    laid(OUT / "bench-v2b-1.svg", V2B_TITLE + "  (sheet 1 of 4: port 1)", V2B_SUB, _v2b_body_1,
         LETTER, links={"CON1_OUT0": "3", "CON1_CLK": "3", "CON2_OUT0": "2,3", "/PL2": "2", **q1})
    laid(OUT / "bench-v2b-2.svg", V2B_TITLE + "  (sheet 2 of 4: port 2)", V2B_SUB, _v2b_body_2,
         LETTER, links={"CON2_OUT0": "1,3", "CON2_CLK": "3", "/PL2": "1", **q2})
    laid(OUT / "bench-v2b-3.svg", V2B_TITLE + "  (sheet 3 of 4: the UNO and the registers)",
         V2B_SUB, _v2b_body_3, LETTER,
         links={"CON1_OUT0": "1", "CON1_CLK": "1", "CON2_OUT0": "1,2", "CON2_CLK": "2",
                "CSYNC": "4", "VSYNC": "4", "TRIG": "4", "PAD_LATCH": "4", "PAD_CLK": "4",
                "PAD1_D0": "4", "PAD2_D0": "4",
                **{q: "1" for q in Q1_NETS}, **{q: "2" for q in Q2_NETS}})
    laid(OUT / "bench-v2b-4.svg", V2B_TITLE + "  (sheet 4 of 4: sync, the pads and the trigger)",
         V2B_SUB, _v2b_body_4, LETTER,
         links={"CSYNC": "3", "VSYNC": "3", "TRIG": "3", "PAD_LATCH": "3", "PAD_CLK": "3",
                "PAD1_D0": "3", "PAD2_D0": "3"})


def sheet_logic():
    sh = Sheet(1500, 900, "nes-bench: the logic of one poll, and what is counted",
               "timing lanes for one controller read on the part; widths marked authored are B0 measure-first item 3's to replace")
    L, R = 200, 1440
    lanes = [("OUT0 (console)", 90), ("/PL = not OUT0", 150), ("165 state", 210), ("CLK (console)", 280), ("D0 (165 QH)", 350),
             ("PCNT 0 (latch)", 430), ("PCNT 1 (clock)", 490), ("ESP32 loop", 560), ("safe to write", 630)]
    for name, y in lanes:
        sh.text(L - 10, y + 4, name, "lanelbl", "end")
        sh.add(f'<line x1="{L}" y1="{y+22}" x2="{R}" y2="{y+22}" stroke="#d0d7de" stroke-width="1"/>')
    # time scale: latch at t0=260px, high for 40px; clocks every 70px from 340
    t0, hw = 260, 40
    clk = [400 + i * 75 for i in range(8)]
    cw = 12
    hi, lo = -18, 18

    def lane_path(y, segs):
        d = f"M{L},{y+lo}"
        for (x1, x2, level) in segs:
            yy = y + (hi if level else lo)
            d += f" L{x1},{y+lo if level else y+hi} L{x1},{yy} L{x2},{yy}"
        d += f" L{R},{y+lo}"
        return d
    # OUT0: low, high pulse, low
    sh.add(f'<path class="lane" d="M{L},{90+lo} L{t0},{90+lo} L{t0},{90+hi} L{t0+hw},{90+hi} L{t0+hw},{90+lo} L{R},{90+lo}"/>')
    sh.text(t0 + hw / 2, 90 + hi - 6, "STA $4016 = 1 ... = 0", "auth", "middle")
    sh.text(t0 + hw / 2, 90 + lo + 14, "high ~3 us (authored)", "auth", "middle")
    # /PL: high, low pulse, high
    sh.add(f'<path class="lane" d="M{L},{150+hi} L{t0},{150+hi} L{t0},{150+lo} L{t0+hw},{150+lo} L{t0+hw},{150+hi} L{R},{150+hi}"/>')
    sh.add(f'<rect class="win" x="{t0}" y="{140}" width="{hw}" height="{90}"/>')
    sh.text(t0 + hw + 6, 150 + lo, "load window: 165 is transparent, inputs must not change", "auth")
    # 165 state
    sh.text(L + 4, 210 + 4, "holding previous", "pin")
    sh.text(t0 + hw + 30, 210 + 4, "held: A on QH", "pin")
    for i, x in enumerate(clk):
        nm = ["B", "Sel", "Start", "Up", "Down", "Left", "Right", "DS=0"][i]
        sh.text(x + cw + 4, 210 + 4, nm, "pin")
    # CLK: high idle, low pulses
    d = f"M{L},{280+hi}"
    for x in clk:
        d += f" L{x},{280+hi} L{x},{280+lo} L{x+cw},{280+lo} L{x+cw},{280+hi}"
    d += f" L{R},{280+hi}"
    sh.add(f'<path class="lane" d="{d}"/>')
    sh.text(clk[0], 280 + lo + 14, "LDA $4016: /OE1 low ~500 ns (authored); 4021 and 165 shift on the rising edge", "auth")
    sh.text(clk[1] + 20, 280 + hi - 6, "~7 us between reads (authored)", "auth")
    # D0 bits: show A pressed (low) at first, rest high, last low
    bits = [0, 1, 1, 1, 1, 1, 1, 1, 0]  # A pressed, DS low after 8
    edges = [t0 + hw] + [x + cw for x in clk]
    d = f"M{L},{350+hi}"
    for i, x in enumerate(edges):
        y = 350 + (lo if bits[i] == 0 else hi)
        d += f" L{x},{350+ (hi if i == 0 else (lo if bits[i-1] == 0 else hi))} L{x},{y}"
        nxt = edges[i + 1] if i + 1 < len(edges) else R
        d += f" L{nxt},{y}"
    sh.add(f'<path class="lane" d="{d}"/>')
    sh.text(t0 + hw + 4, 350 + lo + 14, "A pressed: LOW", "pin")
    sh.text(clk[7] + cw + 4, 350 + lo + 14, "9th+ read: LOW (console reads 1)", "pin")
    # PCNT marks
    sh.add(f'<line class="mark" x1="{t0}" y1="{430-14}" x2="{t0}" y2="{430+18}"/>')
    sh.text(t0 + 5, 430 + 4, "+1 on OUT0 rising edge: latch index n", "net")
    for x in clk:
        sh.add(f'<line class="mark" x1="{x}" y1="{490-14}" x2="{x}" y2="{490+18}"/>')
    sh.text(clk[0] + 5, 490 + 4, "+1 per CLK falling edge: 8 per poll, 9 on a DMC collision (alias rule excepted)", "net")
    # ESP loop
    for i in range(0, 14):
        x = L + 30 + i * 90
        sh.add(f'<line x1="{x}" y1="{560-12}" x2="{x}" y2="{560+12}" stroke="#57606a" stroke-width="1"/>')
    sh.text(L + 34, 560 - 16, "loop ~100 us: read PCNT deltas, emit L, then write the byte", "note")
    # safe window
    sh.add(f'<rect class="safe" x="{L}" y="{618}" width="{t0-L-8}" height="{28}"/>')
    sh.add(f'<rect class="safe" x="{t0+hw+8}" y="{618}" width="{R-(t0+hw+8)}" height="{28}"/>')
    sh.text(L + 6, 630 + 4, "write allowed", "pin")
    sh.text(t0 + hw + 14, 630 + 4, "write allowed (v1: OUT0 reads low before and after; v2: RCLK edge is atomic anyway)", "pin")

    # counting model
    sh.zone(20, 690, 1460, 190, "WHAT A RUN IS: the same history on both sides")
    def mono(x, y, lines):
        for i, l in enumerate(lines):
            sh.text(x, y + i * 13, l, "pin")
    mono(40, 725, [
        "latch index n     count of OUT0 rising edges since RESET. Part: PCNT 0. Model: $4016 strobe rises in nes-glue::controller.",
        "byte at n         what the register held when OUT0 fell at n. Part: written after latch n-1 (v1) or moved by RCLK after n-1 (v2). Model: set_pad before latch n.",
        "clocks at n       CLK falling edges between latch n and n+1. Part: PCNT 1 delta. Model: $4016 reads. 8 expected; 9 on a DMC collision.",
        "t_us at n (v2)    micros() at detection, jitter one loop. Gives latch interval and, against F lines, polls per field without the scope.",
        "field f, line l   (v2) VSYNC falling edges since RESET; CSYNC falling edges since the last VSYNC. Model: h at the strobe, mapped by B2's alignment class.",
        "trigger           EXT TRIG rises at latch T (v1) or at (f, l) (v2); the scope's single shot lands on a known frame of a known history.",
        "",
        "Script (docs/script.md) -> head (Pi) -> bridge over USB serial -> 165 -> console.    Console -> L lines -> head -> runs/<stamp>/bridge.log.",
        "Same script -> nes-console pad-log -> the same L lines.    compare-logs.py: first latch where byte or clocks differ.    b1-score: capture at T vs model frame at T.",
        "MUTATE (v2 command): PCNT 0 and 1 swapped -> 8-per-latch check must go red.  A gate that stays green under MUTATE is a broken gate.",
    ])
    sh.done(OUT / "logical-timing.svg")


# ------------------------------------------------------------ pad adapter
def sheet_pad():
    sh = Sheet(1700, 940, "OG pad to BLE / USB HID adapter: the bridge's pad poll, made portable",
               "ESP32-S3 for USB HID + BLE; ESP32-C6 works for BLE only (its USB port is serial/JTAG, not a device controller). Not built as drawn; the one-pad USB subset is, on an ESP32-P4 (TM-NESB-003).")
    sh.zone(20, 60, 720, 560, "PADS, polled at 3V3 exactly as the bridge polls them")
    pad_socket(sh, 160, 90, "J1", "PAD_LATCH", "PAD_CLK", "PAD1_D0")
    pad_socket(sh, 160, 340, "J2", "PAD_LATCH", "PAD_CLK", "PAD2_D0")
    sh.note(340, 100, ["The pad's 4021 is a CMOS part rated 3 to 18 V.", "At 3V3 its D0 is 3V3 logic and needs no shifter.",
                       "Measure-first item 4 CLOSED 2026-09-27 on the P4 build:", "an original runs at 3V3, no 245 needed; if a pad will",
                       "not run at 3V3, add a 74LVC245 and feed the pad 5 V.",
                       "", "Poll: OUT0 high 12 us, low, 8 clocks at 1 us,", "read D0 before each rising edge. 1 kHz.",
                       "The same poll_pad() as firmware/bridge/bridge.ino."])
    sh.twopin(400, 268, "R1", "10k", "PAD1_D0", "3V3")
    sh.twopin(400, 292, "R2", "10k", "PAD2_D0", "3V3")
    sh.note(340, 318, ["One pullup per pad, each to its OWN D0, so an unplugged socket reads",
                       "'nothing pressed' rather than all eight.",
                       "",
                       "CORRECTED 2026-09-21: these were drawn with bank(), which is N parts",
                       "between the SAME two nets, so pad 1 carried two pullups and pad 2 none",
                       "while the note beside them claimed 'both pads'. The netlist recorded",
                       "what was drawn, so nothing downstream disagreed with it."])

    sh.zone(760, 60, 920, 560, "CONTROLLER AND POWER")
    sh.chip(900, 90, 190, "U1", "ESP32-C6-DevKitC-1 v1.2", [
        (None, "GPIO2", "PAD_LATCH"), (None, "GPIO3", "PAD_CLK"), (None, "GPIO6", "PAD1_D0"), (None, "GPIO7", "PAD2_D0"),
        (None, "GPIO10", "MODE_SW"), (None, "GPIO11", "LED"), (None, "3V3", "3V3"), (None, "GND", "GND")],
        [(None, "BLE", "radio"), (None, "5V in", "VBUS")], extra="NimBLE HID; no USB device")
    sh.note(900, 300, ["CORRECTED 2026-09-21. This sheet carried the S3's pin numbers while",
                       "offering the C6 as the on-hand part, and three of them are pins the C6",
                       "must not use: GPIO4, GPIO5 and GPIO15 are strapping pins there",
                       "(docs/wiring.md, 'left alone'). The map above is the one",
                       "firmware/bridge/bridge.ino ALREADY polls a pad on, so poll_pad() runs",
                       "unedited and step 2 of the build order needs no firmware change.",
                       "",
                       "An S3 needs its own map and not this one: GPIO3 is a strapping pin",
                       "there, and GPIO19/20 are its USB. One map does not fit both parts,",
                       "and pretending it does is what put GPIO4 on this drawing."])
    sh.chip(1300, 90, 150, "U2", "TP4056 + protection", [(None, "IN+", "VBUS"), (None, "IN-", "GND")],
            [(None, "BAT+", "VBAT"), (None, "BAT-", "GND"), (None, "OUT+", "VBAT_SW")], extra="LiPo charger module")
    sh.chip(1300, 340, 150, "U3", "MCP1700-3302 LDO", [(None, "VIN", "VBAT_SW"), (None, "GND", "GND")], [(None, "VOUT", "3V3")],
            extra="or the devkit's own 3V3 from VBUS")
    sh.twopin(800, 400, "SW1", "slide", "MODE_SW", "GND")
    sh.note(900, 404, ["open = gamepad HID, closed = keyboard HID"])
    sh.twopin(800, 450, "SW2", "power", "VBAT", "VBAT_SW")
    sh.twopin(800, 500, "LED1", "+330R", "LED", "GND")
    sh.note(800, 540, ["Power: on USB, VBUS feeds the devkit and charges the cell; unplugged, the cell through",
                       "the LDO. A 500 mAh cell runs an S3 in BLE modem sleep for a day (authored; measure).",
                       "Skip the battery entirely for a USB-only cable adapter: the S3 devkit alone is the whole thing."])

    sh.zone(20, 640, 1660, 290, "WHAT THE HOST SEES")
    def mono(x, y, lines):
        for i, l in enumerate(lines):
            sh.text(x, y + i * 13, l, "pin")
    mono(40, 675, [
        "Keyboard mode   BLE HID keyboard (or USB HID keyboard). Buttons map to keys: A=x B=z Select=RShift Start=Enter D-pad=arrows (configurable).",
        "                Works with any phone, tablet or PC, browser emulators included, with no game-controller support needed. iOS accepts BLE keyboards natively.",
        "Gamepad mode    BLE HID gamepad report (8 buttons + hat). Android, Windows, Linux, macOS and Steam take generic HID gamepads;",
        "                iOS only takes MFi, Xbox and PlayStation layouts, so keyboard mode is the iOS answer. USB HID gamepad on the S3 works everywhere.",
        "Bench mode      Wi-Fi: the adapter streams pad bytes over UDP to the head at 1 kHz, keyed by its own poll count. The head schedules them as AT lines",
        "                onto the bridge, so a hand on a wireless pad becomes a scripted, logged, replayable history. Same L format, one more source.",
        "Two pads        one adapter, two HID interfaces (or two report IDs); both polled on the shared latch and clock.",
        "Latency         1 kHz poll + BLE 7.5 ms connection interval: 8 to 10 ms authored; USB HID 1 ms polling: ~2 ms authored. Measure with the bench's own trigger.",
    ])
    sh.done(OUT / "pad-adapter.svg")


# --------------------------------------------------------- pad-ble build
def sheet_padble():
    """The buildable subset of the pad adapter, and the only one of these
    sheets whose parts are all in the drawer.

    pad-adapter.svg is the whole idea: two pads, a mode switch, a cell, a
    charger, an LDO, and either an S3 for USB HID or a C6 for BLE. Most
    of that is on order. This is what can be wired on the breadboard the
    C6 is already seated in, and it is a separate sheet for the same
    reason bench-v1b is separate from bench-v1: a sheet somebody builds
    from has to show the parts they have, or they spend the evening
    reading around the ones they do not.

    So: two pads, two pullups, the C6 on USB power. No cell, no charger,
    no LDO, no switch. MODE_SW and LED are declared NC rather than left
    unmentioned, because an unmentioned pin is silence and this repo's
    netlist refuses silence on a pin that could have been wired.
    """
    sh = Sheet(1560, 1060, "pad-ble v1: two original pads into an ESP32-C6, as a BLE keyboard",
               "The buildable subset of pad-adapter.svg: USB powered, no cell, no charger, no mode switch. The board on "
               "the bench is an ESP32-C6-DevKitC-1 v1.2, read off its RGB@IO8 silkscreen 2026-09-21. Nothing built.")

    sh.zone(20, 66, 690, 700, "THE PAD, polled at 3V3 exactly as the bridge polls one")
    pad_socket(sh, 150, 100, "J1", "PAD_LATCH", "PAD_CLK", "PAD1_D0")
    sh.note(330, 110, [
        "The pad's 4021 is a CMOS part rated 3 to 18 V, so at 3V3 its",
        "D0 is 3V3 logic and needs no shifter. That is the datasheet,",
        "not this bench: MEASURE FIRST, item 4. If a pad will not",
        "follow its buttons at 3V3, add a 74LVC245 and feed the pad",
        "5 V; the 245 is on hand.",
        "",
        "ONE PAD, and that is the design rather than a first step. A BLE",
        "keyboard report carries six key slots and two pads can ask for",
        "ten, so a second pad could be polled and never sent. One was on",
        "this sheet until 2026-09-23 doing exactly that: wired, pulled",
        "up, given a pin, and thrown away. Two players wants gamepad",
        "mode with two report IDs, which is pad-adapter.svg's job.",
        "",
        "Pin 5 is the supply and 6 and 7 carry nothing, as measured on",
        "this console's own cable (docs/wiring.md). RING THE CABLE OUT",
        "UNPLUGGED: a tone through a cable still in the console runs",
        "through its pull-ups, and pins that share nothing beep.",
    ])
    sh.twopin(330, 690, "R1", "10k", "PAD1_D0", "3V3")

    sh.zone(730, 66, 810, 700, "THE CONTROLLER, on USB power")
    sh.chip(900, 100, 210, "U1", "ESP32-C6-DevKitC-1 v1.2", [
        (None, "GPIO2", "PAD_LATCH"), (None, "GPIO3", "PAD_CLK"),
        (None, "GPIO6", "PAD1_D0"),
        (None, "GPIO10", "NC"), (None, "GPIO11", "NC"),
        (None, "3V3", "3V3"), (None, "GND", "GND")],
        [(None, "BLE", "radio"), (None, "USB-C", "VBUS")],
        extra="NimBLE HID keyboard; no USB device controller")
    sh.twopin(820, 430, "C1", "100nF", "3V3", "GND")
    sh.note(760, 480, [
        "NOT GPIO4, GPIO5 or GPIO15: strapping pins on the C6. The three",
        "pad pins above are the map firmware/bridge/bridge.ino already",
        "polls a pad on, so firmware/pad-ble reuses poll_pad unedited.",
        "",
        "GPIO10 (MODE_SW) and GPIO11 (LED) are NC here: the firmware reads",
        "one with a pullup and drives the other, and neither is wired.",
        "Declared rather than omitted, so the netlist sees a statement",
        "instead of silence.",
        "",
        "C1 sits across the devkit's own 3V3 and GND pins. The devkit is",
        "regulated already; this is for the breadboard's inductance, which",
        "is what the bridge's own 100 nF was added for on 2026-09-15.",
    ])

    sh.zone(20, 790, 1520, 210, "WHAT THIS BOARD CAN AND CANNOT DO, and why the answer is in silicon")
    # Two text columns, not one string with padding: SVG collapses runs
    # of spaces, so a label column written with spaces reads as the first
    # words of the sentence. "BLE HID Works, and reaches a phone" was the
    # first draft of this band.
    rows = [
        ("BLE HID", [
            "Works, and reaches a phone with no app: a BLE HID-over-GATT keyboard pairs in Settings beside a Magic Keyboard. Browser emulators take keys.",
            "Needs four things, each in firmware/pad-ble/pad-ble.ino with its reason: bonding with encryption, the PnP ID, a battery service, and the HID",
            "service UUID plus the keyboard appearance IN THE ADVERTISEMENT, since a host decides what to offer as a pairable accessory from the advert alone."]),
        ("USB HID", [
            "IMPOSSIBLE ON THIS PART, and not for want of firmware. The port marked USB is a USB-Serial-JTAG bridge, fixed in silicon. Its soc_caps.h defines",
            "SOC_USB_SERIAL_JTAG_SUPPORTED and does NOT define SOC_USB_OTG_SUPPORTED, and the core gates USBHIDKeyboard.h on the latter, so it compiles away.",
            "Read off the installed esp32 core 3.3.11 on 2026-09-21, not recalled. USB HID needs an S3, S2 or P4, and an S3 does BLE too, so it gets both modes."]),
        ("Gamepad HID", [
            "Not built. iOS refuses a generic HID gamepad, taking only the MFi, Xbox, PlayStation and Switch Pro layouts, which is why keyboard mode came first."]),
        ("Two players", [
            "Not on this board. A keyboard report carries six key slots and two pads can ask for ten, so a second pad could be polled and never sent.",
            "One was drawn and polled here until 2026-09-23 doing exactly that. Two players wants gamepad mode with two report IDs, on a part that can do it."]),
        ("Bench mode", [
            "Not built, and the cheapest of them: the C6's USB already IS a serial port, so pad bytes over USB serial into a uinput shim need no new hardware."]),
    ]
    y = 824
    for label, lines in rows:
        sh.text(40, y, label, "pin")
        for l in lines:
            sh.text(168, y, l, "pin")
            y += 14
        y += 4
    sh.done(OUT / "pad-ble.svg")


def sheet_padble_p4():
    """The same adapter on the part that actually works.

    pad-ble.svg is this circuit around an ESP32-C6-DevKitC-1, and that
    board has never accepted a flash: two evenings of "no serial data
    received" with the port, the cable, the wiring and ModemManager
    each ruled out by test. On 2026-09-24 a Waveshare
    ESP32-P4-Module-DEV-KIT on the same bench connected first try, took
    the firmware and put a BLE advertisement on the air that an
    independent radio heard.

    So this is the buildable sheet now, and the C6 one stays where it
    is. A published drawing is a record of what was drawn; overwriting
    it in place loses that, and somebody holding a C6 still needs it.

    EVERY PIN HERE COMES OUT OF tools/p4_header.py, which read them
    from Waveshare's own schematic and holds itself to two counts a
    misreading fails. Nothing on this sheet is typed twice.
    """
    import p4_header as ph
    og = ph.og_lead_by_pin()

    sh = Sheet(1560, 1060, "pad-ble v1 on the ESP32-P4: one pad into header P6, as a USB keyboard",
               "The build is USB now, not BLE. A Waveshare ESP32-P4-Module-DEV-KIT, header read from the vendor schematic "
               "2026-09-24 and every hole confirmed with firmware/header-probe 2026-09-25. The wiring is the same either way.")

    sh.zone(20, 66, 690, 700, "THE PAD, polled at 3V3 exactly as the bridge polls one")
    pad_socket(sh, 150, 100, "J1", "PAD_LATCH", "PAD_CLK", "PAD1_D0",
               part="original NES pad (MN4021B)",
               extra="  ".join(f"{k} {og[k]}" for k in sorted(og)) + ", NOT measured")
    sh.note(330, 110, [
        "Unchanged from pad-ble.svg, and that is the point: GPIO2, 3 and",
        "6 exist and are free on BOTH parts, so poll_pad in",
        "firmware/pad-ble runs unedited on either. One sketch, one pad",
        "map, two targets.",
        "",
        "The pad's 4021 is a CMOS part rated 3 to 18 V, so at 3V3 its D0",
        "is 3V3 logic and needs no shifter. MEASURED 2026-09-27: an",
        "original's MN4021B follows its buttons at 3V3, 27 presses in",
        "30 s under firmware/pad-diag. No 74LVC245 needed. A 10 ohm part",
        "fitted as the 10k pull-up hid it first: read the bands.",
        "",
        "Pin 5 is the supply and 6 and 7 carry nothing, as measured on",
        "this console's own cable (docs/wiring.md). RING THE CABLE OUT",
        "UNPLUGGED: a tone through a cable still in the console runs",
        "through its pull-ups, and pins that share nothing beep.",
        "",
        "J1 IS DRAWN AS AN ORIGINAL PAD, in Nintendo's colours, which",
        "are documented and NOT YET MEASURED: beep each wire to the",
        "MN4021B first, at the pin the header sheet's wire table gives.",
        "The first pad on this build was a REPLICA, whose colours differ,",
        "and RED and YELLOW are different signals on each: wired by the",
        "replica's colours, an original puts its DATA on the GROUND rail.",
    ])
    sh.twopin(330, 690, "R1", "10k", "PAD1_D0", "3V3")

    sh.zone(730, 66, 810, 700, "THE CONTROLLER, on its own USB power, wired at header P6")
    pins = [(ph.PAD_BLE[n][0], ph.PAD_BLE[n][1], n)
            for n in ("PAD_LATCH", "PAD_CLK", "PAD1_D0", "3V3", "GND")]
    sh.chip(900, 100, 210, "U1", "ESP32-P4-Module-DEV-KIT", pins,
            [(None, "BLE", "radio"), (None, "USB-C", "VBUS")],
            conn=True, extra="header P6; pin numbers are P6's own")
    sh.twopin(820, 300, "C1", "100nF", "3V3", "GND")
    ctrl_note = [
        "PIN 1 IS NOT WHERE A RASPBERRY PI PUTS IT. The header is",
        "Pi-shaped and numbered the other way round: 5V on 1 and 3 where",
        "a Pi has 2 and 4, 3V3 on 2 and 18 where a Pi has 1 and 17, and",
        "every ground one pin from where a Pi user reaches. A HAT fits",
        "this board and does not work. Count from the schematic.",
        "",
        "THE WHOLE CIRCUIT IS FIVE HOLES IN A ROW. Find the SECOND 3V3",
        "on the even row; it reads",
        "",
        "        6    3V3    3    2    0    GND",
        "       p16   p18   p20  p22  p24  p26",
        "",
        "and the build takes all of them EXCEPT 0. One landmark and one",
        "hole to skip beats five numbers: wired by number on 2026-09-25,",
        "two of the three signal wires went in wrong.",
        "",
        "TEN PINS REACH P6 AND ARE STILL NOT YOURS. Worst is GPIO54",
        "(pin 31), the onboard C6's RESET: take it and the radio dies.",
        "Sheets 8 to 10 list all ten with what each is wired to.",
        "",
        "MODE_SW AND LED MOVED, and had to. On the C6 they were GPIO10",
        "and GPIO11 and cost nothing because nothing was wired to them.",
        "Here those numbers are the ES8311 codec's I2S and are not on",
        "the header at all. They are GPIO21 and GPIO20 now, P6 pins 12",
        "and 14, free and on the same even row. Declared, not wired.",
        "",
        "C1 goes across the breadboard's own 3V3 and GND rails, not the",
        "board's pins: the module is regulated already and this is for",
        "the breadboard's inductance, as on the bridge since 2026-09-15.",
    ]
    # Same guard as the band below, and for the same reason: a note that
    # grows past its zone is invisible in the SVG source and obvious only
    # in a render nobody looks at. THE CONTROLLER ZONE ENDS AT y=766.
    note_y = 350
    assert note_y + 14 * len(ctrl_note) <= 766, (
        f"the controller note overflows its zone by "
        f"{note_y + 14 * len(ctrl_note) - 766} px: shorten it or move it up")
    sh.note(760, note_y, ctrl_note)

    sh.zone(20, 782, 1520, 262, "WHAT THIS BOARD DOES, MEASURED, and why the direction changed on 2026-09-25")
    rows = [
        ("USB HID", [
            "THIS IS THE BUILD, PROVEN 2026-09-27: an original pad at 3V3, every button and chord, and a Linux host enumerating 303a:0002 NES Pad",
            "at full speed and receiving all eight keys. TinyUSB driven directly on the P4's FULL-speed OTG controller, PHY 0 (GPIO24/25) swapped",
            "from USB-Serial-JTAG to it: the Type-C socket marked USB, not PWR USB TO UART. The HOST/DEVICE jumper is the high-speed switch's and",
            "does not matter here. No radio, no co-processor, no pairing. Not yet tried: a phone, a browser page, latency. UART stays the log."]),
        ("BLE HID", [
            "REACHES THE AIR BUT CRASHES THIS FIRMWARE, and not in our code. The P4 has no radio; the module's ESP32-C6 is it, over SDIO. The host's",
            "esp-hosted 2.12.11 asks that C6 for its firmware version, gets no answer, and the failure path reads a pointer nobody filled in:",
            "always 2881 ms after BLEDevice::init. Five explanations tested and eliminated (build options and PSRAM, the security block, a delay",
            "before init, a delay after init, our own GPIO setup). A smaller sketch survives the IDENTICAL timeout, so the garbage it reads is",
            "harmless there: luck, not correctness. The proper fix is the C6's slave firmware, through the C6 UART header. Not done."]),
        ("Proven", [
            "The radio itself works: on 2026-09-24 the bench Pi's own receiver heard this board advertise at B0:A6:04:8A:D7:0E, which is NOT the",
            "P4's MAC, because the advertisement came off the C6. The BLE fault is the version RPC and its aftermath, not the link."]),
        ("Flashing", [
            "First try, where the C6 devkit never once answered. On /dev/p4-uart through the board's CH343 at 1a86:55d3. The factory image was read",
            "off and kept before anything was written: 16 MB, sha256 ad22bf07..., so this board goes back if it has to."]),
        ("Two players", [
            "Not on this sheet. A keyboard report carries six key slots and two pads can ask for ten, so a second pad could be polled and never sent."]),
    ]
    y = 812
    for label, lines in rows:
        sh.text(40, y, label, "pin")
        for l in lines:
            sh.text(168, y, l, "pin")
            y += 13
        y += 3
    # The band is drawn to hold exactly these rows. A sheet has no guard
    # against text leaving its zone, and on 2026-09-25 this one grew two
    # paragraphs and ran into the band below before anybody read it.
    assert y <= 1044, f"the capability band overflows its zone by {y - 1044} px: shorten it or grow the zone"
    sh.done(OUT / "pad-ble-p4.svg")


# ------------------------------------------------------------ the two stacks
# Flow types on the exercise sheet, each a colour and a stroke. What an
# arrow carries decides its class; the direction is the way the thing
# actually moves. Control never flows up out of a comparator, and a
# record never flows down into the console: a reader who sees a solid
# black arrow pointing at the part knows a command is what moves there.
FLOWS = {
    "cmd":  ("#1f2328", "1.4", "none",  "command: a script word, a head op, a bridge line, a GPIO level, SCPI"),
    "stim": ("#0a5b9c", "1.8", "none",  "stimulus: the pad's byte at a latch index, the console's only input"),
    "sig":  ("#b3261e", "1.8", "none",  "signal: analogue video and audio; the part's side only"),
    "rec":  ("#1a7f37", "1.4", "6 3",   "record: logs, captures, traces, verdicts; evidence, and it flows up, never down"),
    "pic":  ("#6f42c1", "1.4", "none",  "picture: a frame on its way to a score or a window"),
    "orc":  ("#a35c00", "1.3", "2 3",   "oracle: held to, every half-cycle; a comparison, not a flow"),
    "new":  ("#57606a", "1.2", "4 4",   "proposed: drawn so the words exist, built by nothing yet"),
}


def sheet_exercise():
    W, H = 1600, 1224
    sh = Sheet(W, H, "nes-bench: the two stacks, and what flows between them",
               "the physical stack and the virtual one under one script; every arrow typed by what it carries and pointed the way it moves. Dashed grey: proposed, not built.")
    sh.add("<style>" + " ".join(
        f".f-{k} {{ stroke: {c}; stroke-width: {w}; fill: none; stroke-dasharray: {d}; }} .t-{k} {{ fill: {c}; }}"
        for k, (c, w, d, _) in FLOWS.items())
        + " .fl { font-size: 9px; font-family: ui-sans-serif, system-ui, sans-serif; font-weight: 600; }"
        + " .new { fill: #ffffff; stroke: #57606a; stroke-width: 1.2; stroke-dasharray: 4 4; }"
        + " .gate { fill: #eaf7ee; stroke: #1a7f37; stroke-width: 1.3; }"
        + "</style>")
    sh.add("<defs>" + "".join(
        f'<marker id="m-{k}" viewBox="0 0 10 10" refX="9" refY="5" markerUnits="userSpaceOnUse" markerWidth="9" markerHeight="9" orient="auto">'
        f'<path d="M0,0 L10,5 L0,10 z" fill="{c}"/></marker>'
        for k, (c, _, _, _) in FLOWS.items()) + "</defs>")

    def box(x, y, w, h, ref, part, lines, cls="box"):
        # A line that would run out through the wall is a bug in the
        # drawing, not a smaller font: refuse it here.
        for l in lines:
            assert CHARW * len(l) <= w - 12, f"{ref}: '{l}' needs {CHARW * len(l):.0f} px in a {w} px box"
        assert PART_CHARW * len(part) <= w - 12, f"{ref}: part line '{part}' does not fit"
        assert 43 + len(lines) * 12 <= h + 2, f"{ref}: {len(lines)} lines do not fit {h} px"
        sh.add(f'<rect class="{cls}" x="{x}" y="{y}" width="{w}" height="{h}" rx="4"/>')
        sh.text(x + 8, y + 15, ref, "ref")
        sh.text(x + 8, y + 27, part, "part")
        for i, l in enumerate(lines):
            sh.text(x + 8, y + 43 + i * 12, l, "pin")
        return (x, y, w, h)

    def side(b, s, f=0.5):
        x, y, w, h = b
        return {"L": (x, y + h * f), "R": (x + w, y + h * f), "T": (x + w * f, y), "B": (x + w * f, y + h)}[s]

    def flow(kind, pts, label=None, lx=None, ly=None, anchor="middle", head=True):
        d = "M" + " L".join(f"{x:.0f},{y:.0f}" for x, y in pts)
        mk = f' marker-end="url(#m-{kind})"' if head else ""
        sh.add(f'<path class="f-{kind}" d="{d}"{mk}/>')
        if label:
            if lx is None:
                (x1, y1), (x2, y2) = pts[0], pts[-1]
                lx, ly = (x1 + x2) / 2, (y1 + y2) / 2 - 4
            sh.text(lx, ly, label, f"fl t-{kind}", anchor)

    # ------------------------------------------------ band A: the driver
    sh.zone(20, 66, 1560, 196, "THE DRIVER: one script, read by both sides; the regime above it; the regression beside it")
    a1 = box(40, 96, 240, 130, "E", "the exercise (this notebook)", [
        "a step = a script + a model run",
        "         + a comparator + a gate",
        "E0 regression .. E5 unattended,",
        "each adding a word to the dialect",
        "MUTATE: every gate must go red",
        "on the sabotage it names"])
    a2 = box(350, 96, 250, 130, "S", "the script, docs/script.md", [
        "RESET   POWER ON|OFF",
        "MODE PASS|INJECT   SET hh",
        "AT n hh   TRIG n   WAIT n | s S",
        "ARM name ch scale ..  CAPTURE",
        "bytes by latch index: the one",
        "history both sides can hold"])
    a3 = box(670, 96, 240, 130, "W", "tools/bench.py, the workstation", [
        "UDP JSON to the head:",
        "  status run abort bridge runs",
        "HTTP from the head: runs/<stamp>/",
        "  bridge.log, captures, .toml",
        "runs the model on the same file",
        "and calls the comparators"])
    a4 = box(980, 96, 270, 130, "M", "the model's runners (nes-console)", [
        "pad-log     the L lines the part logs",
        "trace       .pins .stim .events .overlay",
        "capture-score   the frame at latch T",
        "run-rom, picture-bench, cal-screens",
        "the same SET and AT words, honoured",
        "by latch index; the head's are skipped"])
    a5 = box(1320, 96, 240, 130, "R", "the regression, after every change", [
        "tools/rig-check.py: light, still,",
        "  boards, side eyes (the cameras)",
        "tools/bench-check.py: bridge, scope,",
        "  polls, trigger, walk, reset, power",
        "green before a step is believed;",
        "baseline: docs/rig-baseline.json"])
    flow("cmd", [side(a1, "R"), side(a2, "L")], "one script", 315, 157)
    flow("cmd", [side(a2, "R"), side(a3, "L")], "to the part", 635, 157)
    flow("cmd", [side(a2, "T", 0.7), (side(a2, "T", 0.7)[0], 88), (side(a4, "T", 0.3)[0], 88), side(a4, "T", 0.3)],
         "the same words, to the model", 800, 85)
    flow("rec", [side(a5, "L"), side(a4, "R")], "PASS or FAIL", 1285, 157)
    sh.text(1285, 173, "by name", "fl t-rec", "middle")

    # ------------------------------------------------ band B: the part
    sh.zone(20, 300, 780, 560, "THE PART")
    sh.note(40, 800, ["An NES-001, unmodified. The bench holds its controller port (the bridge), its front panel (the hands) and its",
                      "outputs (the scope, the grabber, the sound card); the eyes watch the bench itself. Nothing here is on the mains side."])
    b_head = box(40, 330, 250, 160, "PI", "Raspberry Pi 4, the head (headd.py)", [
        "serial bridge on TCP 6545",
        "GPIO17 reset, GPIO27 power",
        "SCPI to the scope on the LAN",
        "V4L2 grabber, ALSA sound card",
        "runs/<stamp>/: bridge.log, the",
        "captures (.u8 + .toml), frames, wav",
        "MODE PASS rests; hands rest open",
        "(GPIO27 high powers the console)"])
    b_bridge = box(380, 330, 220, 120, "A1", "Arduino UNO, the bridge v1b", [
        "74HC165 holds the byte, 74HCT04",
        "inverts OUT0 into /PL, 74HC595",
        "MODE PASS: the pad's bits",
        "MODE INJECT: SET's byte or AT's",
        "counts latches and clocks; TRIG",
        "at latch n; one L line per latch"])
    b_pad = box(640, 330, 150, 70, "PAD", "original controller", [
        "the hand, in PASS",
        "4021 in the pad"])
    b_hands = box(40, 524, 250, 90, "OK1 K1", "the hands, on the front panel harness", [
        "PC817 across the reset button",
        "relay contact across the power",
        "switch (J3 brown and red), in",
        "parallel with the panel's own"])
    b_con = box(380, 494, 220, 130, "NES", "NES-001, the part", [
        "2A03: CPU core, APU, the DMA",
        "2C02: the picture chip",
        "the glue, the mapper on the cart",
        "the cartridge: the dump's CRC",
        "names it, not the label",
        "reads $4016: latch, eight clocks"])
    b_scope = box(640, 444, 150, 110, "SCOPE", "Rigol DS1054Z", [
        "CH1 TRIG, CH2 latch",
        "CH3 video, CH4 D0",
        "single shot at a",
        "known latch index",
        "12 M points, .u8"])
    b_grab = box(640, 584, 150, 100, "EYE", "Roxio grabber + C-Media", [
        "720 by 480 frames,",
        "the whole run, on",
        "the Pi's clock",
        "audio, the same"])
    b_eyes = box(40, 644, 250, 90, "BRIO", "the board's eyes (three cameras)", [
        "the bench's state, not the picture:",
        "the hole map, the rings, the side",
        "views; tools/eye.py, rig-check.py",
        "frames to captures/ on the workstation"])
    b_reader = box(380, 664, 220, 80, "OSCR", "the cartridge reader", [
        "the dump: iNES file + CRC",
        "the same bytes on both sides",
        "is then a checkable fact"])
    # the driver's two arrows across the band boundary
    flow("cmd", [side(a3, "B", 0.5), (side(a3, "B", 0.5)[0], 276), (165, 276), side(b_head, "T", 0.5)], "the run: script lines", 600, 272)
    flow("rec", [side(b_head, "T", 0.85), (side(b_head, "T", 0.85)[0], 292), (side(a3, "B", 0.85)[0], 292), side(a3, "B", 0.85)],
         "runs/<stamp>/ back to the workstation", 300, 289, "start")
    # the head and the bridge
    flow("cmd", [(290, 362), (380, 362)], "bridge lines", 335, 358)
    flow("rec", [(380, 392), (290, 392)], "L n hh clocks", 335, 403)
    flow("stim", [(640, 350), (600, 350)], "bits", 620, 344)
    flow("stim", [side(b_bridge, "B", 0.3), side(b_con, "T", 0.3)], "D0: the byte", 440, 466, "end")
    flow("cmd", [side(b_con, "T", 0.7), side(b_bridge, "B", 0.7)], "OUT0, CLK x8", 540, 466, "start")
    # the hands
    flow("cmd", [side(b_head, "B", 0.5), side(b_hands, "T", 0.5)], "GPIO17, GPIO27", 172, 511, "start")
    flow("cmd", [side(b_hands, "R", 0.5), side(b_con, "L", 0.6)], "reset, power", 335, 565)
    # the outputs
    flow("sig", [side(b_con, "R", 0.2), side(b_scope, "L", 0.85)], "video", 604, 514, "start")
    flow("cmd", [side(b_bridge, "R", 0.55), (622, side(b_bridge, "R", 0.55)[1]), (622, 460), side(b_scope, "L", 0.15)], "TRIG at n", 626, 442, "start")
    flow("cmd", [side(b_head, "R", 0.55), (335, side(b_head, "R", 0.55)[1]), (335, 472), (612, 472), (612, 499), side(b_scope, "L", 0.5)],
         "ARM, single shot", 400, 484, "start")
    flow("sig", [side(b_con, "R", 0.9), (622, side(b_con, "R", 0.9)[1]), (622, 634), side(b_grab, "L", 0.5)], "video, audio", 596, 640, "end")
    flow("cmd", [side(b_reader, "T", 0.5), side(b_con, "B", 0.5)], "the cartridge, in", 498, 658, "start")
    # the records, around the outside and into the head's left side
    flow("rec", [side(b_scope, "R", 0.5), (796, side(b_scope, "R", 0.5)[1]), (796, 760), (30, 760), (30, 410), side(b_head, "L", 0.5)],
         "records: the scope's .u8, the grabber's frames and wav; the eyes' frames go to the workstation's captures/", 200, 756, "start")
    flow("rec", [side(b_grab, "R", 0.5), (796, side(b_grab, "R", 0.5)[1])], head=False)
    flow("rec", [side(b_eyes, "B", 0.5), (side(b_eyes, "B", 0.5)[0], 760)], head=False)
    flow("rec", [side(b_reader, "R", 0.5), (812, side(b_reader, "R", 0.5)[1]), (812, 365), (840, 365)], "the dump, one CRC", 700, 700)

    # ------------------------------------------------ band C: the model
    sh.zone(820, 300, 760, 560, "THE MODEL")
    sh.note(1020, 800, ["Rust crates: the same bytes and the same",
                        "schedule by latch, at nineteen times real",
                        "time; every rung held to its die."])
    c_rom = box(840, 330, 150, 70, "ROM", "the dump, as a file", [
        "iNES, mapper 66",
        "the reader's CRC"])
    c_knobs = box(1080, 330, 480, 92, "K", "the knobs, externalised (proposed: one file per run)", [
        "alignment cpu_phase ppu_phase (measured 4, 3)   decimal adjust off (2A03)",
        "stack pointer at h=0 (measured)   RDY_RISE_SHIFT (experiment)   reset hold",
        "CrtParams (authored)   differential phase (to fit)   power-on RAM (to fit)",
        "every knob named measured, authored or fitted, with the run that set it"], "new")
    c_con = box(840, 434, 330, 150, "NES", "nes-console: the console as code", [
        "2A03 rung: v6502-micro core (adjust off,",
        "  S seeded) + the APU as measured tables",
        "2C02 fast: dot by dot on a measured schedule",
        "nes-glue: the mainboard, the controller",
        "  (set_pad at latch n), the mapper",
        "Alignment { cpu_phase, ppu_phase }",
        "run_frames, master_half_step, cpu_trace"])
    c_ntsc = box(1210, 434, 350, 150, "CRT", "ntsc-crt: the signal path", [
        "encoder (ntsc-source-nes): dots to",
        "  composite, the burst, the palette phase",
        "decoder: notch and comb, blargg checked",
        "the television's stages: beam, scanlines,",
        "  persistence, mask, geometry (CrtParams)",
        "the same decoder reads the scope's .u8:",
        "  one reader for both sides"])
    c_rec = box(840, 624, 330, 104, "RUN", "the run as files", [
        ".pins .stim: the CPU at its pins, the",
        "  pin contract's own text",
        ".events.json / .overlay: latches, reads,",
        "  PPU writes, mapper writes, NMI edges",
        "L lines, frames (.ppm), sound (f32)"])
    c_orc = box(1210, 624, 350, 104, "ORACLE", "the switch-level chips, held to", [
        "v2a03-sim, v2c02-sim: rung 0 of each die,",
        "  the rungs held to them at build and test",
        "v6502-sim on the RecordedBus: the console's",
        "  record replayed on the 6502 die itself",
        "the pin golden; the Halfshot and Trace pages"])
    c_shell = box(1280, 754, 280, 70, "PLAY", "nes-shell / nes-wasm: the window", [
        "the console in a window and at /nes/play",
        "WebGPU encode and decode; pad by gamepad"])
    flow("cmd", [side(a4, "B", 0.6), (side(a4, "B", 0.6)[0], 286), (1005, 286), side(c_con, "T", 0.5)],
         "the same words: SET and AT become set_pad at latch n", 1012, 296, "start")
    flow("cmd", [side(c_rom, "B", 0.5), side(c_con, "T", 0.23)], "bytes", 908, 420, "end")
    flow("new", [side(c_knobs, "B", 0.1), side(c_con, "T", 0.87)], "knobs", 1135, 431, "start")
    flow("new", [side(c_knobs, "B", 0.65), side(c_ntsc, "T", 0.52)])
    flow("pic", [side(c_con, "R", 0.3), side(c_ntsc, "L", 0.3)], "dots", 1190, 474)
    flow("rec", [side(c_con, "B", 0.5), side(c_rec, "T", 0.5)], "the trace, one line per half-cycle", 1012, 606, "start")
    flow("pic", [side(c_ntsc, "B", 0.15), (side(c_ntsc, "B", 0.15)[0], 600), (side(c_rec, "T", 0.9)[0], 600), side(c_rec, "T", 0.9)],
         "the frame at latch T, decoded", 1270, 614, "start")
    flow("orc", [side(c_rec, "R", 0.73), side(c_orc, "L", 0.73)])
    sh.text(1190, 742, "replayed on rung 0", "fl t-orc", "middle")
    flow("pic", [side(c_ntsc, "R", 0.85), (1570, side(c_ntsc, "R", 0.85)[1]), (1570, side(c_shell, "R", 0.5)[1]), side(c_shell, "R", 0.5)],
         "to the window", 1568, 748, "end")
    flow("orc", [side(c_orc, "B", 0.3), side(c_shell, "T", 0.125)], "a .window of the run", 1322, 746, "start")

    # ------------------------------------------------ band D: the comparators
    sh.zone(20, 876, 1560, 166, "THE COMPARATORS")
    d1 = box(40, 916, 280, 90, "compare-logs.py", "the L lines, part against model", [
        "the first latch at which the byte or",
        "the clock count differs, by index",
        "(B0's eight clocks, B3's replay)"])
    d2 = box(350, 916, 280, 90, "b1-score.py", "the capture at T against the frame at T", [
        "luma, hue, saturation per flat region",
        "through one decoder; the first region",
        "that fails, named (N6's tolerances)"])
    d3 = box(660, 916, 280, 90, "eyes.py, cal.py", "the grabber, the decoder, the model", [
        "three pictures of one moment scored",
        "against each other; the cal cart's",
        "screens name themselves in the strip"])
    d4 = box(970, 916, 280, 90, "replay-recorded", "the record on the die, and bisection", [
        "a run replayed on rung 0, agreeing or",
        "naming the half-cycle; B3 bisects the",
        "trigger index to the first latch apart"])
    d5 = box(1280, 916, 280, 90, "GATE", "green, or a row that differs by name", [
        "MUTATE must go red: a gate that stays",
        "green under sabotage is broken",
        "a finding goes to open-items.md, dated"], "gate")
    # the records bus: what the comparators read, and all they read
    flow("rec", [(30, 760), (30, 900), (40, 900)], head=False)
    flow("rec", [side(c_rec, "B", 0.5), (side(c_rec, "B", 0.5)[0], 900)], head=False)
    flow("rec", [(40, 900), (1120, 900)], "the records: runs/<stamp>/ from the head, and the model's run files; frames ride in them", 580, 896, head=False)
    for d in (d1, d2, d3, d4):
        flow("rec", [(side(d, "T", 0.5)[0], 900), side(d, "T", 0.5)])
    flow("orc", [side(c_orc, "B", 0.086), (side(c_orc, "B", 0.086)[0], side(d4, "T", 0.96)[1])], "rung 0, on the record", 1246, 870, "start")
    # the verdicts: one bus into the gate
    for d in (d1, d2, d3, d4):
        flow("rec", [side(d, "B", 0.5), (side(d, "B", 0.5)[0], 1020)], head=False)
    flow("rec", [(175, 1020), (1420, 1020), side(d5, "B", 0.5)], "each verdict: a row by name, or nothing to report", 700, 1034, head=True)

    # ------------------------------------------------ the legend and the rule
    sh.zone(20, 1054, 1560, 150, "WHAT AN ARROW CARRIES, and the two rules the whole sheet obeys")
    y = 1082
    for k, (c, w, d, what) in FLOWS.items():
        sh.add(f'<path class="f-{k}" d="M40,{y} L120,{y}" marker-end="url(#m-{k})"/>')
        sh.text(132, y + 3.5, what, "pin")
        y += 15
    sh.note(660, 1082, [
        "Rule 1: control flows down from the script and never up out of a comparator. A comparator reads records and",
        "answers with a row; nothing it says reaches the console or the model except through a person editing the script",
        "or a knob, dated, with the run that justified it. Rule 2: a word means the same on both sides, or it names its",
        "side. SET and AT hold on the part and the model alike; ARM and CAPTURE are the head's and the model skips them",
        "by name; set_pad is the model's and the part has no such verb. A word that both sides cannot honour or refuse",
        "by name does not enter the dialect. The regime in docs/exercise.md grows the dialect one word per step.",
    ])
    sh.done(OUT / "exercise-stack.svg")


def sheet_padble_esp32():
    """The BLE build on the part with a radio of its own.

    The C6 devkit the first sheet is drawn around was found dead on
    2026-09-29 (no ROM banner on either socket under any reset), and the
    P4 cannot do BLE (its radio is a hosted C6 that never answers). A
    classic ESP32-WROOM-32 devkit took firmware/pad-ble first try on
    2026-09-30, advertised, and the bench head bonded with it as a
    keyboard. So the BLE build lives here, and the two earlier sheets
    stay where they are, as records.

    EVERY PIN HERE COMES OUT OF tools/esp32_header.py, which read them
    off the owner's photograph of the board on its breadboard and holds
    itself to the counts and the rows in that photograph. Nothing on
    this sheet is typed twice.
    """
    import esp32_header as eh
    og = eh.pad_facts().og_lead_by_pin()

    sh = Sheet(1560, 1060, "pad-ble v1 on a classic ESP32: one pad into a WROOM-32 devkit, as a BLE keyboard",
               "The BLE build, on the part with its own radio. A 30-pin ESP32-WROOM-32 devkit, header read off the board "
               "2026-09-30. NOT the C6 map: GPIO6 is this module's flash and GPIO3 its console, so the pad moves to D25, D26, D27.")

    sh.zone(20, 66, 690, 700, "THE PAD, polled at 3V3 exactly as the bridge polls one")
    j1_h = pad_socket(sh, 150, 100, "J1", "PAD_LATCH", "PAD_CLK", "PAD1_D0",
                      part="original NES pad (MN4021B)",
                      extra="  ".join(f"{k} {og[k]}" for k in sorted(og)) + ", NOT measured")
    pad_note = [
        "The pad side is the P4 sheet's: the same plug, pullup and poll.",
        "Only the three pins it lands on move, because this part gives",
        "no choice (see the controller zone).",
        "",
        "The pad's 4021 is a CMOS part rated 3 to 18 V, so at 3V3 its D0",
        "is 3V3 logic and needs no shifter. MEASURED 2026-09-27: an",
        "original's MN4021B follows its buttons at 3V3 (pad-ble-p4.svg).",
        "Pin 5 is the supply; 6 and 7 carry nothing. RING THE CABLE OUT",
        "UNPLUGGED. A 10 ohm part fitted as the 10k hid it first.",
        "",
        "J1 IS DRAWN AS AN ORIGINAL PAD, in Nintendo's colours, NOT YET",
        "MEASURED: beep each wire to the MN4021B first. A REPLICA's differ,",
        "and RED and YELLOW are different signals on each: wired by the",
        "replica's colours, an original puts its DATA on the GROUND rail.",
        "NO PAD IS WIRED TO THIS BOARD YET. With D27 floating the byte",
        "reads ff, all eight pressed, and the blue LED on D2 is on.",
    ]
    # The line of lead colours under J1's box is drawn at its bottom
    # plus 13; a note from y=110 at 14 px a line has to end above it.
    # MEASURED, not assumed: the first guard here assumed 385 and the
    # note ran two lines into the colours in the render.
    colours_y = 100 + j1_h + 13
    assert 110 + 14 * len(pad_note) <= colours_y - 8, (
        f"the pad note runs into J1's colour line by {110 + 14 * len(pad_note) - (colours_y - 8)} px")
    sh.note(330, 110, pad_note)
    sh.twopin(330, 690, "R1", "10k", "PAD1_D0", "3V3")

    sh.zone(730, 66, 810, 700, "THE CONTROLLER, on its own USB power, labels as the board prints them")
    pins = [(None, eh.PAD_BLE[n][0], n) for n in ("PAD_LATCH", "PAD_CLK", "PAD1_D0")]
    pins += [(None, eh.SPARE["MODE_SW"][0], "NC"), (None, eh.SPARE["LED"][0], "NC"),
             (None, "3V3", "3V3"), (None, "GND", "GND")]
    sh.chip(900, 100, 210, "U1", "ESP32-WROOM-32 devkit", pins,
            [(None, "BLE", "radio"), (None, "micro-USB", "VBUS")],
            extra="30 pins; the labels are the board's own silkscreen; D<n> is GPIO<n>")
    sh.twopin(820, 430, "C1", "100nF", "3V3", "GND")
    ctrl_note = [
        "WHY NOT GPIO2, 3 AND 6. On an ESP32-WROOM-32 GPIO6 to GPIO11",
        "are the module's own flash and never reach the header, and",
        "GPIO3 is U0RXD, the receive side of the CP2102 that is this",
        "board's only console. The C6 map would drive the flash the",
        "program runs from. So: D25 latch, D26 clock, D27 data, ADJACENT",
        "on the EN side, GND four pins below them on the same side, 3V3",
        "the first pin of the other side. The EN side reads, up from",
        "the USB end:",
        "",
        "        " + "  ".join(l[1:] if l.startswith("D") else l for l in eh.EN_SIDE),
        "",
        "D4 (MODE_SW) and D2 (LED) are NC here: the firmware reads one",
        "with a pullup and drives the other. D2 is the devkit's own blue",
        "LED, so the pad-held light needs no wiring on this board.",
        "",
        "ALSO NOT YOURS: TX0 and RX0 (the console), D12 and D15 (strapping",
        "pins the module samples at reset), and D34, D35, VP, VN, which",
        "are input only with no pullup. The header page lists them.",
        "",
        "C1 goes across the breadboard's own 3V3 and GND rails, not the",
        "board's pins, as on every sheet since 2026-09-15.",
    ]
    note_y = 470
    assert note_y + 14 * len(ctrl_note) <= 766, (
        f"the controller note overflows its zone by "
        f"{note_y + 14 * len(ctrl_note) - 766} px: shorten it or move it up")
    sh.note(760, note_y, ctrl_note)

    sh.zone(20, 782, 1520, 262, "WHAT THIS BOARD DOES, MEASURED 2026-09-30 with the bench head as the host")
    rows = [
        ("BLE HID", [
            "ADVERTISES AND BONDS. Boots straight into firmware/pad-ble built for esp32:esp32:esp32 (84% of the app partition), prints the key map and",
            "advertising as NES Pad, and the bench head's own radio lists it. BLEDevice::init does not crash here, unlike the P4. Paired from the head with an",
            "agent registered (a non-interactive bluetoothctl pair fails, no agent for the request), it bonds and the head grows a NES Pad keyboard on uhid.",
            "One connect prints one linked line, one disconnect one unlinked. NOT TESTED: a pad wired to it, a phone. A floating D27 reads ff, all pressed."]),
        ("FORGET", [
            "WORKS ON THIS PART NOW, AND DID NOT. The sketch cleared bonds only under NimBLE; this core is Bluedroid, so FORGET printed rc -1 and cleared",
            "nothing while a reflash blanked the bond store anyway: the one-sided bond with no way out. It lists and removes the bonds one by one now, measured",
            "both ways: board blank and head bonded, the head connects and gets nothing (bluetoothd's unlikely error lines are the only tell); FORGET with one",
            "bond stored answers 1 bond(s) were stored here, rc 0, and the head's next connect drops until it removes its side and pairs again."]),
        ("Flashing", [
            "Through the CP2102 at /dev/ttyUSB0 on the bench head, esptool's default reset, the merged image at 0x0 at 921600. The board arrived running an AT",
            "firmware (an at_customize partition, version line 2.4.0). Its ROM banner appears only when the reset is driven through RTS, not DTR alone."]),
        ("Serial", [
            "Unlike the P4 over USB, this board's Serial IS the CP2102, so the B xx lines and STATUS, KEYS and FORGET are readable on the bench head at 115200."]),
        ("Two players", [
            "Not on this sheet. A keyboard report carries six key slots and two pads can ask for ten, so a second pad could be polled and never sent."]),
    ]
    y = 812
    for label, lines in rows:
        sh.text(40, y, label, "pin")
        for l in lines:
            sh.text(168, y, l, "pin")
            y += 13
        y += 3
    assert y <= 1044, f"the capability band overflows its zone by {y - 1044} px: shorten it or grow the zone"
    sh.done(OUT / "pad-ble-esp32.svg")


OUT = Path(sys.argv[1] if len(sys.argv) > 1 else ".")

# The page a laid sheet is drawn to fit. Asked of the frame rather than
# typed here: the title block's height is part of this number.
sys.path.insert(0, str(Path(__file__).resolve().parent))
import sheetframe as _sf  # noqa: E402
LETTER = _sf.drawing_box("ansi-a")

if __name__ == "__main__":
    OUT.mkdir(parents=True, exist_ok=True)
    sheet_v1()
    sheet_v1b()
    sheet_v1b_head()
    sheet_v1c()
    sheet_v2()
    sheet_v2b()
    sheet_logic()
    sheet_pad()
    sheet_padble()
    sheet_padble_p4()
    sheet_padble_esp32()
    sheet_exercise()
