tinymachines/nes-bench/tools/cal.py

#!/usr/bin/env python3
"""The calibration cartridge's reader: one tool for every eye
(calibration-plan.md, C1). Every frame of the cartridge names itself in
a strip of blocks; this reads the strip off whatever picture it is
given, by the manifest's rectangles, and scores the screen's regions
against the model's own picture of the same screen and variant through
the same decode.

  python3 tools/cal.py model    roms/cal.nes [--frames 40]
        the model's frame offset: how many frames from power-on the
        console runs before the strip's counter reads c (so a record
        whose strip says c is the model at frame c + offset)
  python3 tools/cal.py grab     roms/cal.nes captures/pi/.../x_screen.jpg [...]
        grabber frames: find the console's pixel grid in the 720 x 480
        picture from the strip's own structure, read the strip, refuse a
        frame that does not read, and score every flat region of the
        screen against the model (luma, hue, saturation on the grid)
  python3 tools/cal.py scope    roms/cal.nes record.u8 <rate_hz>
        a scope record: decode it (ntsc-crt's recover-real --nes), read
        the strip off the decoded picture, run the model to the same
        frame, and score the regions through nes-console's capture-score
        at that frame (the N6 path and tolerances)
  python3 tools/cal.py selftest roms/cal.nes
        the tool on synthetic input: the model's decoded pictures read by
        the same reader that will read the part's, and the same pictures
        re-sampled to the grabber's geometry with an unknown offset and
        JPEG-compressed, found and read again. MUTATE=1 reads half a
        block off and must go red.

The manifest (`cal.json` beside the ROM) is the only source of where
anything is: a rectangle typed here would drift from the cartridge. The
grabber's sample geometry and the colour figures are `eyes.py`'s, loaded
from it, for the same reason. Siblings: `../nes` (built with --release:
run-rom, cal-screens, capture-score) and `../ntsc-crt` (recover-real).
"""
import argparse
import json
import os
import subprocess
import sys
from pathlib import Path

import numpy as np
from PIL import Image, ImageDraw
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
