tinymachines/nes-bench/(commit log)

2026-09-07 The bench plan: the part and the model under identical inputs, B0 to B3 with their gates, and the wiring to build from
2026-09-07 B0, the machine side: the bridge firmware, the host tools, and the report
    The die answered the DMC question first (2a03's joy-clock-probe): the
    re-run pulses /OE1 again, the halt cycles do not, and a sample address
    with the port's low five bits keeps it low. The model changed for it in
    three repositories, each with a red mutation. The firmware compiles for
    a generic ESP32; nothing has touched the part.
2026-09-07 Wiring revised against the gear shots: the C6's pins, the console's harness header, the board's parts
    The bench's microcontroller is an ESP32-C6-DevKitC-1 (fourteen usable
    pins, the D0 monitor dropped, the firmware carries both maps and
    compiles for esp32c6 and esp32). The console is open, an NES-CPU-10:
    the controller harness reaches a board header, so nothing is cut; the
    port buffers are TC40H368P with 5.6 K pullups; the sound stage's R6,
    R7, R8, C20, C21 and C23 read as the model has them. The reset switch
    is a PC817 module used open-collector.
2026-09-07 The pad's socket is the console's own port housing, its harness moved to the bridge
2026-09-07 The bench as one drawing, derived from the wiring tables
    tools/draw-bench.py reads the pin tables in docs/wiring.md and writes
    docs/bench.svg: the loop above, the bridge's chips with every pin below,
    light and dark through prefers-color-scheme with literal colours (rsvg
    renders CSS variables as black). --check refuses a stale drawing.
2026-09-07 The head: the bench under one script, run against a fake bridge
    headd.py on the Pi: UDP requests, the bridge over serial, the relays on
    gpiozero, the scope in scope-capture's dialect with an EXT TRIG single
    shot, runs served over HTTP; bench.py the client; fake-bridge.py the
    protocol with no part behind it; docs/script.md the words, shared with
    the model's pad-log. The fetched log and the model's agree latch for
    latch on one script. The scope's arm is untested, the scope being off
    the LAN; the relays have no Pi wired.
2026-09-07 The B1 tool: a run's capture against the model's frame at the same poll, the trigger's sample from the scope's preamble
2026-09-07 The B2 classifier: the alignment class off three channels, the sweep, and a fake scope for the head
    The class is the offset from an ALE rise to the next M2 fall in master
    half-steps mod 8, on the dies' word that M2 falls with clk0 and ALE
    rises with pclk0. selftest reads back 72 synthesised alignments and the
    ALE-shifted mutation moves all 24; a B2 script played three times
    through the head against fake-scope.py classifies as the alignment the
    fake was given. ARM takes channels, a trigger source, a timebase and a
    depth; the head waits for a scope that comes up late.
2026-09-07 B3: record, replay, agree and bisect, with a fake scope that serves the model's frames and a plantable divergence
    A planted divergence at latch 200 is found at 200 in eleven replays; two
    replays agree with each other where both disagree with the model. The
    head's CAPTURE accepts a record already read during the wait, its HTTP
    side reuses its port and is fatal if it cannot bind, its scope reads
    wait longer; the arm goes before the trigger in a replay's script.
2026-09-07 The electronics review's sheets taken in: v1 and v2 schematics, timing lanes, the pad adapter, the build order
    Four SVGs and a build document from the review, embedded and held to
    this repository by check-sheets.py (every C6 pin on the v1 sheet against
    the wiring tables, the committed SVGs against the generator). The
    timing sheet's one v1 firmware finding is in bridge.ino: the register's
    eight inputs written in one store, only while OUT0 reads low before and
    after, the counters read before the write, and MUTATE ON as B0's
    scripted mutation. v2 and the adapter are in the plan as what comes
    after the four milestones.
2026-09-08 The scope's capture path, proven on the instrument: the offset sign was right
    The DS1054Z moved networks and was missing for a day, which was an
    Ethernet cable that was not seated. With it back, head/headd.py's Scope
    class met a real instrument for the first time, driven as itself rather
    than transcribed: connect and identify, the setup saved at 2,085 bytes
    and restored as found, arm at B1's parameters including the
    memory-depth-only-takes-while-running workaround, the single shot to
    WAIT and then STOP, and the chunked raw read of 12 million points in
    27.9 seconds.
    The arm docstring said the horizontal offset's sign was not trusted and
    to flip it if the first real capture put the trigger la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
    [headd.py]
2026-09-08 The report and the build document speak the reader's language
    The roof's house style, applied where these pages are served from:
    gates are checks, mutations are sabotage runs, rungs are the fast core
    and the fast chip, and the public site's boarding is described as what
    it does (runs both again before publishing). The 74HCT04's gates keep
    their name; those are gates.
    Claude-Session: https://claude.ai/code/session_01XvNQ4jND5ZwCPqwHnARjy5
2026-09-08 v1b: the bridge on an Arduino UNO, all at 5 V, with firmware that fits the part
    The parts arrived and one of them chose the build order. The 74HC family
    needs a 3.5 V high at 5 V and the ESP32-C6 gives 3.3 V, so v1 as drawn
    cannot be built from the kit on the shelf. The ATmega328P is a 5 V part,
    so putting an UNO in the middle collapses three voltage domains into
    one: no 74LVC245, no up-shifter into the register, and the pad polled at
    the 5 V it was built for. v1b is now the first build; v1 stays as the C6
    version for when v2's four counters need it.
    Taken in whole from the review: docs/bench-v1b.svg, docs/bench-v1b-uno.md,
    and the generator that draws them, which regenerates the four exist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
2026-09-08 Bring-up: the wiring walked one step at a time, and a lab notebook it writes
    The parts are on the desk, so the next thing is wiring, which is where a
    bench either becomes an instrument or becomes a week of plausible wrong
    answers. tools/bringup.py is the procedure: fourteen steps in v1b's
    build order, each printing what to wire, waiting, then CHECKING
    something. It never asks whether a step worked. It measures with the
    scope, reads the bridge's own log, or takes a meter reading and holds it
    to a range.
    Two steps retire authored numbers. 2.1 puts the scope on an original
    pad's port while a game runs and measures the latch width, the clock
    width, the interval between clocks and the polls per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
    [bringup.py, lab-notebook.py]
2026-09-08 Five sittings instead of fourteen prompts: a build guide, generated
    Fourteen steps was the right number of measurements and the wrong number
    of interruptions. Three changes, all in the direction of doing more per
    command and asking for less.
    --session N runs one whole sitting: instruments, then the console
    measured, then the bridge built in two halves, then the halves joined,
    then the head's hands. The steps inside a sitting share a setup, so
    splitting them across invocations only meant wiring the same thing
    twice.
    Photographs no longer stop the run for a keystroke. They are named as
    they come up and listed again at the end, and the notebook embeds one
    when the file arrives and says it is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
    [bringup.py, build-guide.py]
2026-09-08 Home base: the Pi holds the Uno, the workstation reaches it, sitting 1 holds
    The bench has a Raspberry Pi with the Arduino plugged into it.
    head/serial-bridge.py puts that serial port on the LAN, standard library
    only and nothing installed on the Pi, because that machine resolves DNS
    through DNSCrypt resolvers on another subnet and from the bench network
    can reach neither apt nor GitHub. That is a deliberate part of its setup,
    so the tooling goes to the port rather than the other way round.
    One TCP port serves both jobs: pyserial understands socket:// with no
    extra code, and avrdude 8 takes net:. So the firmware compiles on the
    workstation and flashes across the network, verified at 7,996 b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
    [bridge-uno.ino, bringup.py, serial-bridge.py]
2026-09-08 The port's colour map, memorialised from the connector's own moulded numbers
    Two photographs of the controller port housing, both rows, with the pin
    numbers moulded into the plastic beside the crimp terminals. Read off
    them:
    1 GND brown, 2 CLK red, 3 OUT0 orange, 4 D0 yellow,
    5 D3 white, 6 D4 blue, 7 +5V purple
    That is better evidence than a colour convention, and it is a different
    method from ringing it out, so the step now records WHICH was used
    rather than claiming continuity it did not have. "meter" is the harness
    proven from the board header to the socket, "moulded" is the connector
    telling you its own numbering, and "both" is the strongest. A moulded
    answer carries its own caveat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
2026-09-08 Procedures: one working document per cycle, and the console is off
    A cycle is one round of something to do at the bench, something the
    tools measure, and whatever the bench says back that no tool can see.
    docs/procedures/ holds one document per cycle, read on GitHub away from
    the terminal, edited as the cycle goes.
    The other three documents cannot do this job. The build guide is the
    map, generated. The lab notebook is the record, generated from the log,
    and holds only what a tool measured. Procedures are the working
    documents in between, and they are the first place in this repository
    where the operator's own observations have somewhere to go: a connector
    that would not seat, a probe that k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
2026-09-09 The bench as it now stands: two breakouts, the board out of its shell, probes loose
    Two photographs into docs/lab/. The board is out of the case with Super
    Mario Bros running, the Pi and the Uno are on the breadboard, and there
    are two new breakouts: controller port 1, and the power and reset
    switches.
    The procedure for sitting 2 is rewritten around that. Probing inside a
    controller socket is fiddly and a slipped tip shorts two pins; a
    breakout is a row of holes a probe can clip to and stay in, so both the
    probing and the four meter readings move to the breadboard.
    What it cannot yet say is which wire is which. Both breakout headers
    carry red, cyan, blue and yellow, which are new leads and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
2026-09-09 Two of the breakout's seven leads are the same yellow, and one is ground
    The controller port's breakout map arrived as two notebook pages, so it
    goes into the record as the pages plus a table, not as a retyping.
    Three findings, in the order they matter at the bench:
    - Pins 1 and 2, GND and CLK, are both yellow. Those are exactly the two
    leads a probe's ground clip and its tip are about to land on, and a
    ground clip on CLK shorts the line every time the console drives it
    high. A continuity check from the board header's brown now runs before
    any probe, and it does the job wiring.md's measure-first item 1 asked
    for: step 1.1 read the housing's own moulded numbers, which say nothing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
2026-09-09 Step 1.1 maps the breakout too, and refuses two leads of one colour
    The harness map stopped at the harness. What a probe lands on is the
    breakout spliced onto it, whose leads are new wire in whatever colours
    were to hand and carry no convention at all, so a map of the harness is
    a map of something nobody touches.
    1.1 now asks for the breakout's lead at each pin as a second column, and
    three things fall out of it:
    - Two leads the same colour is refused when the method was "moulded".
    The housing's numbers say nothing about a breakout, and the two leads
    a shared colour hides are the ones a probe's ground clip and its tip
    land on; a clip on a driven line grounds it. Only a meter separate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
2026-09-09 Step 3.1 takes its 5 V from the UNO, which is what the v1b sheet says
    The instruction read "74HC04 pin 14 to port +5V". That is v1 text, from
    when an ESP32 sat in the middle and the console's own supply ran the
    5 V half. v1b is one 5 V domain and its sheet says so across the top:
    the UNO's own 5 V pin, fed by its USB from the Pi. The console shares
    ground and nothing else.
    The bench forced the question. The breakout does not bring pin 7 out, so
    the step as written was not buildable, and the reason it was not
    buildable is that it was describing the wrong bridge.
    Claude-Session: https://claude.ai/code/session_01Ri45RiYMRkHfNA3Debd9R4
    [bringup.py]
2026-09-09 Ground on the breakout is rung out and marked, and the colours disagree
    The meter beeped from the NES harness's brown at the board header to a
    yellow lead on the breakout. That lead is port pin 1, and it is marked
    on the board. It is the first hole on that breadboard tied to a numbered
    pin on the console through a wire somebody actually rang out, and it is
    where the scope's ground clips go.
    It also turned up a conflict. The notebook page has the breakout's five
    leads as yellow, yellow, black, green, red. The photograph of the header
    shows red, teal, blue, yellow and a dark fifth. Those are not the same
    loom, and which one is right decides where CH2 lands.
    The procedure does not try to sett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
2026-09-09 Five of the two harnesses' seven colours are the same, so brown is not enough
    Sitting 2 is the controller port throughout, and the power and reset
    breakout is sitting 5. The procedure never said so, and the bench makes
    that easy to get wrong in two ways at once.
    The controller harness is brown, red, orange, yellow, white, blue,
    purple. The power and reset harness is brown, red, orange, yellow,
    white. Five colours are shared, so touching "brown" does not say which
    connector you are on. Only blue and purple are unique to the controller.
    And the two breakouts are indistinguishable at the breadboard: both are
    a white five way header in black heat shrink showing the same lead
    colours, so the he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
2026-09-09 The bridge sits in a cut controller cable, not a tap on the console
    The operator's answer, and it corrects a guess this document made an
    hour ago. The two white headers in black heat shrink are one controller
    cable cut in half and broken out at both ends, which is why they look
    identical: they are the same five conductors. The third, standalone
    connector is the power and reset breakout. There was never a second
    harness to confuse the first with, so the warning about shared colours
    is gone.
    That is a better bench than the one wiring.md drew. The sheet taps the
    console's own port harness at the board header for J1 and borrows the
    second port housing for the pad at J2. One cut cable gives both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
2026-09-09 Pins 6 and 7 carry nothing, and pin 5 is the supply under another name
    Four of the seven are rung out and every one agrees with the notebook
    page: pin 1 to yellow, pin 5 to red, pins 6 and 7 to nothing at all.
    Which breaks the published function table on this board. A pad runs a
    4021 and a 4021 needs a supply, so a five conductor controller cable
    carries GND, CLK, OUT0, D0 and +5 V. This one carries pin 5, which the
    published table calls D3 and which a pad has no use for, and does not
    carry pin 7, which the published table calls the supply. Step 1.1 has
    said since it was written that wiring.md's port table is a published
    pinout until this step confirms it on THIS board. This is that moment.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
2026-09-09 Ring a cable out of circuit, or the console tones it for you
    The cut cable is fully mapped: pin 1 yellow, 2 blue, 3 black, 4 green,
    5 red, and pins 6 and 7 carrying nothing.
    The two yellows never existed. The first pass was rung with the cable
    still plugged into the NES, so the tone went through the console's own
    pull-ups and port buffers and pins that share nothing beeped. It was
    repeatable, which is what made it convincing. Same family as a stale
    server holding the port and a /usr/bin/node that is v12: the reading was
    of the wrong circuit and perfectly reproducible. The warning now lives
    in step 1.1's own instructions and in wiring.md's measure-first list,
    where it will be read before the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
    [bringup.py]
2026-09-10 Step 2.1 holds, and the port's timing turns out to be the game's
    Two records twenty minutes apart, 12 million points a channel at
    50 MS/s. Both steady inside themselves and disagreeing with each other:
    latch high 4.44 us against 3.32, between clocks 15.64 against 10.62.
    Run B's latch measured 3.32 us on fifteen consecutive polls and its 105
    clock gaps ran 10.60 to 10.62. Neither is noise and neither is wrong.
    Divided by the 2A03's 0.5587 us cycle they are 8 and 6 cycles of latch,
    1 cycle of clock low, and 28 and 19 cycles between clocks. Every one
    lands on a whole cycle and the two clock periods land to better than
    half a part in a thousand, with nothing fitted: the cycle count comes
    from t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
    [bringup.py, check-bringup.py]
2026-09-10 The gamepad was not the variable, and the step now writes down the screen
    A third record with the pad unplugged: latch 3.32 us, between clocks
    10.62 us, 60.0997 polls per second, eight clocks on all fourteen
    intervals. Identical to the record taken with the pad in, to one sample
    at 50 MS/s. The obvious guess about what changed between the first two
    records is dead, which is worth as much as confirming it would have
    been. A pad only answers on D0 and this step does not look at D0.
    Two independent captures agreeing to the sample also settle that the
    measurement repeats, which is what makes the first record's 8 cycle
    latch and 28 cycle read loop worth taking seriously rather than
    explaining aw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
2026-09-10 Step 1.2 asked for pin 7, which on this board carries nothing
    The published NES pinout puts the supply on pin 7, so the step's one
    hard guard refused anything where pin 7 was not near 5 V. Step 1.1 rang
    this console's connector out: the supply is on pin 5 and pin 7 carries
    nothing at all. The guard could only ever have failed here, and it would
    have failed on a bench that was entirely correct.
    So the four readings are named by what they ARE, the operator says which
    lead each came off, and the step records which instrument was used. A
    skipped reading is now named in the summary, because a summary that
    reads the same whether or not a line was measured is how a half finished
    step becomes a fin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
    [bringup.py, check-bringup.py, lab-notebook.py]
2026-09-10 U1 is an HCT04, and v2b is on the sheets: merged, not copied
    The 2026-09-09 hardware set brings three things and would have taken two
    away, so it is merged rather than applied.
    Taken:
    - U1 becomes an SN74HCT04N everywhere. HCT's input threshold is 2.0 V
    against HC's 3.5 V, which is what makes it safe on the 2A03's NMOS
    OUT0, and the "LS04 until measured" hedge goes with it.
    - The C6 sheets' 3.3 V to 5 V path to the 595s is two HCT04 gates per
    line instead of an LS245 with pullups. No 245 and no pullups remain
    anywhere in the set.
    - bench-v2b.svg, the UNO version of v2: two 165/595 pairs on one SPI
    chain, an LM1881 at 5 V straight into the UNO, every count on the UNO
    with Timer1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
2026-09-10 Sitting 3 names the marked leads, and stops sending the pad to pin 7
    Step 4.2 said to take the pad's supply from port pin 7. On this console
    pin 7 carries nothing and the cut cable's supply is on pin 5, which step
    1.1 rang out and step 1.2 confirmed at 5.000 V. Wiring 4.2 as written
    would have left the pad's 4021 unpowered and the step would have failed
    for a reason nothing in it named.
    It also still described the pad side as the console's spare port
    housing. It is the pad half of the cut controller cable now, the half
    that does not beep to the board header, and the bridge drives it while
    the console drives the other.
    Both steps now name the leads by the colours that are marked on them:
    ye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
    [bringup.py]
2026-09-10 The parts list is generated from the file that draws the schematics
    A bill of materials typed into prose drifts from the drawing the first
    time somebody edits one and not the other, and the reader has no way to
    tell which is lying. So tools/parts.py imports draw-schematics.py,
    records what each sheet asks Sheet.chip and Sheet.twopin to draw, and
    writes docs/parts.md from that. A part cannot be on a sheet and missing
    from the list, and it cannot be renamed on a sheet without the list
    following.
    One column is authored and the document says so: status, because no
    drawing knows what is in a drawer. It lives in one table in the tool,
    and a part with no entry renders as "unlisted" with a line say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
    [parts.py]
2026-09-10 The sheets as PNGs, rendered on demand and never committed
    For reading offline on a phone. tools/render-png.py takes the committed
    SVGs and renders them with librsvg, falling back to inkscape and then to
    headless chromium, and says which one it used.
    The PNGs are not committed and will not be. A PNG is a photograph of a
    drawing: nothing can check that a committed one still matches the sheet
    beside it, and PNG bytes are not reproducible across renderer versions,
    so there is no honest currency check to write. The SVG is the artefact,
    check-sheets.py holds it to the wiring tables, and the photograph is
    made from it on demand.
    ImageMagick's convert is deliberately not in the fallback list. Wit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
2026-09-10 The schematics were already a netlist, and now there is a drawing package
    Two tools and a plan.
    tools/netlist.py reads the netlist back out of the sheets. draw-
    schematics.py has always drawn every pin as (number, name, net) and
    nothing had ever read it: v1b alone is 8 references, 67 pins and 24
    nets. That one fact is what makes both a wiring list and, eventually, a
    fabricated board reachable from these drawings rather than from a
    rewrite in another tool.
    It also runs an electrical rule check, and the check earns its place
    immediately: 19 errors across five sheets. Some are my rules being naive
    about cables and radio links, which are not copper and want an off-sheet
    symbol. The rest are re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
    [make-package.py, netlist.py, sheetframe.py]
2026-09-10 M2: the schematics now say what this console actually is
    Nineteen ERC errors down to zero across five sheets, and the check is a
    deploy gate.
    The one that mattered: every sheet drew the controller port with D3 on
    pin 5, D4 on pin 6 and the supply on pin 7, which is the published
    pinout and is not this console. Steps 1.1 and 1.2 rang it out and
    measured it: the supply is on pin 5 and pins 6 and 7 carry nothing. The
    connector symbol says so now, with the date on it, and the pad socket
    too, since the pad end is the same cut cable.
    That error is invisible to a connectivity check. A connector with the
    right nets on the wrong pins is perfectly wired and perfectly wrong, and
    a mutation putting th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
    [bringup.py, build-guide.py, check-bringup.py, check-sheets.py, draw-schematics.py, lab-notebook.py, loadmod.py, make-package.py]
2026-09-10 M3: the breadboard picture, placement authored and every wire derived
    A schematic says what connects. It does not say where to put anything,
    and "where" is the whole problem the first time you hold a breadboard.
    tools/breadboard.py draws the board, seats the three packages, and then
    reads every connection out of the schematic through tools/netlist.py:
    21 numbered jumpers and 16 short wires to the rails on v1b. The
    placement is authored and is one table at the top of that file. The
    wires are not authored at all, which is the point: moving U2's QH to a
    different net in the schematic changes the picture, and that is how the
    claim is tested rather than asserted.
    Three things it taught, all of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
    [breadboard.py, check-sheets.py, render-png.py]
2026-09-10 M4: the netlist out, and two things it refused to paper over
    tools/export-netlist.py writes a KiCad netlist, a Protel netlist and a
    BOM per sheet, into docs/fab/. v1b is 10 components and 21 routable
    nets; v2b is 21 and 39. Neither needs KiCad installed to produce, which
    is the point of doing this step before M5.
    The connections are derived from the schematic. The footprints are not,
    and the tool says so: a 100 nF capacitor is a dozen packages and only
    the person with the drawer knows which. FOOTPRINTS is authored, --check
    fails on a part that has not been given one, and the deploy runs that
    check so a new part cannot ship as an empty field.
    Two things it would have been easy to paper over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
    [export-netlist.py]
2026-09-10 M5: v2b placed, netted and poured, and honestly not routed
    Your two decisions, applied. v2b is the board, and A1 is a cable rather
    than a shield.
    The cable decision has a consequence worth stating: sixteen signals fit
    a 16 way header exactly, and that would carry SCK and two console clocks
    with a single ground for the whole ribbon. A 20 way part costs the same,
    so the four spare pads are grounds and they sit beside the fastest
    edges. A1_HEADER in export-netlist.py is that pinout, and net_pads()
    puts all five ground pads on GND, because connecting only the one the
    schematic draws would have quietly undone the reason for the bigger
    part.
    KiCad 6.0.2 is installed here now. tools/make-pcb.py d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
2026-09-10 The page decides how big a drawing may be, and refuses one it cannot print
    The package was ANSI B because the drawings happened to be. On the
    letter paper that is actually in the house, bench-v1b.svg placed at 63%,
    which puts a 9.5 px pin name on paper at 4.5 pt.
    Three changes. The page now answers how much room a drawing has
    (sheetframe.drawing_box), and the title block is proportioned to the
    paper rather than being a fifth of an ANSI B sheet on all of them.
    Schematic coordinates are derived: a sheet body says which band, column
    and row a part sits in and nothing else, the body is drawn twice, and
    columns come out as wide as their widest part including its net flags.
    And place_svg, the one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
2026-09-10 Sheet 2 keeps the head, the relays and the scope
    The split dropped v1b's head-and-relays band, which is where the reset
    opto, the relay contact in the AC lead, the one-ground rule and the
    scope's inputs are written down. It is back as its own band on the
    bridge-side sheet, two columns rather than six lines, and the sheet
    still places at 84% on letter.
    [draw-schematics.py]
2026-09-10 v2b is four letter sheets and a package of its own
    M6's gate said v2b would print at 3.3 pt on any paper in this house and
    put it out of the v1b package. This is the split it asked for:
    TM-NESB-002, nine pages, port 1, port 2, the UNO with both output
    registers on one SPI chain, and the LM1881 with both pads and the
    trigger. The four sheets place at 83, 92, 79 and 92 percent.
    Three columns is the letter limit and it is arithmetic: a DIP with net
    flags on both sides wants about 310 units, letter gives 952, and two
    rows of tall parts is 650 against 542. The split follows the circuit,
    so port 1 and port 2 get a sheet each even though port 2's has room to
    spare. The rule check still collects al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
2026-09-10 The v2b board is routed, and the routing is a file
    506 track segments, 7 vias, 0 unconnected items and 0 clearance
    violations at 200 um. Two layers, 250 um track, ground poured on the
    back and supply on the front and both also carried as traces.
    The routing is recorded in docs/routing/bench-v2b.ses and applied on
    every build by tools/session.py, the same argument as a golden file: the
    output of a long search, checkable against the thing it describes, and
    worth nothing to re-derive per build. A fresh clone gets a routed board
    and no build needs Java. tools/route-pcb.py is what makes a new one; it
    finds freerouting through $FREEROUTING_JAR or ~/.cache and says how to
    fetch one. The session fi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
    [make-pcb.py, route-pcb.py, session.py]
2026-09-10 There were no silkscreen overlaps: the check was reading the wrong layer
    This repository has carried "four pairs of parts have overlapping
    silkscreen text" as a known defect since the board was placed. They do
    not overlap and never did.
    The check compared each footprint's whole bounding box, and a
    footprint's box includes the Value field. These libraries put Value on
    F.Fab, which is not a silkscreen, is not plotted, and is not in the
    fabrication set at all. J2's value is the string "original pad, on the
    bridge": 21 mm of text on a 3.6 mm connector. Four of those, four
    "overlaps", none of which anything will ever print.
    The check now reads the two silk layers and nothing else, item by item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
    [make-pcb.py]
2026-09-10 The v2b sheets are in the document, and the position file is valid CSV
    bench-v1b-uno.md named the four v2b sheets in prose and showed none of
    them, so the site served the files and nobody saw them. All four are
    embedded in the v2b section now, with a line saying the board for them
    is routed and where the fabrication set's own account of itself is.
    The position file was not CSV. J2's value is the string "original pad,
    on the bridge", written unquoted, which shifted every column after it by
    one for anything reading the file with a CSV reader. Fields with a comma
    are quoted now.
    docs/procedures/2026-09-11-order-the-v2b-board.md is the docket entry
    for ordering it: what to regenerate first, wh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
2026-09-10 Under any MUTATE flag, exit 0 means the check caught it
    The three board mutations disagreed about what success looks like:
    MUTATE and MUTATE_OPEN refuse the board and so exited 1, MUTATE_SILK
    only writes a note and so exited 0, and nothing scripting the three
    could tell a proof from a pass. A mutation run is not asking whether the
    board is good, it is asking whether the check can tell, so all three
    print a verdict line and exit 0 when caught. Not catching still raises.
2026-09-10 The cart reader runs V15.6 and answers on serial
    It was silent at every baud rate because the firmware had no serial
    command interface, not because anything was wrong. Three read-only
    measurements found that: the Mega 2560's bootloader answered a stk500v2
    sign-on with AVRISP_2, so the board and the CH340 path were fine; its
    flash held "OSCR HW5"; and its flash did not hold VERCHK, GETCLOCK or
    ETVOLTS, which are plain literals that would be in the image if the code
    had them. That matches V12.1, which predates the interface.
    Built V15.6 from the clone already in 6502/extern/cartreader, master at
    060d8ae, with HW5 and nothing else changed, so firmware and databases
    come from one commit and are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
2026-09-10 The Pi lends the bench four pins, so four jumpers and no breakout; no ground wire to the console
    The reset opto and the power relay were chosen so the Pi never needs a
    ground reference to the console. Its ground reaches the console through
    the UNO's USB cable and the bridge, and that is the only path there
    should be: a third wire would close a loop and discard the isolation.
    Claude-Session: https://claude.ai/code/session_01271K67fxXLh4K6z5pYYjPA
2026-09-10 A cheat sheet: the breakouts pin by pin and every pin of every chip, and the console's 5 V comes off the UNO sheets
    tools/cheatsheet.py joins the schematic's pins and nets, the lab log's
    harness colours (step 1.1) and the bring-up tool's lead table into
    docs/cheat-sheet.md and four sheets of the v1b package: the controller
    port as pin, signal, NES harness, breakout lead and where the lead goes;
    the power and reset breakout; the head's four jumpers with header
    positions; and one sheet per chip (U1 74HCT04, U2 74HC165, U3 74HC595)
    with every pin's datasheet purpose beside what it is wired to here. The
    purposes are the one authored thing and are refused if the schematic
    names a pin differently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
    [bringup.py, cheatsheet.py, check-sheets.py, draw-schematics.py, make-package.py, sheetframe.py]
2026-09-11 The wiring as a diagram to build from: packages as they sit, every wire at right angles
    tools/wiring-diagram.py draws docs/wiring-v1b.svg from the same netlist
    as the wiring list: each chip its DIP package from above (notch left,
    pin 1 bottom left, names running up inside the body), one track and one
    colour per net in a channel above or below the row, a net on both edges
    crossing through a gap on its own column, rails along the top and
    bottom, a dot for a junction and nothing for a crossing. It asserts both
    directions: every wired pin drawn, every drawn pin on the schematic. It
    is sheet 4 of the v1b package; the breadboard sheet follows it for the
    holes, and check-sheets regenerates it with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
2026-09-11 The board as built, read off its photographs: placement and notch direction into the breadboard tool, the UNO ribbon into the tables, and the reading written down
    tools/breadboard.py now carries the real placement (U1 at 9, U2 at 17,
    U3 at 26, notches toward the high columns) and a hole rule for either
    notch direction, asserted both ways, so the breadboard sheet's numbered
    jumper list names the holes on the board that exists. RIBBON joins
    LEADS in bringup.py and the cheat sheet renders it beside the breakouts;
    the pin-map sheet paginates when its tables outgrow a letter page.
    docs/as-built-v1b.md is the reading itself: which block, which half,
    how the columns were counted, the rails, and whe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
2026-09-12 Eyes versus scope: one tool captures the grabber and the scope together and scores the two pictures; the grabber's missing lines were the driver answering QUERYSTD with every standard
    tools/eyes.py pair sets the scope up as ntsc-crt's capture does, takes
    eight grabber frames through ffmpeg, stops the scope the moment they
    are in, and writes both under captures/. compare decodes the record
    with recover-real --nes, aligns the grabber's first field to the
    console grid by correlation, and reports flat-block agreement, hue on
    saturated pixels and the worst blocks by console coordinates. First
    synchronized pair: hue within two degrees, saturation within five
    percent, the sky fifteen lower in red a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
    [eyes.py]
2026-09-12 Plan: the reader's card on the Pi, the label, the mount, the tool and its refusals
2026-09-12 Plan: the closed cycle, the cartridge to the first disagreeing frame, over what is built today
2026-09-12 The reader's card refreshed from the Pi: labelled OSCR, the udev mount exercised both ways, the 45 files read back identical
2026-09-12 C0: the cartridge in the model, three pictures of one title, and the model twelve degrees off both eyes in hue
    eyes.py compare --model renders the console on a ROM through the same
    decoder chain and scores it against the decoder's and the grabber's
    frames. On the title screen the two eyes agree to 0.7 degrees; the
    model is 12.6 and 14.1 degrees away on the same saturated colours.
2026-09-12 The cartridge experiment as a notebook page: the reader, the verified dump, and the mapper-66 board the model grew
2026-09-12 Plan: the trace from the pad to the picture, a console run in the 6502 stack's forms, with a recorded bus so the die runs the console's program
2026-09-12 T0 done: the console run as three files, and the tile its first cartridge trace found
    The trace plan records T0 as built (nes @ 8eb30ee) with its gates as
    run and the one change from the plan (no window by latch: the pin
    format starts at h=0, so a window is T2's LOAD door). The cartridge
    page gains the first trace's finding: one wrong tile on the title
    screen, walked through the pins to a page-crossing read that never
    happened, a stale index register in the 6502's fast rung, fixed there
    (6df896a) after a first version of the fix that this same trace
    refuted. Open items: the whole-run size, the pins to bump, and the
    recorder context that would make the fix measured rather than
    authored.
    Co-A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
2026-09-12 The trace plan names the commits T0 landed in
2026-09-12 T1 done: the die runs the console's program, and what it found
2026-09-12 T1's three findings, closed: the branch poll, the DMA's stale page, and RDY as the core sees it
2026-09-13 Where the hue lives: the part's output under the eyes' load, not the decoder, the table or the die
2026-09-13 The eye on the board: a BRIO over the breadboard, its tool, its measured settings, and every device by its stable name
    A Logitech BRIO on an arm over the breadboard, on the Pi's USB 2 hub.
    Plugging it in moved the grabber from /dev/video2 to /dev/video0, so
    the eyes tool and the notes now name every device by its /dev/v4l/by-id
    path. tools/eye.py drives the camera over ssh: grab applies the
    settings as UVC controls, lets the sensor settle, keeps one 1080p frame
    and writes every control as the camera reported it back beside the
    picture; sweep steps the lens and scores the chip column's sharpness,
    level-normalised, which is where the default focus of 25 came from; the
    presets are the whole boa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
2026-09-13 The two eyes on a timer: grab.sh files a board and a screen frame by the day, every five minutes by cron
    scripts/grab.sh runs on the Pi and writes captures/YYYY/MM/DD/<stamp>_board.jpg
    from the BRIO the way eye.py's board preset takes it, and <stamp>_screen.jpg
    off the composite grabber, one lock over both cameras so a hand-run grab and
    the cron's do not fail each other. install-grab-cron.sh puts it on the
    crontab every five minutes, tagged and idempotent; pull-captures.sh brings
    the day's frames to the workstation and names the newest of each.
2026-09-13 The timed frames are filed in the bench's own zone, not the Pi's London clock
    install-grab-cron.sh --tz ZONE puts TZ on the cron line; the log line
    carries the offset so a stamp always says which clock it is on. The Pi
    came provisioned on Europe/London, five hours ahead of the bench.
2026-09-13 The head's notes carry the timed frames; the garbled logo is intermittent, the timer is its watch
2026-09-13 The bridge read off the eye while it was built: six findings, the 165's ground one hole high first
2026-09-13 The second eye on the timer: the QuickCam low across the board as the side frame
    Claude-Session: https://claude.ai/code/session_0111NK9adULt5mM5s8exmXvg
2026-09-13 Second QA pass after the reboot: rails and grounds right, four J1 landings to meter
    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
2026-09-13 The right-angle sheet as built: grey where a wire was seen in its hole, a ring where it needs a check
    tools/wiring-diagram.py draws docs/wiring-v1b-build.svg beside the clean
    sheet (which stays byte for byte, for the drawing package) from
    docs/build-status-v1b.json, the pin-by-pin state read off the bench eye at
    14:30 on 2026-09-13: fifteen pins done across the grounds, the +5 V stubs
    and the console clock; twelve checks, the rails first, then the 165's
    ground on pin 7, DS with no ground, the inverter's pin-7 ground, the
    UNO-side stub to U1-1 one column low, and the landings a meter settles.
    A status key that names no pin, or a check note on no drawn pin, stops
    the tool. check-sheets holds t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
2026-09-13 TM-NESB-001 rev C: the as-built wiring sheet joins the package
    The v1b package gains sheet 5, the right-angle wiring diagram with the
    build's state on it (grey done, ringed check, notes under the rails),
    and a rev C row. The status is re-read at 14:50: the 165's ground and
    DS were reported fixed at 14:45 and the camera still shows both as they
    were, so both stay ringed and say so; U1's and U3's pin-1 notches face
    up, U2's is under the blue lead.
    Claude-Session: https://claude.ai/code/session_01BdJ3NUxHSKQzEFUn9ViLv2
2026-09-13 Baseline: the eye fixed in its mount, named close-ups of every landing, the wiring as built
    The BRIO is fastened down: focus re-swept to 20, and a frame ten minutes
    later lands within a pixel of the baseline. docs/eye-views.json names a
    zoom-500 close-up of every landing, aimed by the crop geometry measured
    by locating four calibration crops in the whole frame; eye.py gains
    --view and a views command that takes the set. The as-built sheet is
    re-read against it: 22 pins done (U2's ground and DS fixed, U1-7 on its
    end pin, all four J1 leads, the rails), 4 checks (the UNO-to-U1-1 stub
    one hole low on D3, U2/U3 orientation marks off camera, the UNO feed off
    camera). The rails can now be marked d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
    [eye.py, wiring-diagram.py]
2026-09-13 Plan: the calibration cartridge, a frame that names itself, read the same way off the part and the model
2026-09-13 C0's machine side done: the calibration cartridge exists, and how to build it, unrolled as a tutorial
    The plan records what the build decided (three strip rows because the
    blanking budget rules, a two-frame echo latency stated in the manifest,
    eleven colours a screen because the strip costs one), the gates as run,
    and the files' checksums; the part's side stays open for the flashcart.
    build-the-cal-cart.md walks from the idea to the ROM in a console, each
    step ending in something to check.
2026-09-13 cal.py: the calibration cartridge's reader for every eye, proven on the model's pictures before any capture
    grab finds the console's grid in a grabber frame from the strip's own
    structure (every offset that reads a strip, then the one whose band best
    matches the ideal strip drawn from the bits read, since the decode smears
    edges and a step's energy ties), reads the strip by the manifest's
    rectangles, refuses what does not read, and scores the screen's flat
    regions against the model's decoded picture of the same screen and
    variant; scope decodes a record, reads its strip and runs capture-score
    to that frame; model measures the frame offset (3). selftest reads the
    model's eight decoded screens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
2026-09-13 The eye leaves exposure to the camera: a manual value is clamped to the frame time and cannot follow the room
    Measured when the room light changed: exposures above the frame time read
    back but do not brighten the frame, with or without the dynamic frame
    rate; auto exposure recovers the level and follows the light between
    timed frames. Focus stays 20.
2026-09-13 Second baseline: the eye re-aimed after the camera moved, the wiring unchanged; C1's machine side recorded
2026-09-14 The cart's pages: the blank boards and the programmer read off their photographs, the eight screens as the decoder sees them
2026-09-14 The wiring on the photograph, and the ROM into its two flash images
    board-overlay.py draws every chip pin's landing on the eye's frame of the
    right breadboard, ringed and named with its net, grey, pink or coloured
    as the as-built sheet has it; the hole grid was read off the 15:40 frame
    under pixel rulers into docs/board-map.json (a column's y quadratic in
    its number for the camera's angle, a row's x drifting with y), one
    camera pose, dated. The first render rotated the frame the other way
    from the rings and the photograph showed it at once.
    nesprep.py takes the owner's build spec (SST39SF040s in U3 and U4 of the
    discrete mapper board, 512 KiB each, the lockout defeated): header off,
    program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
    [board-overlay.py, nesprep.py]
2026-09-14 The junction overlay on the lit frame: the grid re-read for the moved camera, rows as even progressions, columns by the measured shift
2026-09-14 The eye locked down after the USB drop: the grid read afresh, the views carried through the camera's similarity, the overlay redrawn
2026-09-14 The J1 to U3 chain read off the eye: /PL and the eight Q lines as built, rev E, two checks on U3
    The user's batch wired the teal /PL link (U1-2 to U2-1) and the eight Q
    lines between the 165 and the 595. Read against the cheat sheet from
    the zoom-500 views with the board map's holes projected onto each
    close-up, so every tip is read beside its column number: /PL, Q_B
    (blue), Q_SEL, Q_START, Q_A (brown, its end proud of the hole) and the
    four rails-side lines into U2-11 to U2-14 land where the sheet puts
    them; on U3's middle side the four lines from U2's rails side land in
    columns 10, 9, 9 and 8, so pin 5 (Q_DOWN) carries two wires and pin 7
    (Q_RIGHT) none. The as-built sheet says which to mo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
2026-09-14 The U3 checks closed: one wire per Q pin, the brown seated, rev F
    The user moved the second wire off U3-5 and pushed the brown home. Read
    again from fresh close looks with the map's holes projected onto them:
    U3's middle side carries one wire per column, 13 down to 7, each bare
    end at its hole, and the brown's bare end enters U2-6. The boards had
    moved on the desk again (126 px down; the chip bodies stand proud and
    read 7 px further than the board, the printed number and the blue
    wire's known hole set the last 7 px), so the map shifted and the views
    re-aimed. 40 pins done, 4 to check, all on the strip side and the
    rails' feed.
2026-09-15 The rig baseline: the eye on the metal frame, the map read afresh, the UNO's leads read as far as they can be seen
    The BRIO is fixed to a frame over the boards, straight down, turned so
    the whole board sits in one frame at about 24 px a column with no
    perspective. The hole map is read afresh off that frame and carries a
    frame_rotate so the overlay keeps its convention; every named view's
    aim is carried through the measured similarity; the presets' focus is
    25 (the sweep). Read against the rig set every pin settled before
    reads the same. The UNO batch: D2 and the console's CLK share a
    housing on U2-2 (settled); D5 and OUT0 share one pulled diagonal over
    columns 35 and 34 (check); the three SP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
    [board-overlay.py, eye.py]
2026-09-15 The rig baseline's stamps read in the Pi's zone: 01:10 EDT, not 06:10; a second look after the reported re-route finds the board unchanged
    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
2026-09-15 Second rig pose: the map read off the frame by the tool, the UNO's direct leads read to the eye's limit, rev H
    The user re-ran the UNO's leads direct and shifted the boards right.
    board-overlay.py --read now reads the map with no hand in it: every
    hole centre by template correlation, the two five-row groups (the
    second looked for across the chip gap only) and the rail pair as even
    progressions, the columns walked from the board's last hole with an
    adaptive pitch (the lens shrinks it toward the edge, so anchors every
    fifth column and the map interpolates), and every named view re-aimed
    through the similarity between the maps. It reproduces the previous
    hand-read map on the previous frame. vie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
2026-09-15 U1-1 and the SPI pins metered: recorded as measured, rev I; one check left, the UNO's ground
    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
2026-09-15 The header across the rails at column 27 is a probe point, not the feed: the UNO's ground is still to find, now circled where its 5 V enters
    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
2026-09-15 The ground settled: through the UNO's USB, as designed; no checks left on the right board
    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
2026-09-15 The middle board mapped: the map reads every board in its band, parts placed, the overlay one panel per board, rev J
    board-overlay.py --read reads each board the map names inside the
    camera-y band it sits in, the rail pair looked for beyond both row
    groups and the side with more holes winning, and each side's rows
    ordered by distance from the rails so both boards read alike whichever
    way up they lie (the middle board faces the right one rail to rail: a
    to e toward it, f to j toward its own rails). The map places
    single-row parts (side, columns, pin-1 end, row): J2, the pad-side
    housing, at columns 9 to 13, and R1 at 47 to 49. The overlay draws one
    panel per board as they lie; the ring projec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
2026-09-15 The housing at columns 9 to 13 is the power breakout's, parked; J2 is not located yet
    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
2026-09-15 The scope's channels and the trigger on the cheat sheet; steps 5.1 and 6.1 run against the live bench and recorded
    The cheat sheet carries the scope's four channels and the trigger as
    wired 2026-09-15: CH1 held for the master clock, CH2 on the latch at
    U1-1, CH3 video, CH4 on D0 at U2-9, TRIG through R1 to EXT TRIG.
    Two bring-up steps were run from the Pi against the bridge and the
    scope with the console polling. 5.1: 1,203 polls in 20 s at 60.1 a
    second, 826 of them eight clocks, the other 377 spread from 0 to 16
    with neighbours summing to 16: B0's first gate does not hold yet, and
    the number is on the record. 6.1: TRIG 20 did not stop the scope on
    EXT TRIG. Both are the sitting's first re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
2026-09-15 This scope has no external trigger input: TRIG moves to CH1
    MEASURED 2026-09-15: the DS1054Z refuses the SCPI trigger source EXT
    and keeps the source it had, so an arm on EXT waits on whatever
    channel was set before, which is what step 6.1's first attempt did.
    The head's arm now refuses EXT with the reason; step 6.1 arms on CH1;
    the cheat sheet and the wiring note carry the finding and the new
    allocation (CH1 was held for the master clock, not probed yet; the two
    share it by turns later).
    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
2026-09-15 B0 gate 1 held: the bridge books each poll's clocks at the latch's own edge
    The per-poll clock counts scattered in pairs summing to 16 while the
    totals were exact: the loop read the latch counter and the clock
    counter apart. Three fixes, each found by the gate on the live bench
    and flashed through the Pi: the clock count snapshotted in the latch's
    pin-change interrupt; a rise told from a fall by Timer1's count rather
    than the pin (a 3.6 us pulse can be over before the interrupt runs);
    the loop taking the latch count and the snapshot from the interrupt as
    one pair. Three runs of 1,202 to 1,203 polls, every one eight clocks;
    MUTATE ON still reports one a latch. firmware/build-uno.sh builds the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
    [bridge-uno.ino]
2026-09-15 The sliver seen at 1 us/div: D0's own edge couples into the clock line and shifts the 165 again; the fix is an RC on CP
    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
2026-09-15 The clock pin's filter on the sheets, the trigger to CH1 on the schematic, the boards rearranged and re-mapped, rev K
    R2 (1 k, CON_CLK to CP) and C4 (100 pF, CP to ground) join sheet 1 of
    the v1b schematic, the breadboard sheet, the wiring diagram (the row
    tightened from 132 to 118 between parts so the sheet keeps 5 pt on
    ANSI B), the parts list and the cheat sheet; R1's note now sends the
    trigger to CH1, this scope having no external trigger input. The
    boards were rearranged on the frame and the map re-read for the pose.
    The walk of single bits after the RC reads exactly as before, and
    three multi-bit bytes read bit for bit as "each D0 fall outside the
    load adds one shift" predicts; the ey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
    [breadboard.py, draw-schematics.py, wiring-diagram.py]
2026-09-15 Footprints for R2 and C4, so the fab export and the public pull accept the sheet
    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
2026-09-15 Placements drawn on the photograph: the clock filter between the lead and the pin, U2's own decoupling across its supply pins; probe positions on the cheat sheet; the rig's dimensions
    A pin's state may now be "plan": a placement asked for and not built,
    green on the photograph with its instruction below, listed with the
    checks on the sheet. R2 and C4 are drawn where they belong (the CLK
    housing moved to column 27, the 1 k from 27 to 24, the 100 pF from 24
    to U1 pin 7's strip at 28) and C2 across U2's supply pins at column 18.
    The cheat sheet's scope table gives each probe's landing as a board
    column; CH2's lead is recorded broken. docs/rig.md carries the backing
    board and breadboard dimensio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
    [board-overlay.py, cheatsheet.py, wiring-diagram.py]
2026-09-15 The wiring sheet lists a placement note for a part it draws without pins
    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
2026-09-15 The map read works off a zoomed frame (--zoomed), carries its pitch past the last anchor and starts its column walk from a peak with a neighbour; the rig note records the raised camera's tilt
    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
2026-09-15 The rig locked: the BRIO raised and levelled, both side eyes aimed, the map read per board off zoomed frames, the as-built photograph drawn on them
    At the raised height a zoom-100 frame puts 11 px on a hole, under
    what the hole finder resolves, so the map is read per board off a
    zoom-250 frame (board-overlay.py --read --zoomed, each board's frame,
    aim and band kept in the map) and put into zoom-100 coordinates; the
    overlay draws each board on its own zoomed frame and wraps its notes
    to the width it comes out at. Both boards read to column 56, the
    views carried through the similarity (worst residual 8 px) land with
    the rings on the holes, focus 18. docs/rig.md carries the pose and
    the side ey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
    [board-overlay.py, eye.py]
2026-09-15 The trigger cleared: R1 placed where it lies, TRIG 20 stops the scope on CH1, the pulse 5.4 V for 874 us
    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
2026-09-15 J1 and J2 located with the pointer: J1 at the right board's columns 44 to 40, J2 in row j of the middle board's columns 15 to 10
    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
2026-09-15 C2's placement corrected: pin 16 is column 25, not 18; D0 reads flat with a capacitor on pin 9
    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
2026-09-15 The filter and decoupling seen on the middle board; the walk waits for the CH4 probe, which is a pointer for now
    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
2026-09-16 The register walk reads right through the console: the clock filter and decoupling done, the Q pairing proven, rev M
    All fifteen bytes walked through the 595 come back on D0 at their own
    positions, where a lone middle bit used to read at the Right position.
    The filter and decoupling are done on the sheet where they sit; the
    last checks on the chip pins are cleared; the cheat sheet's scope table
    carries each probe as the instrument identified it (ff makes D0 flat,
    the latch pulses whatever is held).
    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
2026-09-16 The wiring sheet accepts a done state on the decoupling bank it draws without pins; rev M built
    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
2026-09-16 v1b sheet 3: the head's hands, the PC817 on the reset pads and the relay in the adapter lead (rev N)
    A third landscape letter sheet for bring-up 6.2 and 6.3: the Pi's four
    jumpers with their header positions as pin numbers, OK1 across the
    reset pads through J3 (which two ways, and which is ground, is what
    6.2 meters first and the sheet says so), K1's NO and COM in one cut
    conductor of the adapter's low-voltage cable, and the mains rule. It
    is its own netlist (bench-v1b-head), because nothing on it is on the
    breadboard and the wiring and breadboard drawings lay out every part
    of the netlist they are handed. ERC clean.
    check-sheets holds the sheet's Pi positions to the cheat sheet's jumper
    ta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
    [check-sheets.py, draw-schematics.py, netlist.py, parts.py, render-png.py]
2026-09-16 The title frame's revision strip spaces its four rows over the strip, not over the whole list
    The row height divided by the number of revisions while only the newest
    four are drawn, so fifteen entries in the four rows shared a quarter of
    the strip and overprinted. Rev N's row added.
    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
2026-09-16 The head's hands cheat sheet: sheet 3 as tables, and the two modules pin by pin
    tools/cheatsheet.py --sheet bench-v1b-head writes docs/cheat-sheet-head.md:
    every wire on sheet 3 as one row per net, the Pi's four jumpers read off
    the sheet (positions held to PI_HEADER), the power and reset breakout,
    and the PC817 and relay modules pin by pin. Module pins are named, not
    numbered, so the join is by name both ways: a drawn pin the table lacks
    and a table pin the sheet lacks are both refused; MUTATE renames one and
    is caught. The bring-up's 6.2 and 6.3 close the page, from the tool's
    own table.
    The package gains the head pin map and the two module sheets (21 pages);
    the sitting 5 steps sheet is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
    [cheatsheet.py, make-package.py]
2026-09-16 The rig's regression check, and the per-board map read as a tool
    tools/rig-check.py --pi HOST runs after every change to the bench: the
    whole-board frame lit and unmoved against a baseline (worst 40 px block of
    the difference under 60, where sensor noise measures about 20 and a move
    120 and up), each board read afresh off a zoom-250 frame at the map's aim
    and held to the map within half a hole, and the side eyes lit and still
    correlating with their baseline frames. Exit 1 on any FAIL; --baseline
    keeps the frames and their measurements (docs/rig-baseline.json, dated)
    and refuses if a check fails on them. First run 2026-09-15 late: light
    PASS, both boards FAIL against the map, which is right: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
    [board-overlay.py, rig-check.py]
2026-09-16 The signal paths' regression check: bridge, scope, polls, trigger and the register walk as one tool
    tools/bench-check.py runs what the bring-up and the register walk held:
    the UNO answers STATUS, the scope answers *IDN?, the console's polls come
    at sixty a second with eight clocks in every one, TRIG 20 stops the
    scope on CH1, and fifteen bytes set into the register read back off D0
    at the eight mid-slots. No polls is a SKIP with its reason, not a FAIL.
    The scope's settings are read first and put back. The walk, which had
    lived as a scratch script since 2026-09-15, is now in the repository.
    FOUND on the first run: 14 of 15, byte 00 read with bits 6 and 7 pressed.
    The screenshot showed D0 fal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
    [bench-check.py]
2026-09-16 The head's hands at right angles: wiring-v1b-head.svg from sheet 3's netlist
    tools/wiring-diagram.py draws one sheet per entry in SHEETS now: the
    netlist, the row of packages, the two rails and the words differ, the
    routing and the drawing are shared. The head's row runs Pi, PC817,
    relay, console, adapter, left to right as they sit; the Pi's pins carry
    their header positions beside the stubs; top edges are the Pi's side
    and bottom edges the console's, so the isolation reads off the sheet.
    Seven nets on tracks, none crossing the row. The v1b sheets are byte
    for byte what they were.
    A part with pins on one edge may put its label at the other end
    (label_at), which is what gives the console's p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
2026-09-16 The bench check's two hands: reset and power by the front panel or by the Pi, read off the poll stream
    bench-check.py --hands manual|head adds two checks. Reset: the game
    stops polling while the CPU is held and polls again after, a pause of a
    second or more; by hand the button is held two seconds, from the head
    GPIO17 holds OK1 for two. Power: the stream stops for a count of three
    and resumes; by hand the switch, from the head GPIO27 through K1 for
    three seconds. The front panel stays wired, its button in parallel with
    OK1 and its switch in series with K1, so the two modes are the same two
    measurements with a different hand, and sheet 3 says so now.
    FOUND building it: the Pi's serial bridge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
    [bench-check.py, draw-schematics.py, headd.py]
2026-09-16 The head's two modules as laid out, called out: which screw and pin takes which lead
    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
2026-09-17 The relay answers the Pi: three cycles from GPIO27, heard; the power-up rest state opened as an item
    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
2026-09-17 The head's pins rest off from power-up: GPIO27 high, GPIO17 low in the Pi's boot config, read back after a reboot
2026-09-17 The front panel's harness, metered: the relay across the power switch and the optocoupler across reset, both on J3
    The user metered J3 unpowered: 1 brown and 2 red are the power switch,
    3 orange and 4 yellow the reset button, 4 yellow and 5 white the LED, and
    no way is ground (the front panel is grounded by its pad and housing).
    K1's contact now goes across brown and red, in parallel with the front
    switch, instead of in a cut adapter conductor; OK1 across orange and
    yellow, in parallel with the button. The button's high side is still to
    meter with the console on, so sheet 3 and the right-angle sheet draw
    those two pins unnumbered until it is. The bring-up's 6.2 and 6.3 say the
    same and ask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
    [bench-check.py, bringup.py, cheatsheet.py, draw-schematics.py, lab-notebook.py, make-package.py, wiring-diagram.py]
2026-09-17 Reset button: about 200 ohms held across orange and yellow, unpowered
2026-09-17 The reset button's polarity, measured: orange 4.40 V above yellow, so OUT on orange and GND on yellow
    Sheet 3 and the right-angle sheet number J3's pins 3 and 4 again, with
    the sign on them; the bring-up's 6.2 names the two colours instead of
    asking which is which; both cheat sheets' J3 table carries the reading.
    The package is 23 pages, the head's pin map having run onto a second.
2026-09-17 The head's two hands hold: reset and power from the Pi, twice end to end, and three things the run found
    bench-check.py --hands head ran clean twice: polls all eight clocks, the
    trigger stops the scope, the walk reads 15 of 15, a reset pauses the polls
    2.00 s and a power cycle about 3 s, both from the Pi. Bring-up 6.2 and 6.3
    are held and the open item is struck.
    What the run found, none of it the wiring:
    The relay goes the other way. MEASURED at the console: GPIO27 HIGH powers
    it (video 0.88 Vpp, the port's latch idling at 4.3 V) and LOW turns it off;
    the module's LED agrees. The first run drove the pin low to power on and
    switched the console off, and every later check skipped for want o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
    [bench-check.py, bringup.py, cheatsheet.py, draw-schematics.py, headd.py, wiring-diagram.py]
2026-09-17 The parts list follows sheet 3's relay note
2026-09-17 The head holds reset half a second: 100 and 250 ms left no mark the poll stream can see
    MEASURED 2026-09-17 with the console powered by the head: a 100 ms pulse on
    GPIO17 and a 250 ms one gave no quiet run in the polls, a 500 ms one paused
    them 0.50 s. The stream cannot resolve less than about half a second (the
    bridge batches its lines), so the short pulses are unproven, not shown
    ineffective, and the open item names what would settle it: the scope on the
    latch line at 50 ms a division.
    [headd.py]
2026-09-17 Two scripts for the bench's checks: your hand on the panel, and the Pi's
    scripts/hands-manual.sh and scripts/hands-head.sh run the same
    bench-check.py with --hands manual and --hands head. Each reads the bridge
    and scope addresses out of bench.local.md, says which position the front
    panel's switch wants (ON for the manual run, since the relay rests open;
    OFF for the head's, since the relay is in parallel with it), and passes
    further flags through. The manual run skips the register walk unless asked,
    the head's run being the one that covers it.
2026-09-17 The bench check runs where Pillow is not: numpy and Pillow imported at the register walk
    The walk's screenshot reading is the only part that needs them, and the Pi
    has neither. Everything else is sockets and text, so the checks and both
    hands now run on the Pi itself with --no-walk. The scope-address helper
    comes from bringup.py, which wants numpy too, so its absence just means
    --scope has to name the address.
2026-09-17 The head's hands run where the Pi is, and the walk skips where Pillow is not
    Two faults in one run on the Pi itself: the check ssh'd to 127.0.0.1, which
    a Pi cannot always do (host key verification failed), so GPIO27 was never
    driven and the run said 'it was None' and carried on; and the walk raised
    ModuleNotFoundError on Pillow in the middle of the run instead of skipping.
    pi_run() runs the pin commands locally when this machine has pinctrl or the
    host is the loopback, and over ssh otherwise. A pin that could not be read
    is printed with the reason and fails the power check rather than passing
    quietly. The walk is a SKIP where Pillow is missing, naming the workstation
    as the place to run it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
    [bench-check.py]
2026-09-17 A head run says when the front panel's switch is bypassing the relay
    Before it powers the console the check now opens the relay and listens: if
    the polls keep coming, the panel's POWER switch is on and K1 has nothing to
    switch. The power check skips with that reason instead of failing for
    something that is not the wiring (seen 2026-09-17 on the Pi, where the
    switch had been left on after a manual run).
    [bench-check.py]
2026-09-17 Exercising the bench: the two stacks as one typed diagram, the dialect, a six-step regime and the three programmes on it
    docs/exercise.md is the notebook's new section for the v1 bench: the
    physical stack and the virtual one under one script, drawn as
    docs/exercise-stack.svg by draw-schematics.py with every arrow typed by
    what it carries (command, stimulus, signal, record, picture, oracle,
    proposed) and pointed the way it moves, and the two rules the sheet
    obeys: control flows down from the script and never up out of a
    comparator; a word means the same on both sides or names its side.
    The document records the dialect layer by layer as it stands (the wires,
    the head, the script, the model, t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
2026-09-17 E2 played: the head as a unit on the Pi, the game's title captured twice and scored against the model's frame at the same latch
    The first step past E0 in docs/exercise.md, on the multicart's Super
    Mario Bros. title: exercise/e2-title.txt (MODE INJECT, Start at latches
    200 and 201, TRIG 300, a two-channel 12 M point capture). The bridge's
    315 polls agree with pad-log's byte for byte; b1-score names the first
    failing region ($17, every axis). The hue miss repeats to 0.1 deg over
    two records at two vertical scales (the model's sky nine degrees bluer
    than the part's, as the eyes measured in September); the luma and
    saturation readings move by one level of the coarse record, so the
    script arms th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
    [b1-score.py, bench.py]
2026-09-17 Both hands hold under the head: with the console's switch off, a head script powers it on and off and the poll stream says so
2026-09-17 The knobs file, the second move: one knobs.toml per run with every value's source, written by the bench and read by the model's runners
    tools/knobs.py init writes runs/<stamp>/knobs.toml from the measured
    alignment and the run's ARM line (the video's channel, scale, offset);
    show prints it; check runs nes-console's reader on it, which refuses
    a table or key it does not know by name. init refuses to overwrite: a
    knob that changed is a new line with its source. b1-score.py writes
    the file for a run that has none, hands it to the scorer as KNOBS=,
    takes the video channel from it, and keeps it out of the capture list
    (the first pass counted it as a second capture).
    docs/exercise.md, Programme 1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
2026-09-18 The x-ray, the third move: two runs one byte apart, the half-cycle they part at, the instruction there and everything the byte changed; the encyclopedia's first two entries
    tools/xray.py traces a ROM twice through nes-console's trace (00 held,
    and HH at latch N for one latch), streams the two .pins records side
    by side so any length fits, and reports diverge (the first half-cycle
    apart, with the instruction disassembled from the 6502 site's own
    table), the path (every later differing half-cycle in spans labelled
    with the instruction and what it did: RAM written, PPU register
    reached, bank switched; a long span summarised as a code path), rejoin
    or never, the byte's later cart and rendering w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
2026-09-18 The frame dissected: what a game does when against the PPU's scanlines, the routines it does it in, and the x-ray on top of a script
    tools/dissect.py reads a trace's .pins and events over chosen frames
    and prints a timeline in scanline order (the NMI's vector, the PPU
    register writes with their line and dot, the DMA folded into one line,
    $2007 bursts with the routine that wrote them, the $2002 spins, the
    pad's latch with the routine polling it, the idle loops and how long
    they spun, the handler's RTI), the routine call tree with the
    half-cycles spent inside each (JSR to matching RTS by stack depth; a
    jump engine, a JSR target that pulls its return address and lands by
    JMP indirect, closed at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
2026-09-18 Super Mario Bros. dissected on the model: the loop inside the interrupt, the frame scanline by scanline, the routine tree, the VRAM pipeline, the pad's byte to a jump; five more encyclopedia entries
    docs/mario-dissection.md, from tools/dissect.py and tools/xray.py on a
    660-frame record of the multicart: the main program is one JMP to
    itself and the game is its NMI handler, entered at line 241 with NMIs
    turned off and left between lines 87 and 114 with them on; the blank
    spent on the DMA, the VRAM buffer, the sound and the pad; lines 16 to
    30 spent waiting for the sprite-0 hit under the status bar; the
    level's scroll written at line 31, the split; the game's logic in the
    visible frame after i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
2026-09-18 The poll's scanline measured on the part, and a cold-boot finding: the multicart's menu ignores Start until a warm reset
    tools/poll-line.py: a capture with the latch on CH2 beside the video
    on CH3, every latch rise placed against the vertical sync before it,
    the line period off the record's own horizontal syncs. Fourteen polls
    per capture. The menu on the part: 136.55 lines after the sync, a
    spread of 0.08 line, PPU line 119.6 with the encoder's sync rows; the
    model: 120.15. The game: 250 on the part, 251 on the model. The same
    six tenths of a line on two screens: the encoder's line-granular
    vertical sync, an open item for the switch-level PPU to settle.
    Found on the way: cold-powered by th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
    [poll-line.py]
2026-09-18 The split on the part: the status bar still through row 32 and the level moving from row 47, the same as the model, and the triggered frame found one picture late
    exercise/split.txt: the warm-reset recipe into the game, Right held
    from latch 520, TRIG at 600 with the video on CH3. tools/split-score.py
    drives nes-console's split-score from a run the way b1-score.py drives
    capture-score; the run reading (script, capture, knobs) is lifted out
    of b1-score.py into two functions both import.
    Run 20260918-135721 (banked at the captures store as split-t600):
    row for row the same picture on part and model, 1.94 against 1.89
    dots over two frames, the fourteen flat sky rows the only width in
    the brack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
    [b1-score.py, split-score.py]
2026-09-18 The poll's scanline read right on both sides: the die's vertical sync onset in poll-line.py, the PPU's own lines in dissect.py, and part and model agree to a hundredth of a line on the menu and three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
    The six tenths of a line between the part's poll and the model's was
    two errors, neither the chips': the encoder's vertical sync authored
    64 dots late (measured on the 2C02, held in ntsc-crt v0.2.10), and
    dissect.py numbering the pre-render line 0 and drifting a dot per
    skipped dot. poll-line.py places the onset at row 244 dot 280;
    dissect.py counts from the frame's own start in the PPU's order; the
    model's positions come from its own recorded strobes (pad-log
    POSITIONS=1). The disse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
    [dissect.py, poll-line.py]
2026-09-18 The x-ray's lines are the PPU's own: the Start entry's three numbers re-read from the trace after nes-console's trace named the pre-render line 261
2026-09-18 E2 rerun under the frame rule: the morning's record rescores to the thousandth, a third record repeats the hue, and the luma spread between records at one scale is as large as between scales
    exercise/e2-title-warm.txt reaches the title on a cold-powered console
    through the warm-reset recipe. The scale attribution for luma and
    saturation no longer stands alone; recorded, not fitted.
2026-09-18 The menu's first two seconds on the part: the poll drops half a line at latch 127, the same latch as the model, every latch within a tenth of a line
    Three records with the bridge's TRIG, the latch and the video on one
    capture (6 M points, the scope's depth with three channels), the TRIG
    armed before the reset because RESET clears the bridge's trigger.
    poll-line.py numbers the polls from the pulse: the longest high run on
    its channel, since the channel also carries the pad's clocks as blips,
    and latch n is the last rise before it.
    [poll-line.py]
2026-09-18 The head forgets the last session's latch on the bridge's reset acknowledgement: a WAIT n after RESET returned at once when the session before had passed latch n
    Found by a cold-power script whose WAIT 400 captured at latch ~190,
    the head still holding 2773 from the morning. Three scripts for the
    cold-boot question: no reset, one, three.
    [headd.py]
2026-09-18 The cold-boot Start mystery closes as the bench's own: the head's WAIT returned early after a RESET and the scope caught the menu before the press; asked again, the part takes Start with no reset, on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
    The six runs that ignored Start went from wait to armed in the three
    seconds the arm takes; the one that took it waited 12.8 s. Corrected
    where the wrong reading stood: open-items (closed), the dissection's
    finding (withdrawn), the encyclopedia's menu entry, the knobs table,
    the script dialect's WAIT and RESET rows, two scripts' comments.
2026-09-18 The luma spread between records answered: the scorer read the levels as whole codes (ntsc-crt v0.2.11 reads between them), and what remains is the console's warmth, about a hundredth over its first h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
    A warm-up series, ten captures over 47 minutes: the luma stepped 0.012
    between two captures while the record moved a hundredth of a code;
    rescored, a smooth drift to a plateau from about thirty minutes, the
    hue flat. E2's records rescored: the two scales agree.
2026-09-18 E3's machinery on the part: b3.py replays a typed record twice and bisects, part against part identical, part against the model agreeing at every latch, a dropped byte disagreeing; the hand's record 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
    b3.py met the part and changed three ways: the arm names the bench's
    channels and trigger, the status poll rides out the head's silence
    while it reads a record, and a capture is called the model's by the
    picture's correlation (the screen's coarse shape and the frame at full
    resolution, split-score's fourth section) instead of B1's region
    tolerances, which every real capture misses by its calibration.
    [b3.py]
2026-09-18 The head sends each bridge line and waits for its echo: 125 AT lines back to back overran the UNO's serial buffer, dropped some and took others with digits missing, and the hand's replay played a dif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
    An AT's echo must carry the latch and byte sent; a # ? or a mismatch
    stops the run. b3.py record starts at the bridge's reset
    acknowledgement and takes --until for a prefix that fits the schedule.
    The hand's record (run 20260918-232934, 247 changes) cut at latch 2300.
    [b3.py, headd.py]
2026-09-19 b3.py record keeps the run's power-up before its RESET: replays from a bare reset came back up in the multicart's game, not its menu
    The first hand's replays (runs/e3h-*) started from the bank the run
    before left, so Super Mario Bros. restarted without the menu, the
    menu's presses went to the game, the screens matched the model's a
    frame off and the bisection walked to latch 1. Seen by dumping the
    part's frame at latch 142: 1-1, where the model showed the menu. Two
    hand records: the first cut at 2300, the second (level cleared) at
    1850, each under the UNO's 128 changes.
    [b3.py]
2026-09-19 The head holds the console in reset while a replay's schedule, arm and trigger load, and refuses a trigger whose latch has passed; b3.py sizes the model's frame ceiling to the latch
    The whole-minute replay loaded 290 echoed AT lines in 15 s against a
    running console and its TRIG 1000 fired at latch 1060: both replays'
    latch-1000 captures were the game 60 frames on and read as a
    divergence. The model's default ceiling (2000 frames, ~1985 polls)
    scored nothing past latch 2000.
    [b3.py, headd.py]
2026-09-19 E3 on the whole minute: the hand's run replayed to the flag on the packed schedule, both replays agreeing with each other and with the model at 1000, 2000, 3000 and 3580, the bisection finding no div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
    b3.py asks the head's status before re-asking a run it may have
    started, and agree compares replays by the model frame they land on.
2026-09-19 split-score's 0.77 closed as a recovery bug (ntsc-crt v0.2.12: each frame's subcarrier origin measured, not assumed), and the part's quarter-dot registration recorded as a measurement
2026-09-19 The warmth knob: seconds on off the head's logs, the curve fitted to the warm-up series
    knobs.py writes [warmth] (the trigger against the last power on across
    every run's head.log; nothing when the head never switched the power)
    and [warmth_curve] (depth 0.0214, tau 1050 s, rms 0.001), and 'warmth'
    appends both to an older file. warmth-fit.py refits the curve from a
    series scored with b1-score --cold, and --check scores it with the
    knob: the luma drift over 45 minutes flattens from 0.009/0.013 to
    0.0035/0.004, and the hour-warm morning record, never in the fit,
    lands within 0.001 of the cold one. exercise.md, Programme 1.
    [b1-score.py, knobs.py, warmth-fit.py]
2026-09-19 E2 on Duck Hunt's field: six colours on the part at two levels; the hue miss grows with the level, the luma gap is an offset
    exercise/dh-field.txt (the menu's Select, Duck Hunt's Start held from
    600, the field at 900), played twice and Super Mario Bros.' title once
    more at the same warmth. The high luma row misses hue by -9.2 to -11.9
    degrees, the low row by -0.2 to -7.9; luma misses by the same ~0.045
    at both levels (an offset), saturation 12 to 15 percent short (a gain).
    Open: the field matches the model's F-1/F+1, not F.
    knobs.py: a POWER ON with the relay already closed no longer restarts
    the warmth's clock.
    [knobs.py]
2026-09-19 Duck Hunt's frame is the model's F, and the low luma belongs to the colour: two of E2's findings answered, and a third item opened
    The field at latch 900 does not move, dot for dot, for ten frames
    either side, so the records that read F-1 and F+1 alike were reading
    the colour subcarrier's phase, which alternates with the PPU's frame
    parity. Two captures with the round's ducks climbing (exercise/
    dh-duck.txt at latch 989, dh-duck-late.txt at 1020) score F+0 on the
    dots the candidates draw differently: rms 0.047 against the next
    candidate's 0.117 and 0.158, over a floor of 0.020. The frame rule
    holds on a game that polls at line 249.
    One colour down the picture separates a row effect from a c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
2026-09-19 The console gets MMC3, and with it one more open item: where inside a CPU cycle a cartridge's /IRQ reaches the core
    Mapper 4 is built (nes-bus 0.1.3, nes 72200f5), so Super Mario Bros. 2
    and 3 have a console to run on once their cartridges are read. Four of
    blargg's six MMC3 ROMs pass; one of the two that do not is the other
    chip revision by choice, and the other measures a cartridge interrupt
    to PPU clock accuracy and puts the console inside half a CPU cycle of
    the part. The board's own count is right from three directions: the
    ROM that counts 241 clocks a frame, a cartridge written here that reads
    the same from outside, and the rise sitting on dot 261 where the
    switch-level 2C02's fetch pr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
2026-09-20 The cartridge /IRQ item: one half closed, the other fitted, and a new one underneath
    blargg's 4-scanline_timing passes as of 2026-09-22, and it took two
    things rather than the one this item named.
    The board's half is closed: the A12 filter took nine dots of low where
    the part takes ten, nine being exactly three CPU cycles so the third
    falling edge of M2 lands on the rise rather than before it. One clock a
    frame, only with the background at $1000.
    The console's half is a fit and now says so: the cartridge's /IRQ is a
    LINE, held behind the board by sixteen master half-steps, and the ROM
    brackets that to thirteen through twenty and no further. A scope on pin
    15 against phi2 is what turns the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
2026-09-20 The /IRQ band is fourteen to twenty-one, and its middle is seventeen
    Making the console watch the line only where it can move, rather than
    every master half-step, shifted the whole band by one: a zero point
    moving. Seventeen is the middle of the band as measured after that, and
    the item now says the thing the magnitude implies, which is that more
    than half a CPU cycle is far too long for a wire and most of the slack
    probably belongs to where the core samples IRQ.
2026-09-20 Eight things the generators said that the bench had already measured
    Found by the readers who translated these pages into Japanese. All eight
    are a generator's line, so none of it is edited in the .md; the four
    tools are changed and the four documents re-rendered from them.
    **The head's LAN address was published.** The build guide's step 0.2 and
    the notebook's attempt 2 both quoted the run of 2026-09-08 12:41:14 with
    the address in it, and the site publishes both pages in two languages.
    One step earlier the same guide tells a reader to type
    socket://<pi>:6545, so the redacted form was already the convention and
    only the quoted run escaped it. bringup.redact_host is the one copy of
    the rule: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
2026-09-20 The hand-written pages fixed where the translation found them wrong
    Eleven documents, each defect confirmed in this repository before it was
    touched.
    Read and plainly wrong: the poll entry's seed is encyclopedia entry 7,
    the dispatch, not entry 3; the Mario page's cross-reference names its
    heading in full; the notebook shows every attempt, not only the
    successful ones; the cartridge page gets its paragraph break back; the
    build document's intro ends on a full stop, since what follows is a
    paragraph and not a list.
    Settled by the file itself: the port's supply is pin 5 on this console,
    measured 2026-09-09, and the meter step says so (pin 2 idles high and
    pin 3 low, which is what bringup's o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
2026-09-20 The v1 build sheet stops sending the trigger to a socket the scope does not have
    Two lines the last pass missed, both about the same measured fact: the
    DS1054Z has no external trigger input (MEASURED 2026-09-15), so the parts
    table and build step 7 now take the trigger into CH1, which is what the
    cheat sheet, the build guide and the bring-up tool already say.
    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
2026-09-20 The redactor stops carrying the address it exists to remove
    Its docstring used the real bridge host as the worked example, so the
    function that takes the address out of the published pages was about to
    publish it in the source. The example is now a documentation address
    (RFC 5737), and the behaviour is unchanged: check-bringup is 19 checks, 0
    failing, and redact_host still walks strings, lists and dicts.
    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
    [bringup.py]
2026-09-20 The colour phase was the subcarrier origin, and the quarter dot is a separate two samples
    `split-score`'s new measurement 6 names the origin on both sides, so the
    two items that were supposed to be one quantity can be told apart.
    The colour-phase item has its cause: the part's origin is 4 samples
    ahead of the model's on all three Duck Hunt records and equal on the
    Super Mario Bros. split, surviving the two-frame step in every case. On
    two of the three the part's origin equals the model's at F-1 and F+1
    exactly, which is what the item was reporting without a number.
    The quarter-dot item loses its outlier. The registration reads 4 samples
    on precisely the records whose origin is 4 adrift and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
2026-09-20 The origin difference swept over the bank: two divergences in the first eight frames, then rare ones
    Measurement 6 on eight records, each its own POWER ON: the menu's first
    two seconds reads 8, the Super Mario Bros. title and level read 0, and
    Duck Hunt's field reads 4. Three separate power-ons inside each group
    read the same number, so the part's power-on origin is reproducible and
    this is not a lottery the model could never follow.
    The count accumulates mod 3, which is why the middle of the range reads
    0 rather than something between 8 and 4: by latch 300 the model has
    missed three short frames, not none.
    The shape is the finding. The difference is already 8 by frame 8 and
    has not moved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
2026-09-20 The board check reports its verdict on an everyday run
    tools/rig-check.py computed the boards' comparison against the map, the
    "within half a hole" check, and then reported it only under --baseline:
    the check() call sat inside `if a.baseline:` with no else, so a normal run
    made the measurement, wrote worst_px into last-check.json, and printed no
    verdict. Only "frame dark" and "read failed" could fail a board. The
    comparison is the same in both modes, against the same map, so this was a
    lost branch rather than a rule: the call is now unconditional, which is
    what the tool's own docstring already described (check 3, anchors within
    6 px, half a hole at zoom 100).
    docs/rig.md carried a paragraph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
    [rig-check.py]
2026-09-20 The origin difference is the model rendering four frames late, then one window at a time
    `origin-walk` supplies what the previous entry said was missing: the
    model's per-frame parity and every frame its rendering state changed.
    Its origin at F agrees with split-score's measurement 6 on all three
    paths, so the two instruments check each other.
    The model turns rendering on at frame 11 and the part by frame 7. Two
    extra short frames on the part is exactly odd frames 7 and 9, which is
    the menu records' difference of 8. Each rendering-off window after that
    costs one more, taking the count to 3 on the Mario path and 4 on Duck
    Hunt, and the model's off windows are 32, 6 and 4 frames where one odd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
2026-09-21 A probe plan: seven measurements, in the order that spends an open console best
    The offer was to move the probes anywhere, the NES's own chips
    included, so this is what to clip where and what each position answers.
    Seven measurements, ordered so that a session with the console open
    does the ones that close something first and the ones that share a
    cartridge change together.
    Nothing here needs the SST39SF040 chips. Everything that does stays in
    calibration-plan.md.
    It names no pin numbers, on purpose. There is no cartridge pinout in
    this repository to check one against, and a pin number carried in from
    memory is the kind of claim this bench exists to avoid. Every signal
    identifies itself on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
2026-09-22 A gamepad is the console's hand, on the path the bridge already proved
    The bench's only hand was the original pad wired to the bridge's own
    lines, which needs somebody sitting at the breadboard. This adds a
    second: a pad paired to the Pi over BlueZ, read as an event device,
    every change of the eight buttons sent as one `SET hh`.
    Nothing in the signal path changes. `SET` already reached the console
    and the 2026-09-15 milestone walked all fifteen test bytes through the
    595 and the 165 to the console's own D0. What was missing was only
    where the byte comes from.
    It reads evdev rather than speaking Bluetooth, so the radio and the
    profile stay BlueZ's problem: a Classic DualSense and a BLE 8Bit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
    [bench.py, check-pad.py, headd.py, pad.py]
2026-09-22 Two defects on the pad adapter sheet, found by reading it to wire from
    The sheet is the drawing somebody builds the adapter from, and both of
    these would have been found with a soldering iron in hand.
    **The pin numbers were the S3's on a sheet offering the C6.** The
    header said "ESP32-S3-DevKitC-1 (or C6)" and then put the pad on GPIO4
    and GPIO5 and the mode switch on GPIO15. All three are strapping pins
    on the C6, which is the part actually on hand, and docs/wiring.md says
    in as many words that 8, 9 and 15 and also 4 and 5 are left alone. The
    sheet now carries the C6 map, which is the one
    firmware/bridge/bridge.ino ALREADY polls a pad on: GPIO2 latch, GPIO3
    clock, GPIO6 D0. So step 2 of th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
2026-09-22 An original pad as a BLE keyboard: the firmware, and the half of it that can be tested
    firmware/pad-ble: docs/pad-adapter.svg built. poll_pads() is
    firmware/bridge/bridge.ino's own pad poll with the same timings on the
    same pins, clocking both pads in one pass; behind it is a NimBLE HID
    keyboard instead of a shift register. Standalone, as asked: no Pi, no
    UNO, no bridge, no console. A pad, the C6 on hand, and two resistors.
    Compiles for the C6 with the installed esp32 core 3.3.11, 56% of flash
    and 5% of RAM. No external library: the core's own BLE library is
    NimBLE-backed and BLEHIDDevice is guarded for it.
    WHY A KEYBOARD, which was the question. A BLE HID-over-GATT keyboard is
    accepted by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
2026-09-22 The pad adapter gets the bridge's treatment: its own sheet, its right angles, and a check that holds them
    The bridge has a schematic, a right-angle wiring drawing, a parts list,
    a build order and gates that hold all of them to each other. The pad
    adapter had one sheet, no table anywhere, and two defects that survived
    in it because a drawing with nothing to be held to always agrees with
    itself. This gives it the same treatment.
    WHAT THE BENCH EYE SETTLED FIRST. The board on the breadboard is an
    ESP32-C6-DevKitC-1 v1.2, read at zoom 500 off its own silkscreen:
    RGB@IO8, where the S3 devkit puts that LED on IO48. Both boards carry
    two USB-C ports marked UART and USB, so the ports do not tell th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
2026-09-22 The colours were the same five; the breadboard sheet needs one fact this repository does not have
    Confirmed at the bench: the pad cable carries the same five colours as
    the bridge's, so the metered table stands unchanged and the listing
    given in another order was the set, not the pin order. Nothing in the
    drawings needed editing, which is the good outcome of having asked
    rather than picked one: the two readings disagreed on GND, CLK and
    OUT0, and the wrong one puts the console's clock on ground.
    MEASURED off the board eye, 2026-09-22: the devkit spans about columns
    37 to 56 of the middle breadboard, pins in rows B and I straddling the
    channel with A and J free, and a cut pad cable is stripp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
2026-09-22 The breadboard sheet, and the one fact it needed: the devkit's headers, read off the board
    C6_HEADER is MEASURED, from photographs taken by hand because the bench
    eye cannot resolve that silkscreen. Sixteen pins a side, each row read
    from the USB end. It lives once, in tools/breadboard.py, and the sheet
    is drawn from it.
    TWO FINDINGS IN THOSE SIXTEEN, both worth having before wiring:
    Every pin pad-ble needs is on ONE row. GPIO2, GPIO3, GPIO6, GPIO7, a
    3V3 and a ground are all on the row that reads NC G 5V 3 2 11 10 8 1 0
    7 6 5 4 RST 3V3, so no wire crosses to the other side of the board.
    And that row is a trap. GPIO4 and GPIO5 sit immediately beside GPIO6
    and GPIO7, with GPIO8 four along,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
    [breadboard.py, render-png.py]
2026-09-22 Four stale lines in the pad-ble document, three of them mine from yesterday
    public-41 boarded the page and read it properly, which is how these were
    found. The repository is the one copy, so they are fixed here and the
    roof re-pulls.
    THE CONTRADICTION THEY NAMED. The wire list says the lead colours were
    confirmed as the same five and that nothing needed changing; the closing
    open list still said they disagreed. The second was true for about four
    hours yesterday and I updated open-items.md and the wire list without
    updating the summary at the foot of the same document. The open list now
    carries the eye's inability to read a devkit silkscreen instead, which
    is a real open limit rather than a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
2026-09-23 A drawing package for pad-ble, TM-NESB-003, and the cover guard that two older sheets failed
    The pad adapter gets what the bridge has: six sheets, cover and index,
    the three drawings, the wiring list and the parts list, assembled into
    one PDF at exactly 0.75 pt per unit so an ANSI B page prints as 17 by
    11 inches. docs/package-pad-ble.json is the manifest; make-package.py
    globs docs/package*.json so it needed no code to be picked up.
    The cover says what the page says everywhere else, in the order that
    matters: it is a drawing and not a build, nothing about the circuit has
    been measured, and what HAS been measured is the board rather than the
    circuit. A printable that a builder carries to a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
    [make-package.py]
2026-09-23 docno and rev are an interface now, and the file that owns them says so
    The site's pull used to type TM-NESB-001's filename with its revision
    in it, so moving that package from rev N to rev P yesterday broke nine
    links at once. public-25 fixed the cause rather than the nine: their
    pull now reads docno and rev out of docs/package*.json and refuses to
    pull when a manifest names a file the package directory does not have.
    That is the better fix and it leaves us holding something we were not
    holding before. Those two keys are no longer local config that anybody
    here can rename: a repository that is not this one reads them, and a
    rename would break it silently, which is exactly the class of thin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
    [make-package.py]
2026-09-23 A superseded revision is not an archive: the package directory keeps only what its manifest names
    Fifteen revisions of TM-NESB-001 were publicly downloadable and
    answering 200 this morning, A through P. Only rev P was linked. The
    other fourteen were reachable by an old link or a search result, and
    nothing on them said superseded.
    Two of the revisions that matters for: this package's own history
    records "port pinout replaced by this console's measurement" and "R2
    and C4 on the 165's clock pin". So revisions A and B carry a port
    pinout this bench later disproved, and everything before K is missing
    the filter that stopped D0's own falling edge re-clocking the 165. A
    drawing that was wrong and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
    [make-package.py]
2026-09-23 The rev is read as a letter now, so it has to stay one
    public-25's end-to-end spec derives every earlier revision letter of
    each docno from our manifests and requires each to answer 404, which is
    what stops a withdrawn drawing coming back. That is a better guard than
    either of us had before, and it deepens what these two keys are: not
    just an interface, but one where the VALUE's shape is load bearing.
    So a rev has to stay a single sorting letter. "AA", a number, or "P2"
    would not break the link; it would quietly break the test that proves
    the superseded ones are gone, which is the worse failure of the two.
    Skipping letters stays fine: there is no rev O here and a letter that
    never existed a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
    [make-package.py]
2026-09-23 The package PDFs are reproducible now, so a byte comparison is worth making
    public-25 corrected my reading: they ship byte copies of these files,
    not rebuilds. That made the 8 and 5 byte differences I waved away a
    question about this side, and they were right to ask.
    The answer was worse than the sha I guessed at. Two builds of IDENTICAL
    content at the SAME commit came out with different bytes, because cairo
    stamps /CreationDate into a PDF from the wall clock. Same size,
    different md5. So a byte comparison was useless in both directions: a
    published PDF could differ from a fresh build while saying the same
    thing, and could say a different thing while being the same size.
    Fixed by stamping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
    [make-package.py]
2026-09-23 A build record beside each package, so a stale PDF cannot cross in silence
    docs/package/ is gitignored, so a checkout of this repository has no
    PDFs in it: the site's pull copies them out of a working directory on
    this machine, byte for byte, and never builds. public-25 said so
    plainly when I asked instead of inferring a second time.
    That is fine until a sheet changes without a revision bump. The file
    keeps its name, so their missing-file refusal never fires, and a stale
    drawing ships in silence. Nothing inside a PDF says which commit built
    it.
    So the build now writes docs/package/<docno>/built.json beside what it
    wrote: file, docno, rev, pages, sha256, commit, epoch, dirty. Four
    things ca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
    [make-package.py]
2026-09-23 A post-commit hook does the rebuild, so the obligation is not a thing to remember
    The README's four-step order works and depends on a person doing steps
    two and three every time. This does them.
    tools/post-commit-hook.sh rebuilds all three packages and runs --check
    after each commit, about 7 seconds measured, printing one line when
    they agree and the refusal when they do not. tools/install-hooks.sh
    symlinks .git/hooks/post-commit at it, so the tracked file is the one
    that runs and there is no second copy to drift.
    WHAT IT DELIBERATELY WILL NOT DO. It cannot block a commit and does not
    try: git ignores a post-commit hook's status and the commit already
    exists by then. It never amends or rew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
2026-09-23 The hook's refusal leads with the line that answers, not eleven lines of traceback
    Proved the branch rather than trusting it, and what came out was the
    AssertionError at the bottom of eleven lines of Python stack, at the
    bottom of a commit, which is where nobody reads. The line that says WHY
    is always the last one; everything above it is how the code got there.
    So a build refusal now prints one line, the one that names the cell and
    the column it does not fit, and points at the command to run for the
    whole of it. A check refusal drops make-package's own summary line,
    which says nothing a reader does not already know from the heading
    above it.
    Both remaining branches proved the same way. A m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
2026-09-24 The second pad comes off: a keyboard report has six key slots and it was never sent
    The person holding the cable asked why a standalone Bluetooth keyboard
    for a phone had two controllers on its drawings, and the answer was
    that I carried J2 over from pad-adapter.svg without re-reading what I
    had written two paragraphs above it.
    What I had written was that this sheet exists SEPARATELY from
    pad-adapter "for the same reason bench-v1b is separate from bench-v1: a
    drawing somebody builds from has to show the parts they have". Then I
    drew a second pad they do not have. One cable is cut and stripped on
    the bench; the other controller is wired into port 1 for the bridge.
    The eye photographed the ev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
2026-09-24 Every check, not the four I would have picked: a stale parts list reached a push
    The site's pull refused c2ed0ca because tools/parts.py --check says
    docs/parts.md is not current. It was right. Taking the second pad off
    the sheets removed R2, docs/parts.md is generated from those sheets,
    and the row "R2 | 10k | PAD2_D0 to 3V3" stayed behind.
    I ran four gates before pushing: check-sheets, make-package --check,
    check-pad and test-pad-keymap. This repository has fourteen. The one
    that would have caught it was not among the four, and it was found at
    the far end of a cross-repo pull instead of here, which is the wrong
    end of the rope.
    THE FAILURE WAS NOT FORGETTING A COMMAND. It was choosing a s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
2026-09-24 check-all gains the ERC gate, and the flag that makes it a gate at all
    The roof's pull was carrying `netlist.py --erc` by hand because this
    file did not have it. That is the same choose-a-subset habit with
    somebody else's name on it, which is the thing check-all.sh exists to
    end, so it belongs here and now is.
    THE --erc IS LOAD BEARING and reads like a verbosity flag, which is
    worth a comment in the file: netlist.py returns 1 only when it is
    given. Run plain it prints "1 ERC error(s)" and exits 0, so adding it
    without the flag would have added a check that cannot fail, which is
    worse than not running it because it looks like coverage.
    Proved by planting a net with one end (C1's ground rena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
2026-09-24 The sheet's own summary stops saying a second pad is polled, because it is not
    Found by reading the rev B PDF before handing it over, which is the
    only reason it was found at all. The circuit on the sheet is right: one
    pad, one pullup, GPIO2, GPIO3 and GPIO6. The band along the bottom
    still said "Pad 2 is polled and printed so its wiring can be proved",
    which stopped being true in the same commit that took the pad off.
    Same failure as the "Two drawings of one circuit" line above three
    images yesterday, and the same cause: editing a document in pieces and
    not re-reading the parts that summarise the pieces. I corrected the
    firmware comment and the build document and did not re-read the
    drawin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
    [draw-schematics.py]
2026-09-24 The devkit's header rows were drawn swapped, and two of the wrong pins were its UART
    The owner wired the board from this sheet, the serial port answered
    nothing, and the reason is that every address on the breadboard sheet
    was on the wrong header.
    HOW IT HAPPENED. The header photographs show one edge of the board at a
    time and say nothing about WHICH edge. I worked that out by rotating
    the strip in my head, got it inverted, and wrote it into C6_HEADER as
    fact with a comment that said it was measured. The reading of the pin
    ORDER was right and is unchanged; the reading of which row carries it
    was wrong.
    HOW IT WAS SETTLED, in one sentence from somebody holding the board:
    with the antenna fa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
    [breadboard.py]
2026-09-24 ModemManager off the bench's serial ports, and it was not the culprit
    Flashing the pad-ble C6 failed with "no serial data received" on every
    reset mode, with a new cable, with the board bare and off the
    breadboard. Looking for why turned up ModemManager active and enabled
    at boot on the head, which probes every tty that appears with AT
    commands for tens of seconds looking for a cellular modem. That probe
    window is exactly when a flash wants the port, and it is a known cause
    of this exact symptom.
    So it is fixed: head/99-nes-bench-serial.rules sets ID_MM_DEVICE_IGNORE
    for the four things this bench plugs in (the C6's CP210x bridge, the
    OSCR's CH340, Espressif native USB, the UNO), ModemManag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
2026-09-24 Which ESP32 does BLE, which does USB, measured not recalled
    The question was whether anything else in the drawer does Bluetooth,
    and whether a USB-C cable to a phone is possible instead of a radio.
    Answering it from memory is how a pin map for the wrong chip got onto
    a sheet in the first place, so this reads the vendor's own soc_caps.h
    for all eight targets the Arduino core ships and prints the table.
    What it settles: SOC_USB_OTG_SUPPORTED is the line, and it is the
    literal preprocessor condition the core wraps USBHIDKeyboard in, so on
    a C6 that class is an empty file rather than a missing library. The
    C6's USB-C socket enumerates and still cannot be a keyboard, because
    SOC_USB_SERIAL_JTAG_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
2026-09-24 The P4 die has no radio, the module on this bench carries one
    The board turned out to be an ESP32-P4-Module, ESP32-P4NRW32, and its
    silkscreen says 802.11ax. That word is the tell: Wi-Fi 6 means a
    second Espressif part inside the can, and the core names it outright.
    CONFIG_ESP_HOSTED_CP_TARGET_ESP32C6, CONFIG_ESP_HOSTED_IDF_SLAVE_TARGET
    "esp32c6". The NimBLE host is built for the P4 and CONFIG_BT_ENABLED is
    y while CONFIG_BT_CONTROLLER_DISABLED is also y, which is the whole
    arrangement in two lines: the stack runs here, the radio is over there,
    HCI goes out over SDIO.
    The three BLE headers this project's firmware includes are gated
    #if defined(SOC_BLE_SUPPORTED) || defined(CONFIG_ESP_HOSTE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
2026-09-24 A device node is not an identity: the bridge gets a name
    Flashing the ESP32-P4 on the bench hub reset three unrelated devices
    at once. The UNO came back as ttyACM2, the head's unit was still
    pointed at ttyACM0, and headd reported active for eleven minutes with
    a dead bridge pump, the failure arriving as a SerialException in a
    thread nobody was reading.
    99-nes-bench-serial.rules gains a SYMLINK on 2341:0043, so the bridge
    is /dev/nes-bridge. The file already matched that vendor for the
    ModemManager opt-out, so this is one more line in a place that is
    already installed. Matching the PRODUCT rather than the serial keeps
    the board's own identity out of the repository and survives a swapped
    UNO;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
2026-09-24 Only the BRIO can be aimed in software, and now that is measured
    I told the user the QuickCam Pro 9000 had pan, tilt and zoom like the
    BRIO. Nothing in this repository recorded that, and I had not measured
    it. A camera got swapped partly on the strength of it. v4l2-ctl says
    the 9000 has no pan, no tilt, no zoom and no focus: its controls are
    the Communicate Deluxe's list minus privacy. Only the BRIO has all
    four, which is why eye.py is written against the BRIO alone.
    So rig.md gains the table, measured on all three, with the point
    stated: a side eye is chosen for its sensor and framed by hand. The
    9000 is 1600 by 1200 against the Communicate's 1280 by 960, and
    neither can be pointed from he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
2026-09-24 The P4's header, read from the drawing that defines it
    The board that works gets the pad. Waveshare's own schematic for the
    ESP32-P4-Module-DEV-KIT, connector P6, rendered at 900 dpi and read at
    a zoom where the wire leaving each pin is unmistakable. Not off the
    silkscreen in a photograph, which is available and legible and is
    exactly how this document shipped four revisions with the C6's two
    header rows swapped.
    An Altium schematic draws each net label ABOVE the wire it names, so a
    whole column reads one row out and still looks plausible. Two counts
    settle it and tools/p4_header.py asserts both: each column must come
    out at exactly 20 pins with nothing left over (the wrong reading
    leaves t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
    [cheatsheet.py, p4_header.py, pad-ble.ino]
2026-09-25 The P4 gets its own drawings, and three lead colours were wrong
    THE CORRECTION FIRST, because it shipped. Rev E's wire table said GND
    black, CLK yellow, LATCH blue. The cable was rung out on 2026-09-09
    and tools/bringup.py has held the answer since: GND is YELLOW, CLK is
    BLUE, OUT0 is BLACK. Only D0 green and +5V red were right, and those
    two were luck. The owner had said "same five colours as the bridge,
    Black, Yellow, Blue, Green, Red", which is a set and not an order, and
    I assigned them to nets by guess and typed the guess into a document
    that went live.
    So PAD_COLOUR is no longer a table. p4_header.pad_colour() reads
    bringup.LEADS, a pin it cannot find raises rather than guesses, and
    c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
    [breadboard.py, check-sheets.py, draw-schematics.py, netlist.py, p4_header.py, parts.py, render-png.py, wiring-diagram.py]
2026-09-25 A reproducible build printed an irreproducible date
    The site session served rev F at a sha that did not match the one this
    session had quoted hours earlier. HEAD had not moved, the tree was
    clean, and both files were real. The whole difference, in twelve
    places, was one digit: 2026-09-24 against 2026-09-25.
    SOURCE_DATE_EPOCH was added on 2026-09-23 so a given commit builds a
    given PDF, because the site ships byte copies and a byte comparison is
    only a signal if it can be trusted. It fixed cairo's /CreationDate and
    left the date PRINTED in every title block as date.today(), so the
    same commit rebuilt on a different day produced a different document.
    That is worse than not being reproducible: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
    [make-package.py]
2026-09-25 GPIO37 and 38 are the console UART, and nothing on the board says so
    Every other reserved pin on P6 was found by reading what the SCHEMATIC
    wires it to: the C6's reset, the SD card's power switch, the speaker
    amplifier, a strapping pin, the USB pair, the codec's I2C. GPIO37 and
    GPIO38 are wired to nothing on that sheet, so a scan of its nets
    passes them as free. They are the P4's own UART, printed TXD and RXD
    on pins 7 and 9, and with cdc_on_boot=0 that is where Serial goes,
    which is every byte of every bring-up on this bench.
    Taking them costs the INSTRUMENT, not the circuit, which is why the
    method that found the other eight could not find these two. A pin can
    be spoken for by the way we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
    [header-probe.ino, p4_header.py]
2026-09-26 The five holes are a run, which is how it should have been said
    The ESP32 side is wired and MEASURED: firmware/header-probe named the
    hole each wire is actually in, and the three signals sit on P6 pins
    16, 20 and 22, GPIO6, GPIO3 and GPIO2. Not counted from a photograph.
    Getting there took two corrections, and both came from wiring by pin
    number. Yellow went into SCL, pin 6, which the board pulls up itself,
    so the clock would have fought hardware and the symptom would have
    been silence with nothing to see. A grey went into 0, pin 24, one hole
    past the latch. The probe caught the first by saying NOTHING, since a
    reserved pin is not in its table, and the second by naming GPIO0.
    What the owne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
    [cheatsheet.py, draw-schematics.py, p4_header.py, wiring-diagram.py]
2026-09-26 pad-usb: the same pad as a USB keyboard, on the part that can
    THE BLE BUILD CRASHES ON THIS BOARD AND IT IS NOT OUR CODE. The P4 has
    no radio; its radio is an onboard ESP32-C6 over SDIO. The host's
    esp-hosted 2.12.11 asks that C6 for its firmware version, gets no
    answer, and the failure path reads a pointer nobody filled in. Always
    2881 ms after BLEDevice::init. Five explanations were tested and
    eliminated: build options and PSRAM, the security block, a delay
    before init, a delay after init, and our own GPIO setup. The radio
    probe hits the IDENTICAL timeout at the identical latency and lives,
    which is what says what kind of bug it is: the garbage it reads
    happens to be harmless in that binar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
    [check-sheets.py, keymap.h, pad-usb.ino]
2026-09-26 Rev I: the build is USB, and the document says why
    TM-NESB-003 is retitled "Original pad to a USB or Bluetooth keyboard"
    because it is one now and was not before, and saying so on the cover
    is cheaper than a reader discovering it on sheet 5.
    The direction changed twice and both moves were forced by measurement.
    The C6 never accepted a flash, so the board became a P4. Then the BLE
    firmware turned out to crash on the P4: the host's esp-hosted 2.12.11
    asks the module's onboard C6 for a firmware version it never answers,
    and the failure path reads a pointer nobody filled in, always 2881 ms
    after BLEDevice::init. Five explanations tested and eliminated. A
    smaller sketch survives the identical ti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
    [draw-schematics.py]
2026-09-26 A gate for the heading rule, because a note was not one
    The site session gave the pull list: 22 documents, each with the slug
    its Japanese shadow is named after, which is THEIRS and not our
    filename, so pad-ble-build.md is held against pad-ble.md over there.
    Two broken deploys in one day taught the rest. parts.md gained a
    heading and stopped their build; a note went into the README naming
    parts.md; hours later pad-ble-build.md gained six headings and stopped
    it again, because the note had named the instance and not the rule. A
    third note would have been the same bet.
    So tools/check-pulled-headings.py records the count of every pulled
    document and refuses when one moves, naming the file, th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
    [check-pulled-headings.py]
2026-09-26 The list is called DOCS, and a wrong pointer is worse than none
    Three places recorded it as NES_DOCS: the tool's docstring, the record
    it reads and the README. The site session corrected it and I checked
    their file rather than take it on report: const DOCS at line 141 of
    web/scripts/pull-nesdocs.mjs. A pointer to a symbol that does not
    exist sends the next reader looking for the wrong thing in the right
    file, which is worse than no pointer at all.
    Two things the check also turned up, now recorded: their DOCS covers
    several repositories and not only this one, so the 22 here are this
    repository's rows of it rather than the whole list; and they have put
    a comment at that list saying a new nes-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
    [check-pulled-headings.py]
2026-09-27 Rev J: the first pad was a replica, and colours are not signals
    The USB build read B 00 and pressing A changed nothing. Every
    connection was then proven before the pad was suspected: the ESP side
    hole by hole with header-probe, the junction by the owner's list, 3.3 V
    on both rails and at the pad's supply and latch leads, a real 10k on
    D0, and pad-diag holding the latch high with D0 never moving. Then the
    owner recognised the controller: a cheap replica, the same brand as
    the bridge's pad, which works there at 5 V. Very probably a 5 V-only
    clone chip. Not measured: nobody has put it on 5 V alone.
    So measure-first item 4, which asks about an ORIGINAL pad, is still
    open. The owner opened one a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
2026-09-27 A correction changes no heading, so the gate cannot see one
    The site session found the Japanese pad-ble table still carrying rev
    E's three wrong lead colours, live, four revisions after the English
    was fixed. I had announced the rev E correction but framed it around
    the PDF; the same table in pad-ble-build.md was corrected in English
    without saying so. No heading moved, so the heading gate stayed quiet,
    the site's deploy did not block, and the translation kept the wrong
    fact.
    The README said "prose may change freely; only headings block their
    deploy". True about deploys and misleading about correctness, since a
    correction is exactly the change that blocks nothing. It now says so,
    with this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
2026-09-27 Rev K: J1 is drawn as the original pad, in its own colours
    The owner sent rev J back. I had been asked to add the new wiring plan
    to the PDF and I added a TABLE and three captions, while every drawing
    kept the replica's colours at J1. Worse, the wiring sheet labelled J1
    "the plug half of an original pad" in the replica's colours: the exact
    collision the new section warned about, drawn.
    Now all three P4 drawings show an ORIGINAL pad at J1, from one source:
    p4_header.og_lead_by_pin() reads OG_PAD, so the drawings and the
    header sheet's table cannot disagree.
    1 GND brown 2 CLK red 3 OUT0 orange 4 D0 yellow 5 supply white
    Still Nintendo's documented scheme and marked NOT measured on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
    [breadboard.py, draw-schematics.py, p4_header.py, wiring-diagram.py]
2026-09-27 A page for the pad's protocol, button to keystroke, and it is not a boot keyboard
    docs/pad-usb-protocol.md: the four layers between an original pad and a
    host (the 4021's latch, clock and data; the byte as an 8-byte key
    report; the 65-byte report descriptor; USB enumeration), then the host's
    keydown, and the plan as seven steps that each prove one layer. The
    example reports are pad_report()'s own output compiled on the desk, and
    the USB descriptor table is read out of esp32 core 3.3.11.
    Reading that core corrected a claim: keymap.h and pad-ble-build.md
    called this a boot-protocol keyboard. The report layout is the boot
    layout, but the report carries an ID and USBHID's default interface
    decl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
    [keymap.h]
2026-09-28 The pad reaches a host: an original at 3.3 V, full-speed USB, every key
    Measured on the bench 2026-09-27, in the protocol page's order:
    - An original pad (genuine MN4021B) answers at 3.3 V: pad-diag saw A
    drive D0 low 27 times in 30 s. Measure-first item 4, open since
    2026-09-07, is closed. The first try failed on a 10 ohm part fitted
    as the 10k data pull-up, which the 4021 cannot pull down.
    - pad-usb's clocked poll reads all eight bits, 01..80, and chords.
    - The Pi enumerates 303a:0002 tinymachines NES Pad at full speed and
    receives A KEY_X, B KEY_Z, Select KEY_RIGHTSHIFT, Start KEY_ENTER and
    the four arrows, chords included.
    pad-usb now drives TinyUSB itself on the P4's FULL-spe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
    [p4_header.py, pad-usb.ino]
2026-09-28 The notebook says what is built: v1 complete, the pad adapter proven, rev L
    A sweep of every page, drawing and package against the bench as it
    stands on 2026-09-28. Nothing measured changed; what changed is
    prose that was written before the thing it describes was built and
    never dated afterwards.
    The bench. README, bench-report, wiring, bench-plan, bench-build,
    bench-v1b-uno, the milestone, as-built, rig and script.md all said or
    implied the bridge was not built, or described the ESP32-C6 plan as
    the bench. The bench is v1b on the UNO, joined 2026-09-15, hands from
    the Pi 2026-09-17; each page now says so where it said otherwise, and
    the milestone's four "next" items carry their dates. The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
2026-09-28 The site pulls three cart pages the gate did not know about
    The roof deploy of cc17f04 reported 17 drifted shadows, not 14: build-the-cal-cart, calibration-plan and cart-blanks are pulled too, in its cart section. The README said the list grows and a newly pulled file cannot be caught here; this is one of those, caught from the other end. Their slugs are our filename stems until the site session says otherwise.
2026-09-28 The fourth cart page, and the slugs confirmed
    The site session confirmed the cart slugs are the filename stems, shadowed under docs/ja/cart/, and named calibration-screens as the fourth pulled cart page. The record says so and the guess note is gone.
2026-09-28 Step 6 passes: a browser sees every button as its code, and the host's autorepeat as the host's
    Two runs of tools/keydown-page.html, served unlisted by the public site
    at /lab/pad-keydown, eight buttons each, pressed one at a time. Every
    press arrived as its code in the order pressed, every keyup after its
    keydown, nothing lost at 65 ms or at 500 ms held. The first run had a
    ShiftLeft held by something on the host across A and B, which the
    adapter cannot send (Select is ShiftRight and arrived as such), so A and
    B came through as X and Z: the layer-5 point in one record, code is the
    pad's and key is the host's. The one repeat line was the host's own
    autorepeat at 500 ms.
    The host is not yet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
2026-09-28 Step 7 ran on an iPhone: four buttons of eight move the game, and the cross is the host's
    A, B, Select and Start played on tinymachines.ai/nes/play from an
    original pad on the USB adapter; the cross did not. The phone keeps a
    hardware keyboard's arrows for itself unless a field is focused, which
    the step 6 page had allowed for and the emulator had not; the emulator
    now keeps one focused (public, playEngine.ts). Step 7 stays open until
    the cross moves after that change, the phone is named, and whether it
    powered the board alone with the UART cable out is written down. The
    count of steps passed stays at six.
2026-09-28 Step 7's host is named: an iPhone in Safari, and the cross moved a highlight round the frame
    The owner's observation from the other side of the same fault: with the
    pad's cross the phone moved a focus highlight around the page's outer
    frame, spending the arrows on its own focus navigation. Recorded in the
    table row, the open bullet and open-items; still open are the cross
    after the emulator's fix, and whether the phone powered the board
    alone.
2026-09-29 Step 7 passes: all eight buttons move a game on an iPhone
    The cross moved on the next try, after the emulator was given the
    off-screen focused input the step 6 page always had (public a3e2bf1,
    live). The table row, the intro and the open bullet say so; what stays
    open on the phone is whether it powers the board alone with the UART
    cable out, and step 6's host. Seven of seven steps passed.
2026-09-29 The BLE pad advertises from a second C6, and the sketch's own fault is fixed
    A different C6 board, plugged into the bench head, took firmware/pad-ble
    over its USB-Serial-JTAG with esptool on the first attempt, and the
    Pi's radio heard it advertising as NES Pad. Two corrections on the way:
    hid->manufacturer(name) wrote through a characteristic pointer that only
    manufacturer() creates, a load access fault at the first byte of
    setValue on every boot, which the P4 never reached because it crashes
    inside BLEDevice::init; and the C6 build needs CDCOnBoot=cdc or Serial
    goes to the UART pins and the USB socket looks like a sketch that hung
    before its first print. Neither a pad nor a phone has met th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
    [pad-ble.ino]
2026-09-29 pulled-docs: esp32-part-choice has its Japanese shadow on the site now (2026-09-29), so its 14 headings are held like the rest
2026-09-29 tools/pi-esp32-setup.sh: a Pi 5 becomes the ESP32 test platform in one run
    Installs the toolchain the pad firmware was proven with (esp32 Arduino
    core 3.3.11, arduino:avr 1.8.8, esptool) plus a Rust side (stable and
    nightly with the RISC-V targets, espflash, espup for the S3's Xtensa
    fork, the generators) and ESP-IDF v5.5.1 for six targets; hands serial
    and raw USB to the user by udev; idempotent. Its --verify builds pad-ble
    for the C6 and pad-usb for the P4 with the fqbns the sketches record
    and fails unless each yields a plausible image. Proven 2026-09-29 on a
    Pi 5 running Ubuntu 26.04: both sketches build there, pad-usb at the
    same 386576 bytes as here.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
2026-09-29 cartridge.md: the one-bank read was whole, not half FF
    The first read of the multicart (dump 54) is bank 0 entire, PRG and
    CHR, one percent FF; what makes it match nothing is the board's bank
    switch in the game's first nine bytes. Checked against the bytes
    2026-09-29.
2026-09-30 pad-ble on a classic ESP32: the dead C6's stand-in advertises, with its own pin block
    The DevKitC-1 gave no ROM banner on either socket under any reset, so
    an ESP32-WROOM-32 devkit took the BLE build. The C6 map cannot be used
    there: GPIO6, 10 and 11 are the module's flash lines and GPIO3 is the
    console's receive pin, so the classic build polls GPIO25, 26 and 27,
    keeps the mode switch on GPIO4 and lights the devkit's own LED on
    GPIO2. Built for esp32:esp32:esp32 at 83% of the app partition, flashed
    from the bench head as one merged image, it boots, prints the key map,
    advertises as "NES Pad" and the head's own radio hears it.
    BLEDevice::init does not crash on this part. The pad is not wired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
    [check-sheets.py, pad-ble.ino]
2026-09-30 pad-ble: FORGET clears bonds on Bluedroid too, and the bench head is the build's first host
    On the classic ESP32 the core is Bluedroid, where there is no store to
    clear in one call; FORGET printed rc -1 and cleared nothing there. The
    bonds are listed and removed one by one now, and the count is printed.
    Measured on 2026-09-30 with the bench head as the host: with one bond
    stored FORGET answered that one bond was stored and rc 0, the head's
    next connect fell to Connected: no, and a third pairing bonded again.
    The other way round, a reflash of the merged image blanks the board's
    bond store while the head stays bonded and reports a connection with
    nothing behind it, bluetoothd's HID read errors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
    [pad-ble.ino]
2026-09-30 The classic ESP32 gets its own drawings: three sheets, a header page and the module they are built from
    tools/esp32_header.py is the ESP32-WROOM-32 devkit's two header rows,
    read off the owner's photograph of the board on its breadboard on
    2026-09-30, with the breadboard rows 6 to 20 as that photograph shows
    them, the four pins already spoken for (TX0 and RX0 are the console,
    D12 and D15 are strapping pins), the four input-only pins, what never
    reaches the header, and the self-checks check-all.sh now runs. The
    sheet "pad-ble-esp32" is registered everywhere "pad-ble-p4" is:
    pad-ble-esp32.svg, wiring-pad-ble-esp32.svg and
    breadboard-pad-ble-esp32.svg, whose column numbers are the
    photograph's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
2026-09-30 The calibration cart's build gets its own record: the first chip is written, and the board's jumpers are read
    The flash chips reached the bench. docs/cal-cart-build.md is the record
    of the build as it goes: the programmer on the bench Pi under minipro
    (the GitLab tree; the GitHub one of the same name does not know the
    TL866II Plus), chip 1 through two wrong seatings to its own ID, then
    prg.bin written and the whole chip read back equal to the image; the
    discrete mapper board's jumpers for NROM read off both sides of its
    silkscreen (five bridges); the parts the board takes; and what the rest
    of the pile is.
    The mirroring jumper's letters are backwards on this board and its
    words are right: v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
2026-10-02 The lockout gets a page, a procedure and a measurement; the cart's first board gave a gray screen
    The calibration cart has no lockout chip, so it runs only on a console
    whose lock is defeated, and that had been taken on the owner's word
    since 2026-09-14. docs/lockout.md is what the modification is (nesdev's
    pin 4 method, with the meter readings that make the wrong pin hard to
    cut), how it goes wrong, and how a keyless cartridge tells the two
    states apart by eye: a live lock blinks at about a second, so a steady
    gray is not the lock.
    tools/lockout-check.py reads the answer off the reset line: twelve
    seconds hands off, twelve with one press of Reset, because a supply
    rail also sits high and a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
    [lockout-check.py]
2026-10-02 The gray screen was steady: by eye the lock is not acting, and the board is the fault
    The owner's report of the 2026-10-01 power-on: steady gray, not
    blinking, with a keyless cartridge in the slot. A live lock blinks a
    keyless cartridge at about a second, so the modification holds by eye
    and the gray belongs to the first board. Recorded in the procedure's
    observations, the lockout page, the build record and the open items;
    what would make it a measurement (a photograph, the meter, the reset
    line) stays open.
    The site took lockout.md (slug lockout, cart section), so it has a row
    in pulled-docs.json. No heading counts change; the site session was
    told before this was pushed.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
2026-10-02 cal-cart-build: the second board as a checklist, in the order it is soldered
    The jumper table and the parts table as one list to work down at the
    bench: six parts and where each goes, the five bridges, what stays
    open, the order (bridges, ceramics, sockets, electrolytic), the meter
    readings before a chip goes in, and the reader before the console. The
    iron is given as advice and labelled as such. One heading more (11 to
    12); the site session was told before this was pushed.
2026-10-03 cal-cart-build: the second board reads 21091B99 on the reader
2026-10-03 cal.py reads the grabber's two fields apart, and the strip reads off the part
    The grabber's 480 lines are not the 240 picture lines doubled: it weaves
    two fields, and the console sends a whole frame each field, so the even
    lines are one console frame and the odd lines the next. Averaging line
    pairs mixed the two strips, the frame counter's fast bits read grey, and
    every real frame was refused. Each field is now read on its own.
    The selftest's synthetic grabber weaves two different pictures; the old
    averaging reader fails it 16 of 16. On the console, six grabbed frames
    give twelve fields that all read, screens 2 to 7 in order.
    [cal.py]
2026-10-04 pad-ble sends an unnumbered report, so BlueZ 5.66 cannot drop it
    On the bench head the kernel received every BLE report as
    "00 00 1b 00 ..." with no ID byte and parsed none of them: BlueZ 5.66
    sets a report's numbered flag at UHID_START, which a cached report map
    reaches before the Report Reference reads (01 01, read correctly). With
    one input report the ID buys nothing, so the BLE build declares none.
    The USB build keeps ID 1; the header is shared, so the ID is the
    build's define and the desk test runs both.
    [keymap.h, pad-ble.ino, test-pad-keymap.cpp]
2026-10-04 The BLE pad plays on an iPhone, and says what a host did
    An original pad on the classic ESP32 at the Pi's 3V3 reads all eight
    buttons one bit each; the bench head types X, Enter and Right once the
    report is unnumbered (9aa74c1); the owner played a game on an iPhone
    over BLE. The sketch now logs the pairing result, the host's CCCD
    write, report delivery and the disconnect reason, which is what showed
    the phone doing every step. Which change the phone needed is recorded
    as not separated.
2026-10-06 The pile has its own page: three ESP32 boards and two opto boards, read off the photographs
    docs/pile.md indexes gear for new projects, keeping what was read off
    each part apart from what its family's documentation says. The Stamp
    P4 is very likely LITTLEGUY (a P4 with no buttons, its one socket taken
    by pad-usb); the Iso_817_X1's input resistor reads 1 k. The C6 DevKitC
    is the board that died on 2026-09-29, set aside. The C6 LCD board is
    measured (an ESP32-C6FH8 with 8 MB of flash in the package; the vendor
    wiki says 4) and has a job: the TRNG emitter.
2026-10-06 An HP-16C joins the pile: the 6502's integer arithmetic, from a witness that shares nothing with the simulator
    Read off the bench camera, front and back: the keyboard, the reference
    card moulded on the back, and a serial prefix of 2447A (1984, week 47,
    USA). The display was blank; not yet powered here.
2026-10-12 pad: one sketch for USB and BLE, and the slave image for the P4's C6
    firmware/pad folds pad-usb and pad-ble together (nes-bench#4): one
    poll, two sinks, the live sink following the host (configured within
    1.5 s = USB, otherwise BLE; a host gone 2 s hands back; the mode switch
    forces BLE). keymap.h now writes the descriptor body once and defines
    both shapes, PAD_HID_DESC_USB (ID 1) and PAD_HID_DESC_BLE (no ID), and
    tools/test-pad-keymap.sh holds the two to differ by exactly the Report
    ID item: 82 checks per ID, 24 failures mutated. pad-usb and pad-ble
    compile unchanged. The merged sketch compiles for the P4 and the S3 and
    has met no board.
    On the P4 the sketch asks the onboard C6 its esp-hos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
2026-10-13 pad-s3: drawing package TM-NESB-004 for the XIAO pad with a cell (nes-bench#6)
    The one-pad circuit on the P4 is closed (nes-bench#4: an iPhone typed
    from the pad over BLE and a laptop over USB, one binary; docs/pad-build.md
    and open-items say so). The next one is the small build: the same sketch
    on a Seeed XIAO ESP32S3 with the 2000 mAh cell on its own charger.
    TM-NESB-004 rev A is its record, three sheets from tools/draw-pad-s3.py:
    the system (the pad, the XIAO, the cell, the sink rule), the XIAO's pins
    read from Seeed's map with the strapping pins named, and a progress sheet
    where every row is marked authored, compiles, measured, next or open and
    moves as the bench says. tools/check-pad-s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
2026-10-17 v1c's schematic: v1b as a printed shield, the hands on board
    Five sheets. Sheets 1 and 2 are v1b's bridge under v1b's references,
    the console port and pad socket now on keyed housings; check-sheets
    holds all 73 of v1b's nodes to the same nets on v1c, and wiring U2's
    clock past R2 makes it fail. Sheet 3 puts a test point under every
    scope probe, and one on U2 pin 2 after the filter, the probe that
    would have found R2 one row off on 2026-10-16. Sheets 4 and 5 are the
    hands as bare parts: a PC817 from GPIO17, and an SRD-05VDC driven by a
    2N3904 from GPIO27 with its flyback diode and boot-time pulldown.
    The Pi's ground is its own net, PI_GND, and check-sheets refuses a
    board that joins it to GN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
2026-10-17 export-netlist: v1c's footprints, the UNO's own pads, and --sheet
    v1c's A1 is a shield, so its pads are the UNO R3 footprint's
    (A1_SHIELD), all three GND pads joined; v1b and v2b keep the ribbon's
    A1_HEADER and write the same files they did. The cables get Molex
    KK-254 housings: keyed by the ramp, at the 0.1 inch pitch the bench's
    leads already have. --sheet writes one sheet's files, so making v1c's
    does not rewrite v1b's and v2b's dates.
2026-10-17 The v1c board: an UNO shield, placed, routed, and the routing a file
    make-pcb.py and route-pcb.py take --sheet; v2b is the default and
    builds the same board it always has (rebuilt on 2026-10-17: the
    .kicad_pcb byte for byte, the fabrication set differing in its date
    stamps only). v1c is the UNO's 68.58 by 53.34 mm outline carried on to
    100 mm. A1 is the UNO itself: its pads are the headers, its silkscreen
    is dropped, and A1_SHIELD is held to the footprint's geometry
    (MUTATE_SHIELD swaps D7 and D8 and is caught). Three keepouts, rule
    areas the router honours, over the barrel jack, the USB corner and the
    328P's ICSP header.
    Routed by freerouting 2.1.0 with the power contact's nets in a class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
2026-10-17 docs/bench-v1c.md: what v1c is, what is checked, what to look at before an order
    Not ordered, not built. The parts the shield adds and why, the two
    grounds and what one board changes about them, the routing's numbers,
    and three things for the owner: K1's NO and NC pin numbers, R3's value,
    and the headers' height. The enclosure, the fab house and the quantity
    stay open.
2026-10-17 v1c ordered: the relay's NC metered on pin 4, five boards from JLCPCB, and the parts for one
2026-10-17 PLAN: a Super Mario Bros. schedule searched on the model, backtracking by segment; it cleared 1-1 on the part
    Searched in segments of 30 latches, 13 moves each, six at a time, with
    backtracking; four backtracks around x 2020. The 71-entry plan reached
    the flagpole on the model at latch 2190 (state 04, measured) and 1-2 at
    2820, and played on the part through the head (run 20261017-224132),
    grabber frames at 700, 1300, 1900 and 2200 showing the same run to the
    flagpole.
2026-10-17 PLAN on saved states: 1-2 cleared on the part, one schedule from power-on to WORLD 1-3
2026-10-18 PLAN: 1-3 cleared on the part, power-on to WORLD 1-4 in one schedule
    Two rules from the treetops: keep a move only when a continuation lives,
    and keep the continuation that found the flagpole.
2026-10-18 PLAN: 1-4 cleared on the part, power-on to WORLD 2-1; a castle ends at the axe ($0770 = 2)
2026-10-18 Streaming: the UNO's schedule is a ring and the head feeds it during the run, so a run is no longer bounded by 600 entries
    The firmware frees a slot as its entry applies and refuses an AT whose
    latch has gone ("# late AT n at latch L"); the head loads up to
    SCHEDULE_ROOM (480) before the console leaves reset and streams the rest
    from pump_bridge, mirroring the bridge's slots from the L stream with the
    firmware's own cost rule, and stops a run that falls behind or ends with
    lines unsent. The fake bridge mirrors the ring and the refusal.
    Proven: test-uno-schedule adds 200 streamed schedules of 300 to 900
    changes through a 64-slot ring and the real 2-1 plan streamed, 603 cases
    green; MUTATE re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
2026-10-18 bench-language: 3-2 cleared on the part, power-on to WORLD 3-3
2026-10-18 The plan log: PLAN's level sequence as a notebook page, drawn from measurements
    docs/plan-log.md is the process (plan on the model, replay straight,
    count, play on the part, push) and one entry per level; tools/plan-log.py
    draws docs/plan-log-*.svg (the whole run, and per level Mario's path
    from the side with the buttons under it) and the table from
    docs/plan-log.json, the record (measured fields from the planner's log,
    the head's run and a check of every run's bridge.log: ten runs, no poll
    missing, none wrong; the lesson authored and labelled). The schedule is
    exercise/smb-plan.txt, button bytes only. The model trace the drawings
    come from is not committed, and no picture of the game is dra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
2026-10-18 PLAN: 3-3 cleared on the part with a beam search; the plan log grows to eleven levels
    3-3's way on is up, not right: depth first abandoned the high route
    segments before its dead end showed (a low mushroom where every move fell
    or was hit). --beam B keeps the B best positions a segment, distinct by
    area, x and height, and expands them all. Also a fourth continuation
    (wait, then jump) and a stall window of eight segments. Planned in about
    28 minutes, 587 entries; run 20261018-061315 to WORLD 3-4, 25,851 polls,
    none wrong. The run before it (20261018-060411) failed on the part, not
    the plan: a clean poll log while the console had restarted itself, the
    third time the console has misbehaved on i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
2026-10-18 PLAN: 3-4 cleared on the part, the plan log to twelve levels
    One schedule from power-on, 618 entries, through the third castle to
    WORLD 4-1 with no life lost: run 20261018-145621, 27,683 polls checked
    against the script after the final reset, none wrong, none missing.
    The first 3-4 plan failed its straight replay: nes branch's RUN stopped
    at a frame's end and a two-poll frame made one AT late on the model
    (fixed in nes, RUN stops on the latch and a late AT is refused).
    Replanned from the same start in about ten minutes, no backtracks.
2026-10-18 PLAN: 4-1 cleared on the part, the plan log to thirteen levels
    One schedule from power-on, 662 entries, through Lakitu's level to
    WORLD 4-2 with no life lost: run 20261018-162219, 30,072 polls checked
    Planned depth first, 51 segments, no backtracks, about 21 minutes.
    The first bench run (20261018-161233) played every poll right but its
    intro frame came after POWER OFF (the script's end was ten polls past
    the grab); run again with the usual margin.
    plan-log.md is pulled: 16 headings now (recorded in pulled-docs.json),
    a new drawing plan-log-4-1.svg.
    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
2026-10-18 plan.py: what 4-2 taught (warps, the ceiling, height, A held, resume)
    4-2 defeated four plans before these:
    - A warp zone counts as a death: $06D6 reads 0 on the way and 5 in
    4-2's zone, where the beam ran over the ceiling into it and would
    have skipped World 4.
    - --no-ceiling: standing on the top row (y under 0x10, $001D 0; the
    floor is b0) counts as a death, the way over the ceiling.
    - --beam-high H: H of the beam's slots go to the highest positions
    reached standing. Ranked by x alone the beam kept Mario pressed
    against the last tall pipe and dropped the stair tops; ranked by
    height in the air it kept him jumping at the pipe's side.
    - A fifth way on in the lookahead keeps A hel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
2026-10-18 PLAN: 4-2 cleared on the part; a warp is a change to any but the next level
    One schedule from power-on, 730 entries, to WORLD 4-3 with no life
    lost: run 20261018-234630, 33,502 polls checked against the script
    after the final reset, none wrong, none missing.
    4-2 defeated five plans (docs/plan-log.md tells them). Its last tall
    pipe was crossed by a route searched by hand on the model from the
    beam's own stair-top state (wait, run 12, A 30, a second jump into the
    exit pipe), spliced on, and the planner resumed from outside the exit
    pipe to the flagpole.
    plan.py: the warp rule of f3cfbb2 read $06D6, which reads 1 on the
    real route beside the last pipe (32382 to 32467 in the straight
    replay),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
2026-10-19 PLAN: 4-3 cleared on the part
    One schedule from power-on, 767 entries, to WORLD 4-4 with no life
    lost: run 20261019-015500, 35,501 polls checked against the script
    The beam of 4-2 (--beam 4 --beam-high 1) crossed the mushroom tops and
    falling lifts on its own: 41 segments, 3178 s, nothing by hand.
    plan-log.md is pulled: 18 headings now, new drawing plan-log-4-3.svg.
    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
2026-10-19 plan.py: a castle maze's loop-back is a death
    4-4 sends Mario back to the start of its loop when he is on the wrong
    path at a checked page (the game's tables at $C06B: World 4 wants y $40
    standing when the screen draws page 5, y $B0 at page 9). Under his own
    control x jumps from page 4 to $FF and then 0, and the beam, ranking by
    x, took $FF as the furthest yet and went nowhere for 500 polls.
    x jumping more than a page between two polls with Mario his own is now
    a death. Over the straight replay from power-on to WORLD 4-4 (36,402
    rows, fifteen levels) it fires 0 times; on the loop-back it fires.
2026-10-19 PLAN: 4-4 cleared on the part; the maze's checks read out of the game
    One schedule from power-on, 796 entries, to WORLD 5-1 with no life
    lost: run 20261019-065615, 37,793 polls checked against the script
    4-4 sends Mario back to the start of its loop unless, as the screen
    reaches page 5, he stands at y $40, and at page 9, at y $B0. plan.py
    now reads those tables out of the game (loop_checks: found through
    the code's compares of $075F, $0725 and $00CE, not at a typed address;
    it finds World 4's two, World 7's six and World 8's three). In a
    castle with a check ahead, the --beam-high slots go to the move whose
    lookahead stands furthest on at the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
2026-10-19 PLAN: 5-1 cleared on the part
    One schedule from power-on, 845 entries, to WORLD 5-2 with no life
    lost: run 20261019-081032, 39,951 polls checked against the script
    The beam (--beam 4 --beam-high 1) crossed it on its own: 44 segments,
    about 56 minutes, nothing by hand.
    plan-log.md is pulled: 20 headings now, new drawing plan-log-5-1.svg.
    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
2026-10-19 PLAN: 5-2 cleared on the part
    One schedule from power-on, 902 entries, to WORLD 5-3 with no life
    lost: run 20261019-094241, 42,112 polls checked against the script
    The beam (--beam 4 --beam-high 1 --swim) stayed above ground and
    crossed it on its own: 43 segments, about 74 minutes, nothing by hand.
    plan-log.md is pulled: 21 headings now, new drawing plan-log-5-2.svg.
    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
2026-10-19 PLAN: 5-3 cleared on the part
    One schedule from power-on, 944 entries, to WORLD 5-4 with no life
    lost: run 20261019-104805, 44,023 polls checked against the script
    The beam (--beam 4 --beam-high 1) crossed it on its own: 36 segments,
    about 46 minutes, nothing by hand.
    plan-log.md is pulled: 22 headings now, new drawing plan-log-5-3.svg.
    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
2026-10-19 PLAN: 5-4 cleared on the part
    One schedule from power-on, 975 entries, to WORLD 6-1 with no life
    lost: run 20261019-115112, 45,892 polls checked against the script
    The beam (--beam 4 --beam-high 1) crossed World 5's castle on its own:
    33 segments, about 43 minutes, nothing by hand.
    plan-log.md is pulled: 23 headings now, new drawing plan-log-5-4.svg.
    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
2026-10-19 PLAN: 6-1 cleared on the part
    One schedule from power-on, 1,015 entries, to WORLD 6-2 with no life
    lost: run 20261019-130306, 47,971 polls checked against the script
    after the final reset, none wrong, none missing. Right after that
    reset the head saw polls 0 and 1 in one look ("2 latches in one look
    at 0") and logged only poll 1, so the check starts there; the schedule
    holds 00 until poll 200.
    The beam (--beam 4 --beam-high 1) crossed it on its own: 39 segments,
    about 51 minutes, nothing by hand.
    plan-log.md is pulled: 24 headings now, new drawing plan-log-6-1.svg.
2026-10-19 PLAN: 6-2 cleared on the part
    One schedule from power-on, 1,102 entries, to WORLD 6-3 with no life
    lost: run 20261019-144503, 50,393 polls checked against the script
    crossed it on its own: 51 segments, about 79 minutes, nothing by hand.
    plan-log.md is pulled: 25 headings now, new drawing plan-log-6-2.svg.
    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
2026-10-19 PLAN: 6-3 cleared on the part
    One schedule from power-on, 1,138 entries, to WORLD 6-4 with no life
    lost: run 20261019-160009, 52,202 polls checked against the script
    The beam (--beam 4 --beam-high 1) crossed it on its own: 34 segments,
    about 50 minutes, nothing by hand.
    plan-log.md is pulled: 26 headings now, new drawing plan-log-6-3.svg.
    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
2026-10-19 PLAN: 6-4 cleared on the part
    One schedule from power-on, 1,169 entries, to WORLD 7-1 with no life
    lost: run 20261019-172628, 54,022 polls checked against the script
    The beam (--beam 4 --beam-high 1) crossed World 6's castle on its own:
    31 segments, about 43 minutes, nothing by hand. The first bench run
    (20261019-170655) played every poll right but took no frames: the
    grabber gave up 900 s after starting, before this run's first grab;
    run again with the limit raised.
    plan-log.md is pulled: 27 headings now, new drawing plan-log-6-4.svg.
    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
2026-10-19 PLAN: 7-1 cleared on the part
    One schedule from power-on, 1,214 entries, to WORLD 7-2 with no life
    lost: run 20261019-191128, 56,061 polls checked against the script
    about 54 minutes, nothing by hand.
    plan-log.md is pulled: 28 headings now, new drawing plan-log-7-1.svg.
    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
2026-10-19 PLAN: 7-2 cleared on the part; a pipe passed stays passed
    One schedule from power-on, 1,353 entries, to WORLD 7-3 with no life
    lost: run 20261019-224836, 60,302 polls checked against the script
    The beam swam the water on its own and then stood at the exit pipe's
    mouth for twenty segments: that pipe keeps the area number and sets
    Mario back, and a pipe counted only inside a lookahead. With 39620a2
    (each position carries the pipes its own path entered), resumed from
    the beam's own state in front of the pipe: through in four segments,
    at the flag in eight, nothing by hand.
    plan-log.md is pulled: 29 headings now, new drawing plan-log-7-2.svg.
    be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
2026-10-19 PLAN: 7-3 cleared on the part
    One schedule from power-on, 1,393 entries, to WORLD 7-4 with no life
    lost: run 20261020-002836, 62,502 polls checked against the script
    The beam (--beam 4 --beam-high 1) crossed the bridges under the flying
    Cheep Cheeps on its own: 48 segments, about 72 minutes, nothing by
    hand.
    plan-log.md is pulled: 30 headings now, new drawing plan-log-7-3.svg.
    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
2026-10-20 PLAN: 7-4 cleared on the part, the six-check maze
    One schedule from power-on, 1,423 entries, past the axe to WORLD 8-1
    with no life lost: run 20261020-015615, 64,722 polls checked against
    the script after the final reset, none wrong, none missing.
    World 7's castle sends Mario back at six places, against 4-4's two.
    The checks read out of the game since a96cce5 carried all six, and the
    beam (--beam 4 --beam-high 1) passed every one on its own, never sent
    back: 43 segments, about an hour, nothing by hand.
    plan-log.md is pulled: 31 headings now, new drawing plan-log-7-4.svg.
2026-10-20 PLAN: 8-1 cleared on the part
    One schedule from power-on, 1,519 entries, to WORLD 8-2 with no life
    lost: run 20261020-042403, 68,102 polls checked against the script
    The longest level in the game. The beam (--beam 4 --beam-high 1)
    crossed it on its own: 89 segments, about two hours, nothing by hand.
    plan-log.md is pulled: 32 headings now, new drawing plan-log-8-1.svg.
    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
2026-10-20 PLAN: 8-2 cleared on the part
    One schedule from power-on, 1,573 entries, to WORLD 8-3 with no life
    lost: run 20261020-060340, 70,413 polls checked against the script
    The beam (--beam 4 --beam-high 1) crossed Lakitu's stairs on its own:
    48 segments, about 69 minutes, nothing by hand.
    plan-log.md is pulled: 33 headings now, new drawing plan-log-8-2.svg.
    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
2026-10-20 PLAN: 8-3 cleared on the part
    One schedule from power-on, 1,622 entries, to WORLD 8-4 with no life
    lost: run 20261020-074156, 72,573 polls checked against the script
    The beam (--beam 4 --beam-high 1) crossed the Hammer Bros on the
    castle walls on its own: 46 segments, about 67 minutes, nothing by
    plan-log.md is pulled: 34 headings now, new drawing plan-log-8-3.svg.
    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
2026-10-20 plan.py: a loop-back under Mario's feet is a page shift, once per check
    World 8's three maze checks want y $F0, a height standing Mario never
    has, so each fires whatever he does when the renderer reaches its page
    (screen left 1152, 2432, 3712). ExecGameLoopback takes four pages off
    Mario, the screen and the parser but not the block buffer or the
    picture: the world stays under him and he walks on in it, into the
    pipe past the check's column that the scroll cap ($70) kept him from
    before it. 4-4's rule called that x jump a death, and the beam stalled
    at x 1266 for two runs.
    In a world whose checks all want $F0 (UNCOND, read out of the ROM) the
    judge adds four pages back instead, and each beam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
2026-10-20 PLAN: 8-4 cleared on the part, the whole game
    One schedule from power-on, 1,752 entries, to the axe, Bowser and
    "THANK YOU MARIO!" with no life lost: run 20261020-192022, 77,402
    polls checked against the script after the final reset, none wrong,
    none missing. Thirty-two levels from the title screen to the princess
    in one run.
    8-4 is the one level the beam could not cross alone: World 8's checks
    fire whatever Mario does (the loop-back is a page shift, once per
    check, plan.py 5396d10), the wrong pipes are traps, and the two climbs
    (a hidden block hit, stood on and jumped from onto the raised pipe;
    the four-tile jump onto the water pipe) were searched by height with
    tools/plan-climb.py and spl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
2026-10-20 PLAN retrospective: the first game, and the flow of discovery drawn
    docs/plan-retro.md: the thinking (the model exact at the poll turns
    playing into searching), the approach (one schedule grown a level at a
    time behind five gates), what it cost (four days, about 26 hours of
    timed planner, 20 of 32 levels crossed by the beam alone, three
    stretches by hand, four bench runs repeated for the part), the
    challenges (4-2, the mazes, 7-2, 8-4, the instruments), what to change
    (the planner calling the climb itself, exits read from the ROM, rules
    judged on the model's own facts, a kept clock, replay checkpoints,
    cleanup, grab polls from the trace) and next steps (a second game, a
    closed loop where lat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
